wildwoodashes/nixie_clock/doc/slike-pictures/seven.jpg

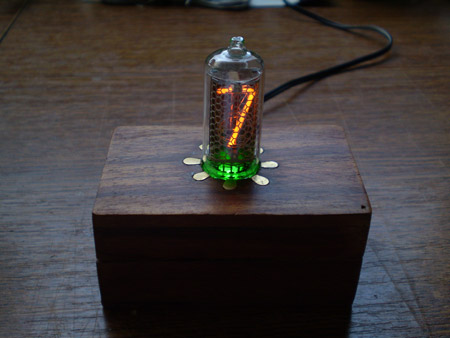
doc/slike-pictures/seven.jpg
