wildwoodashes/nixie_clock/doc/pcb/pcb_top.jpg

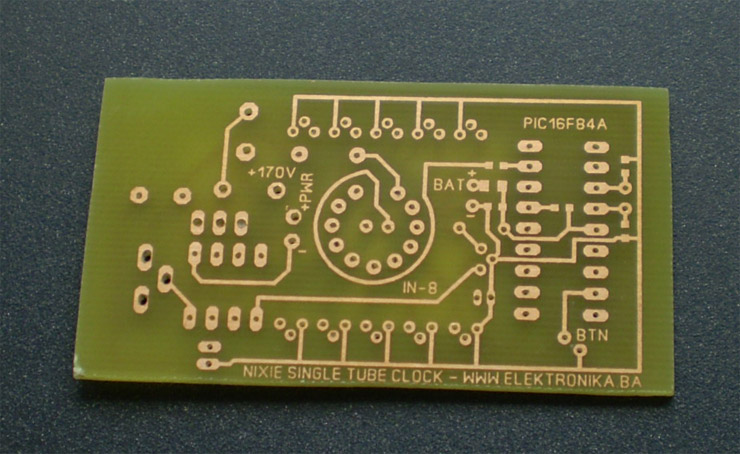
doc/pcb/pcb_top.jpg
