wildwoodashes/nixie_clock/doc/pcb/README.txt

Ploèica je crtana u sPrint-Layout programu
/PCB is in sPrint-Layout format

FILE: nixieclk.LAY
