wildwoodashes/nixie_clock/doc/dat-in-8.gif

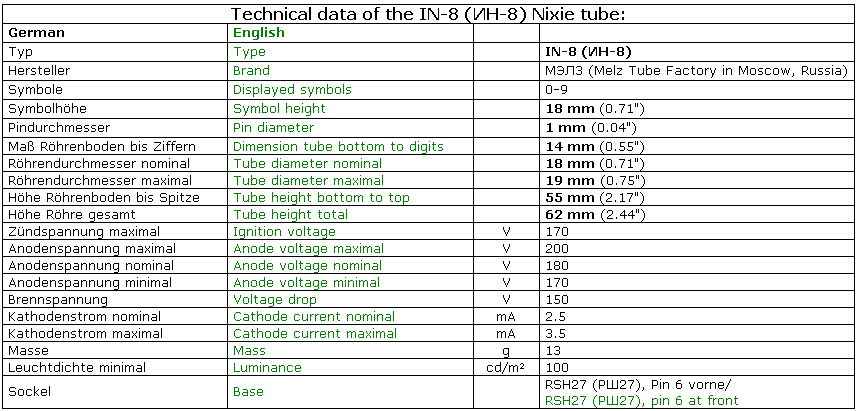
doc/dat-in-8.gif
