wildwoodashes/nixie_clock/doc/nixie_tube_datasheets/in8-base.jpg

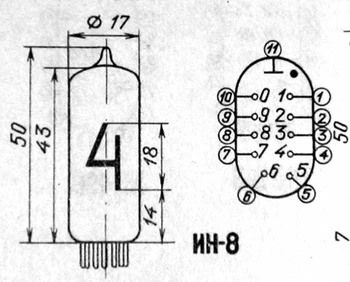
doc/nixie_tube_datasheets/in8-base.jpg
