wildwoodashes/nixie_clock/doc/nixie_tube_datasheets/Pinout.PNG

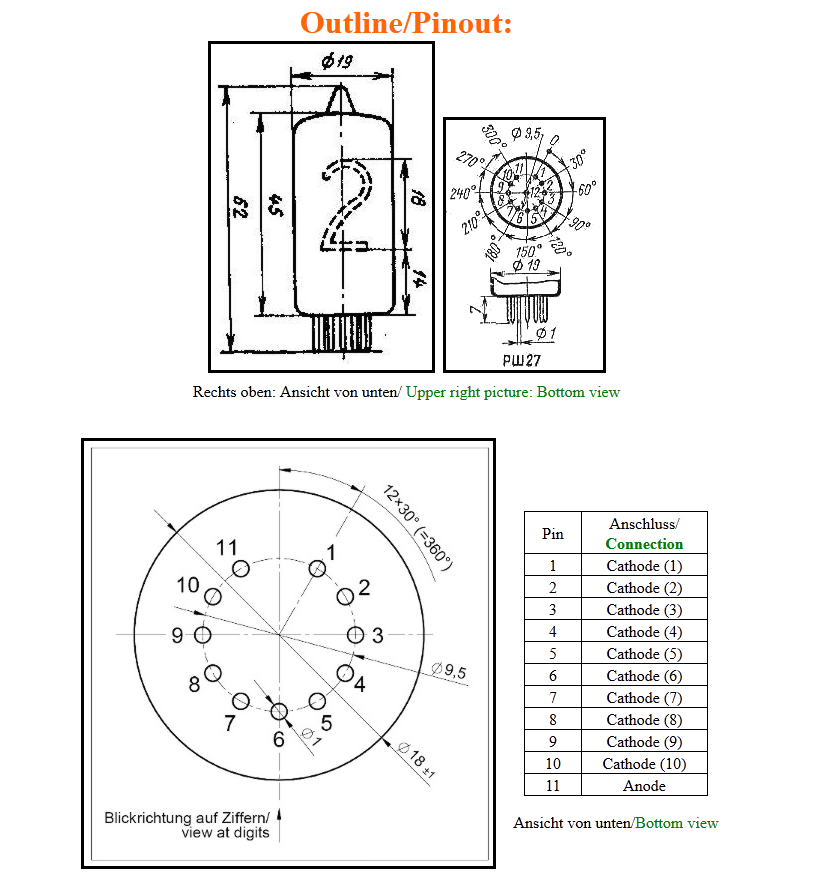
doc/nixie_tube_datasheets/Pinout.PNG
