wildwoodashes/nixie_clock/doc/pcb/pcb_bottom.gif

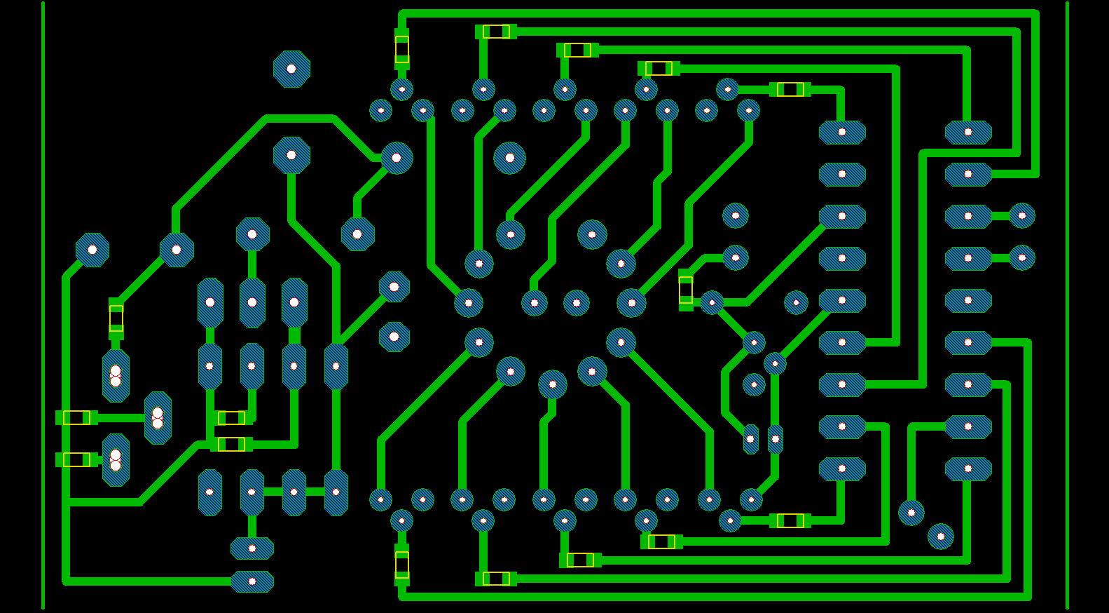
doc/pcb/pcb_bottom.gif
