wildwoodashes/nixie_clock/doc/pcb/pcb_bottom.jpg

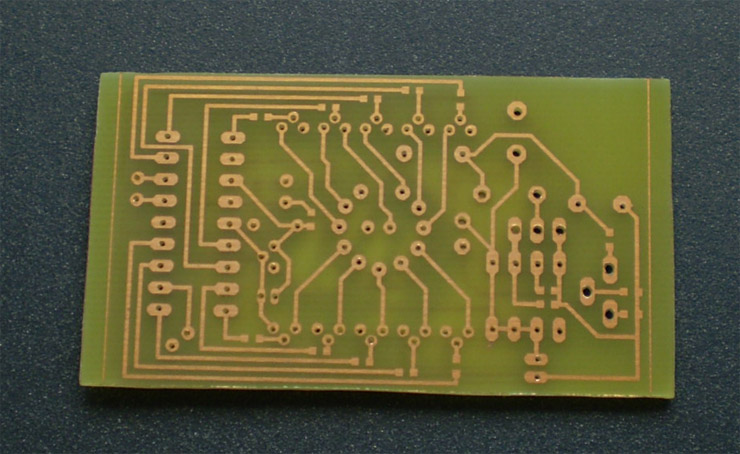
doc/pcb/pcb_bottom.jpg
