wildwoodashes/nixie_clock/doc/pcb/pcb_top.gif

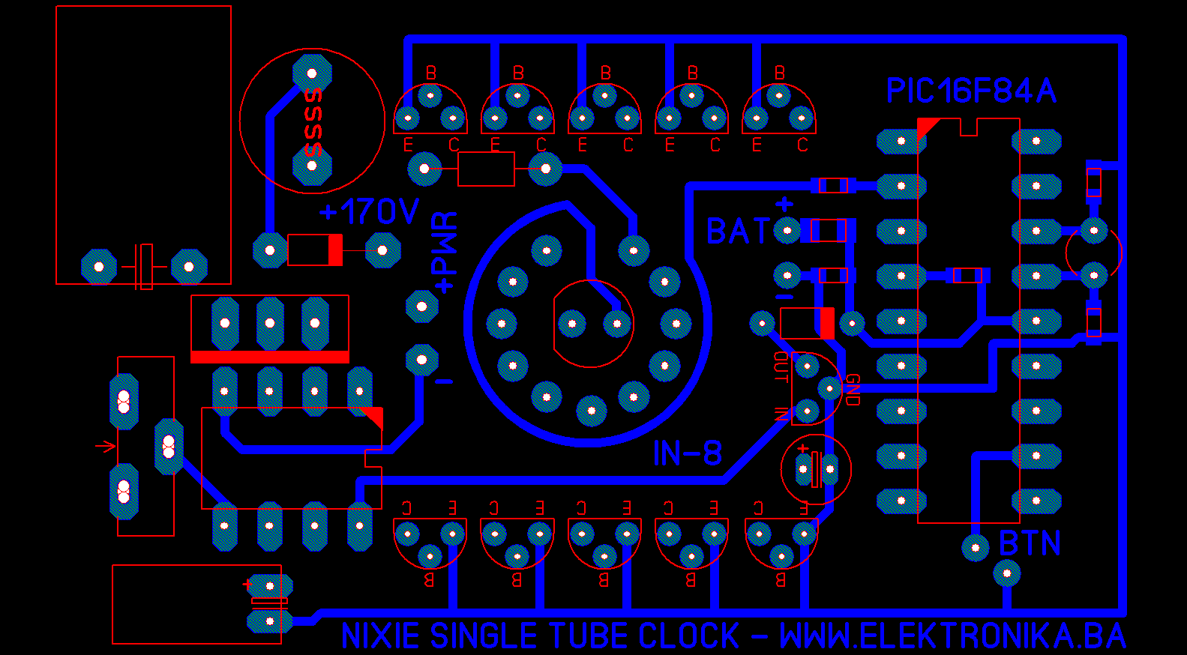
doc/pcb/pcb_top.gif
