wildwoodashes/nixie_clock/doc/shema-schematics/shema.png

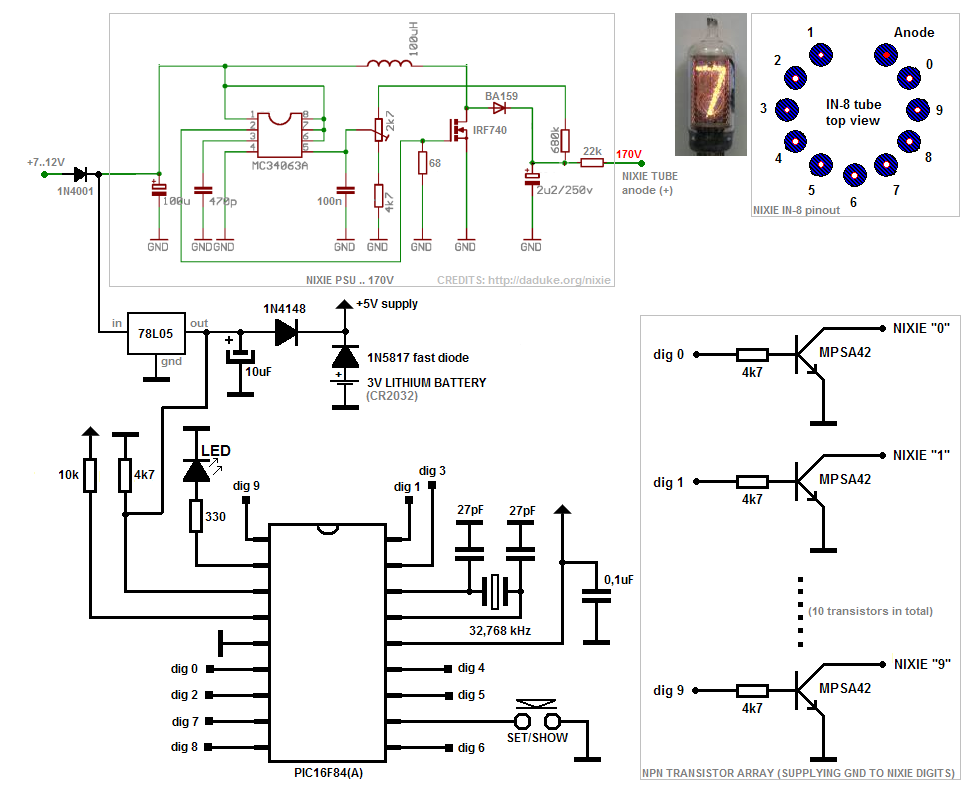
doc/shema-schematics/shema.png
