wildwoodashes/nixie_clock/doc/slike-pictures/back_side.jpg

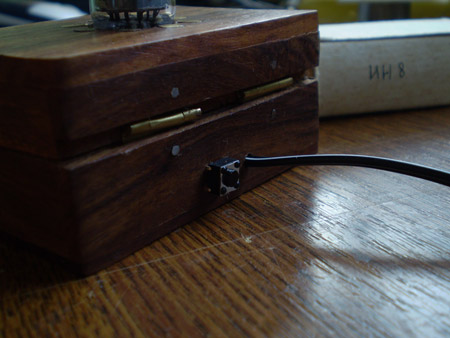
doc/slike-pictures/back_side.jpg
