wildwoodashes/nixie_clock/doc/slike-pictures/just_led.jpg

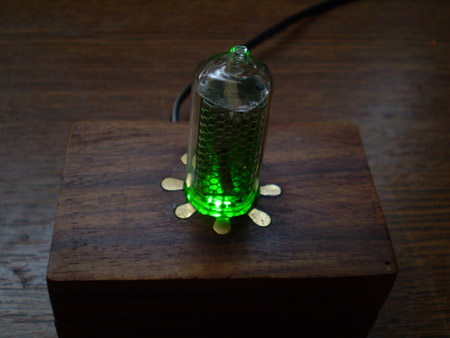
doc/slike-pictures/just_led.jpg
