wildwoodashes/nixie_clock/doc/slike-pictures/open.jpg

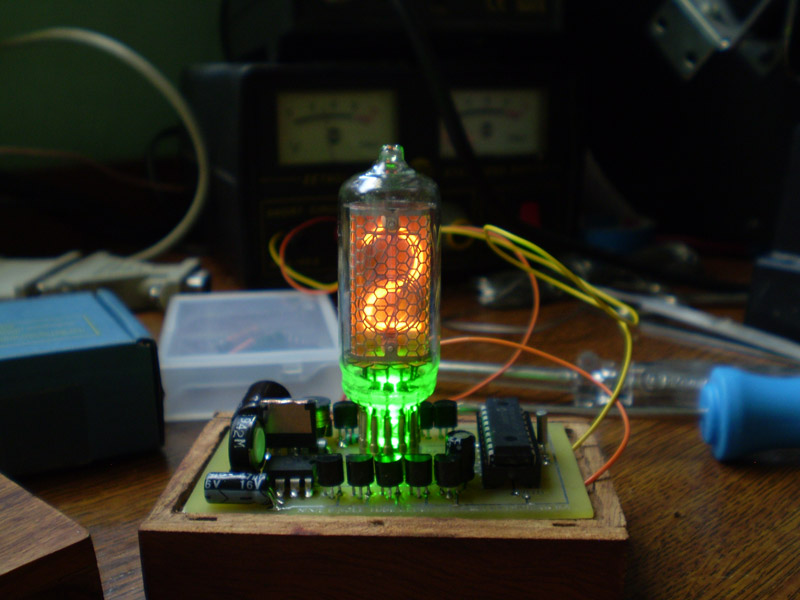
doc/slike-pictures/open.jpg
