wildwoodashes/nixie_clock/doc/slike-pictures/open_eight.jpg

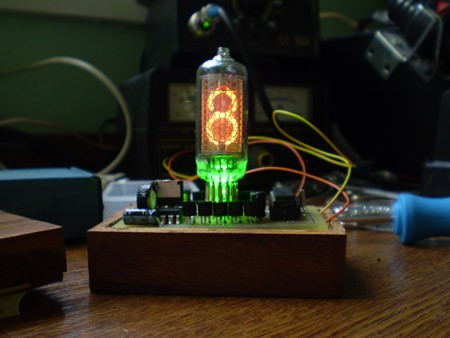
doc/slike-pictures/open_eight.jpg
