wildwoodashes/nixie_clock/doc/slike-pictures/two.jpg

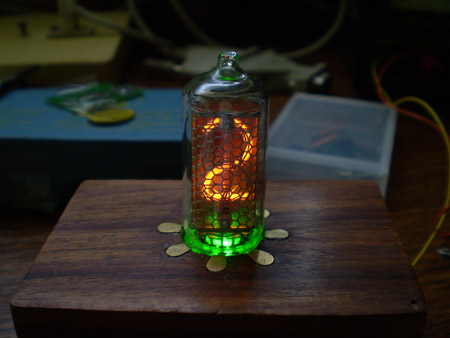
doc/slike-pictures/two.jpg
