wildwoodashes/nixie_clock/doc/pcb/pcb_bottom_parts.gif

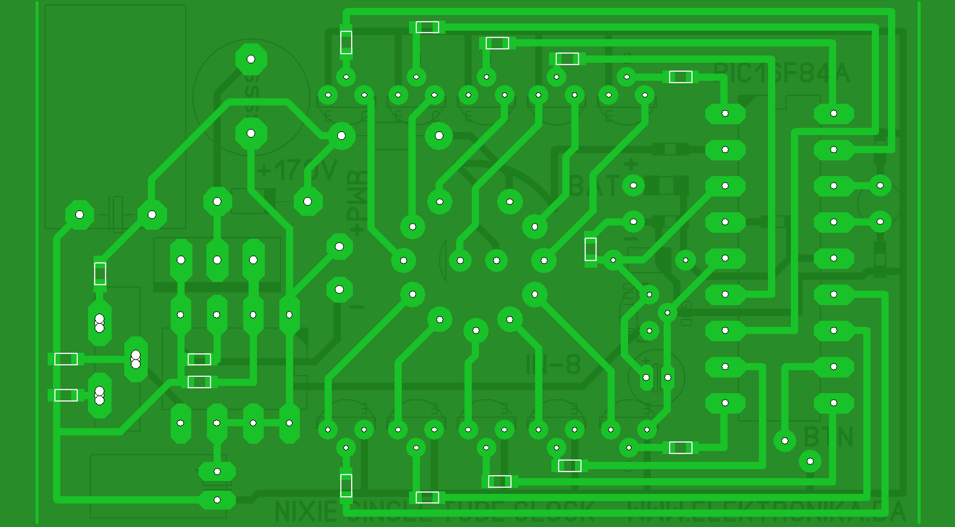
doc/pcb/pcb_bottom_parts.gif
