wildwoodashes/nixie_clock/doc/pcb/pcb_top_parts.gif

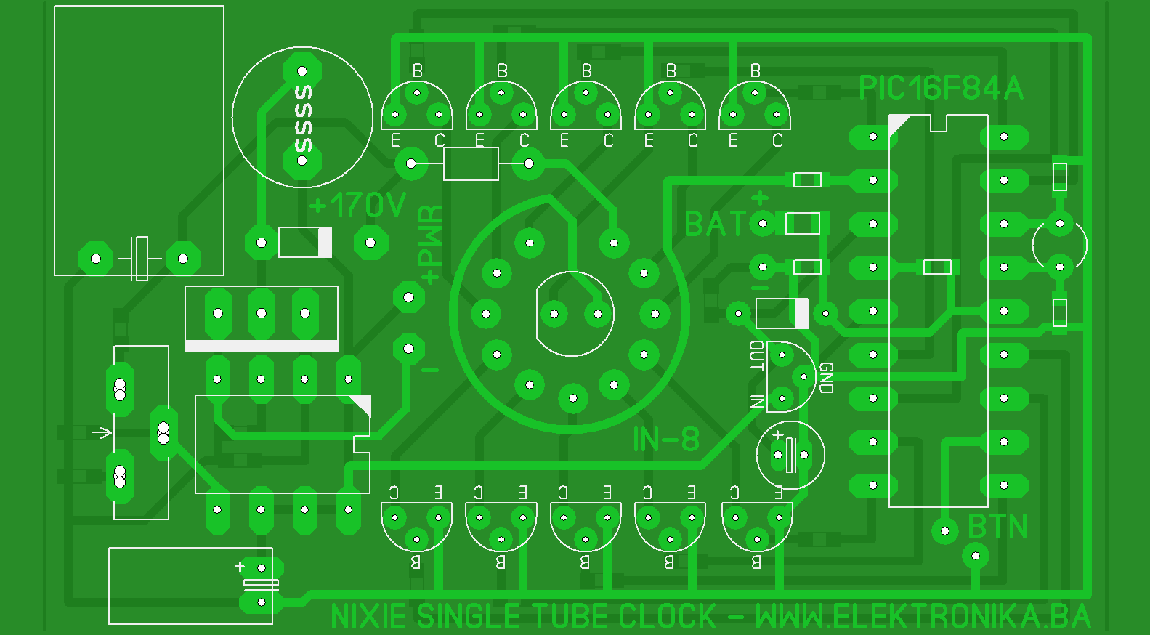
doc/pcb/pcb_top_parts.gif
