wildwoodashes/nixie_clock/hw/control_board_v1_0.pdf

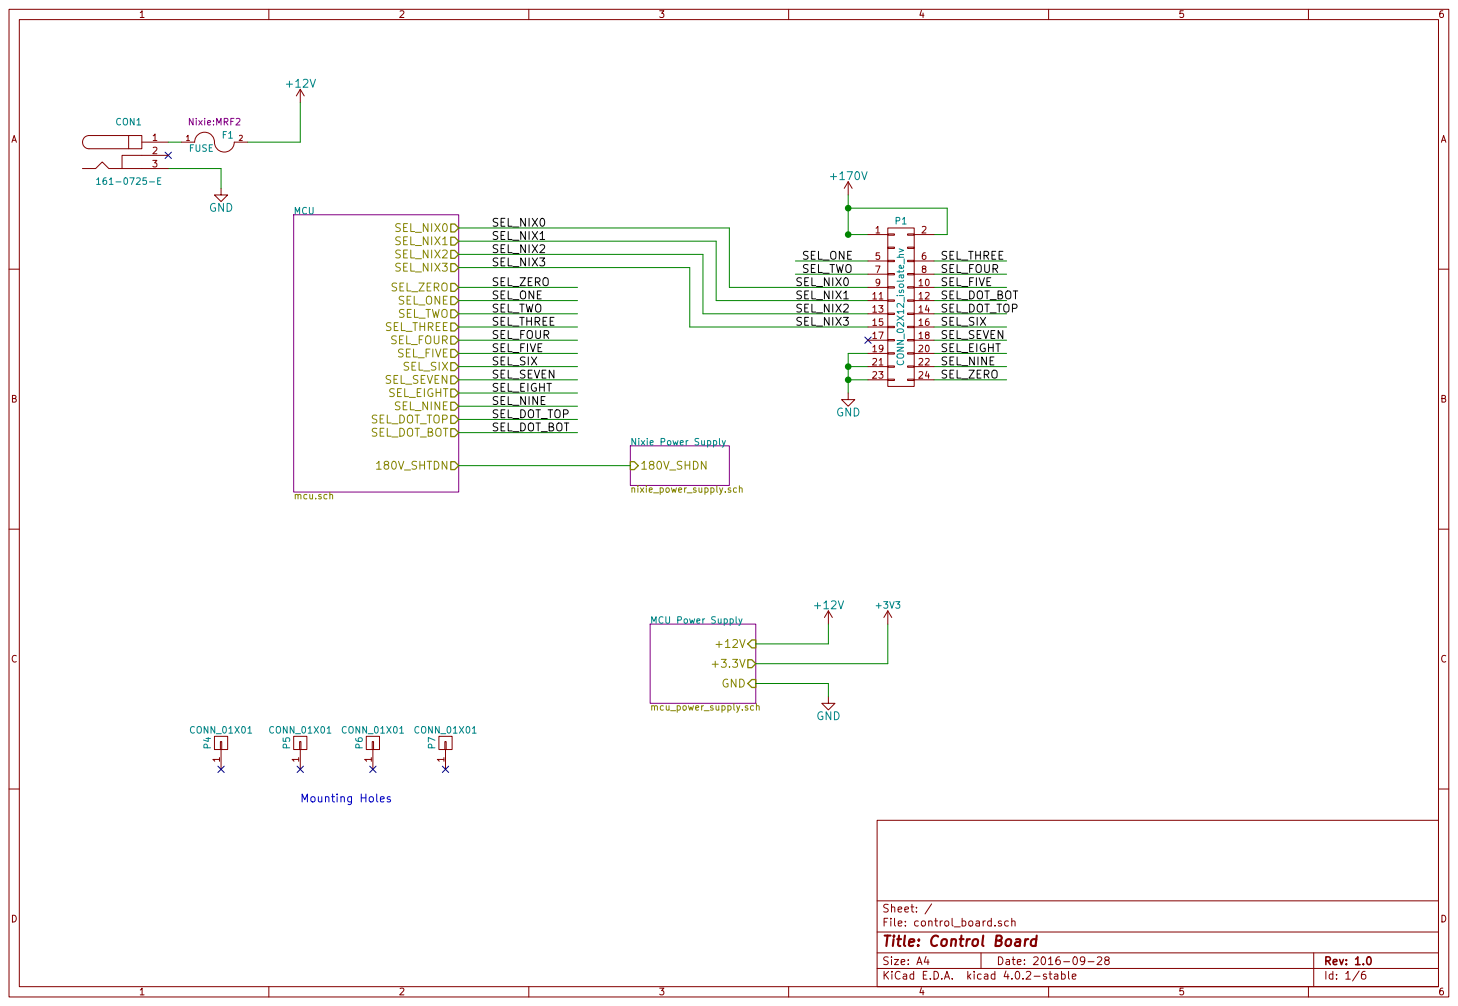
[picture p17: page 1]

SEL_NIX0 SEL_NIX1 SEL_NIX2 SEL_NIX3 SEL_TWO SEL_FOUR SEL_SEVEN SEL_DOT_TOP 180V_SHTDN | SEL_SIX

SEL_NIX1
SEL_NIX2
SEL_NIX3

20 SEL_EIGHT

21 | SEL_NINE 22
23 | 24

180V_SHDN

File: control_board.sch Sheet: /
Id: 1/6 Title: Control Board

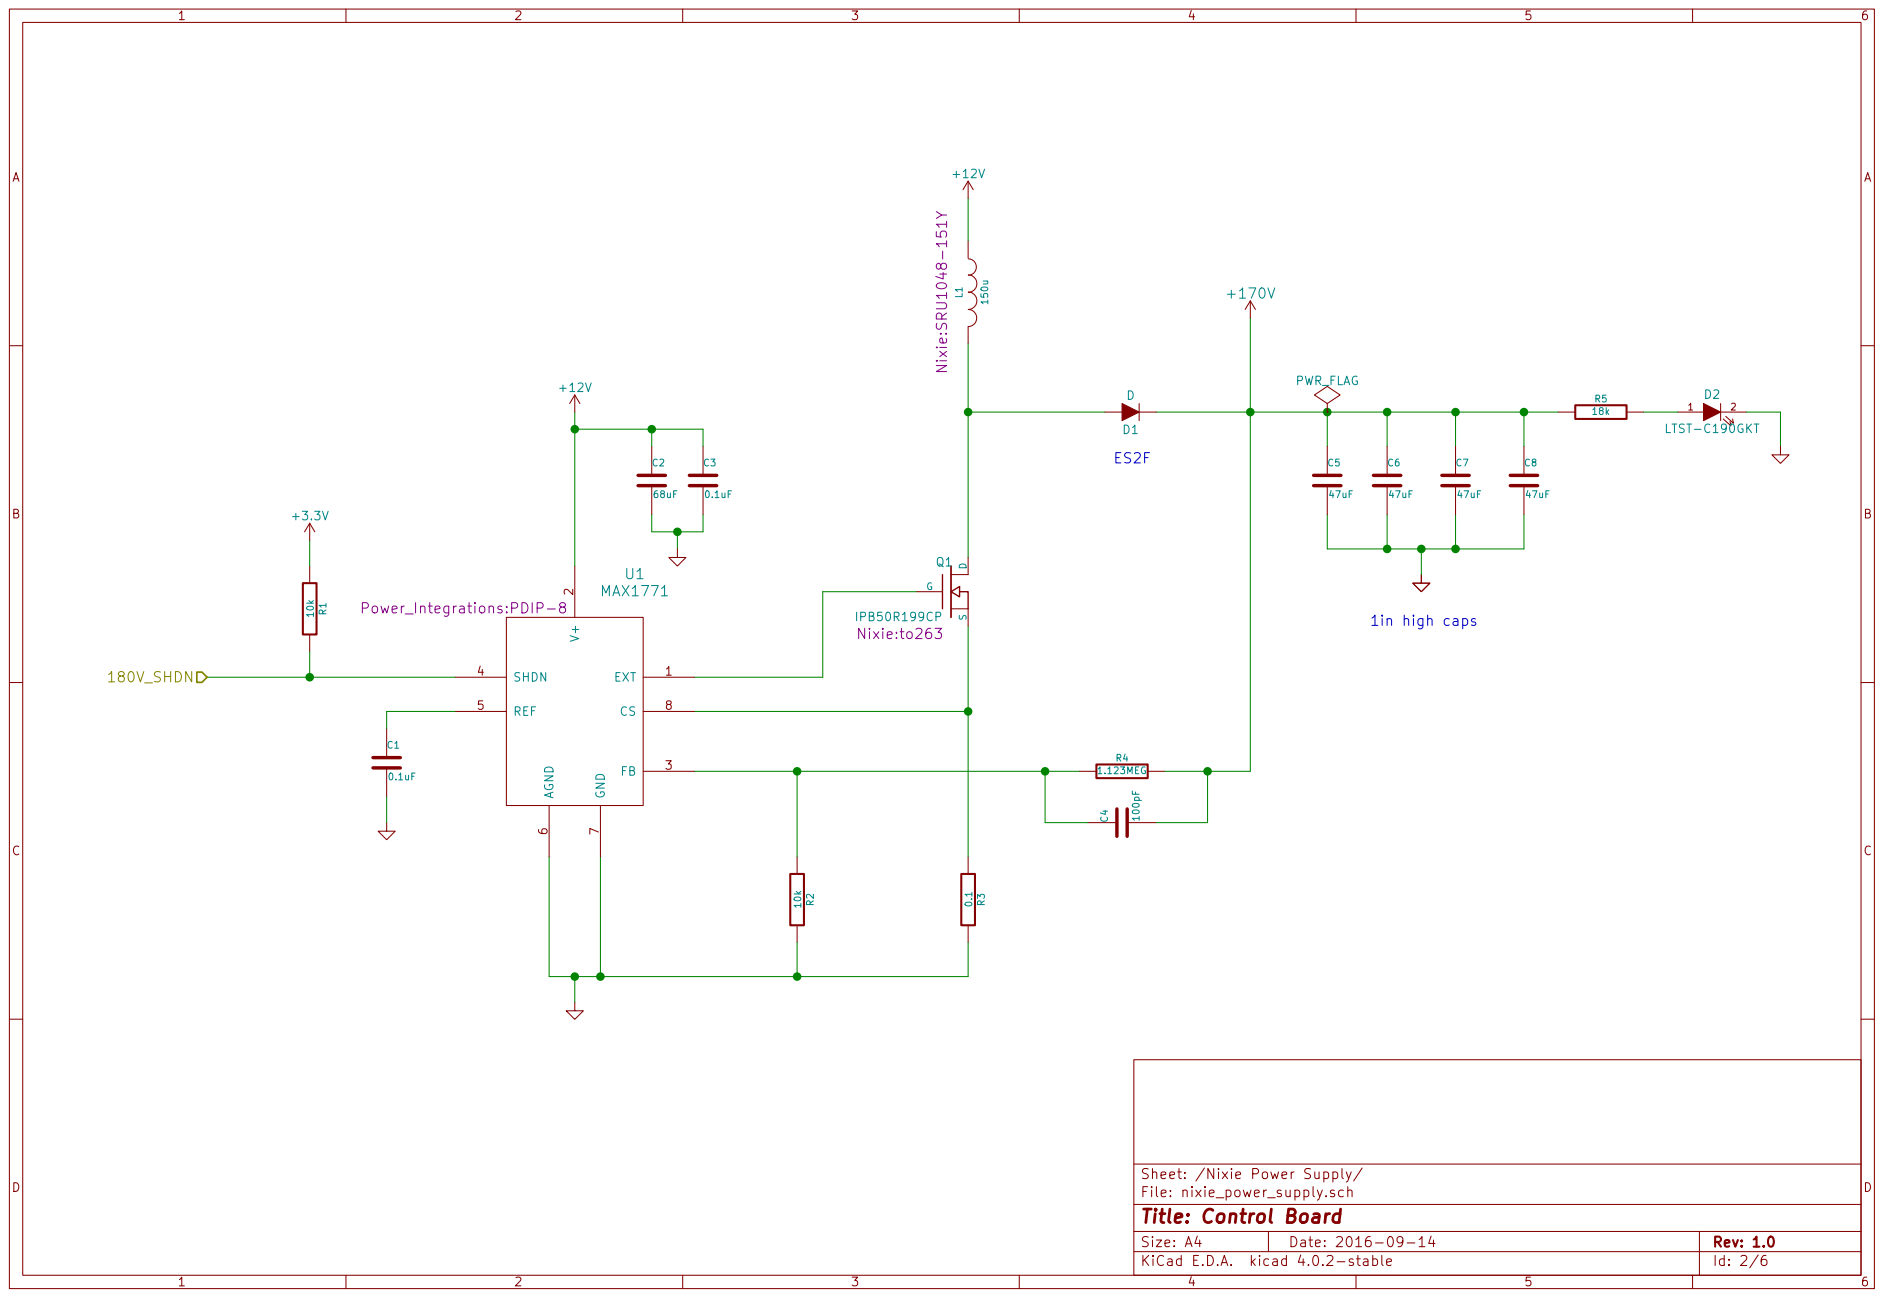
[picture p18: page 2]

2 FB 3 SHDN 4 REF 5 AGND

File: nixie_power_supply.sch
Id: 2/6 Title: Control Board

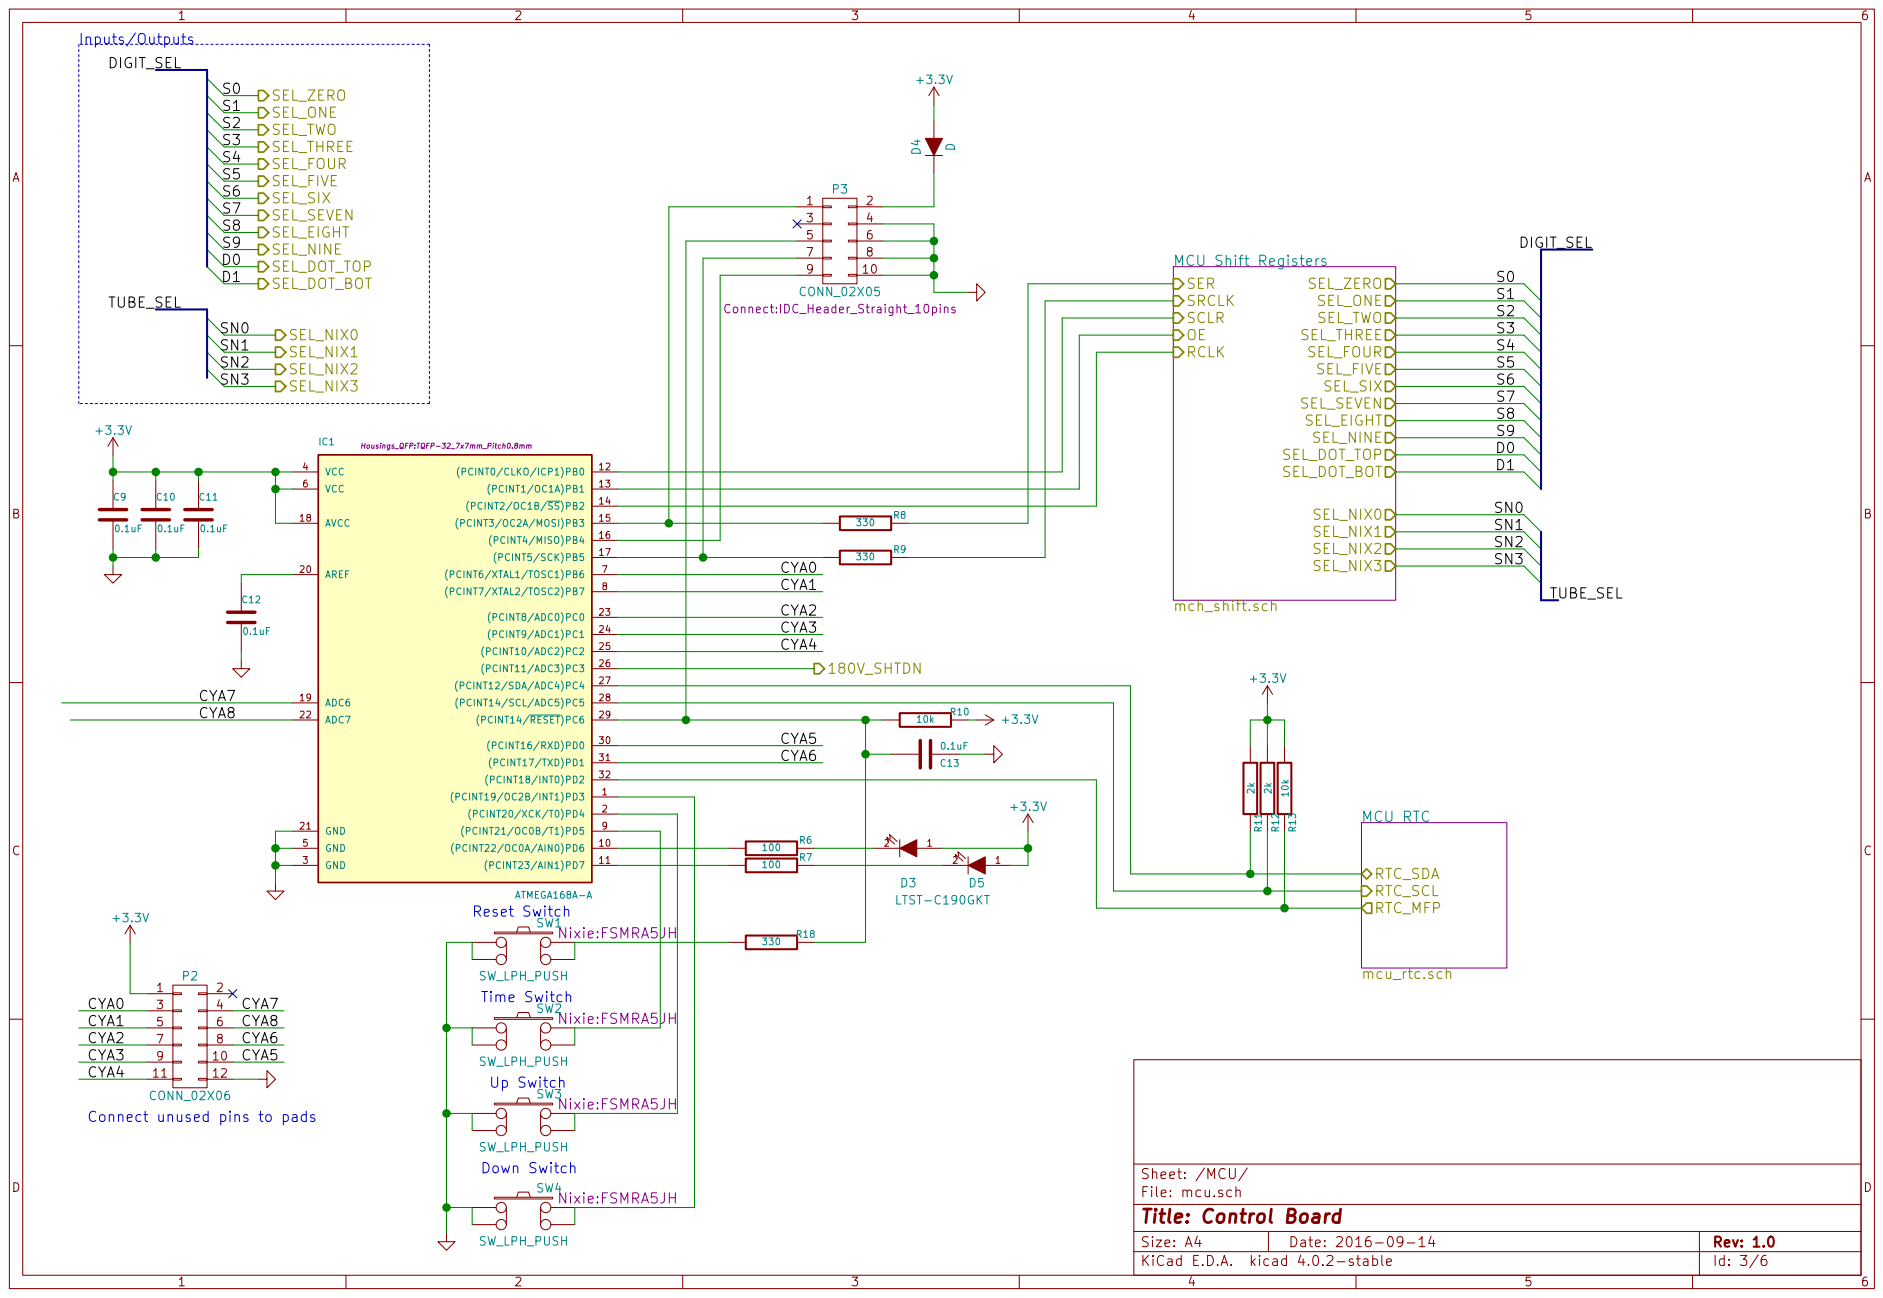
[picture p19: page 3]

File: mcu.sch Sheet: /MCU/
Id: 3/6 Title: Control Board

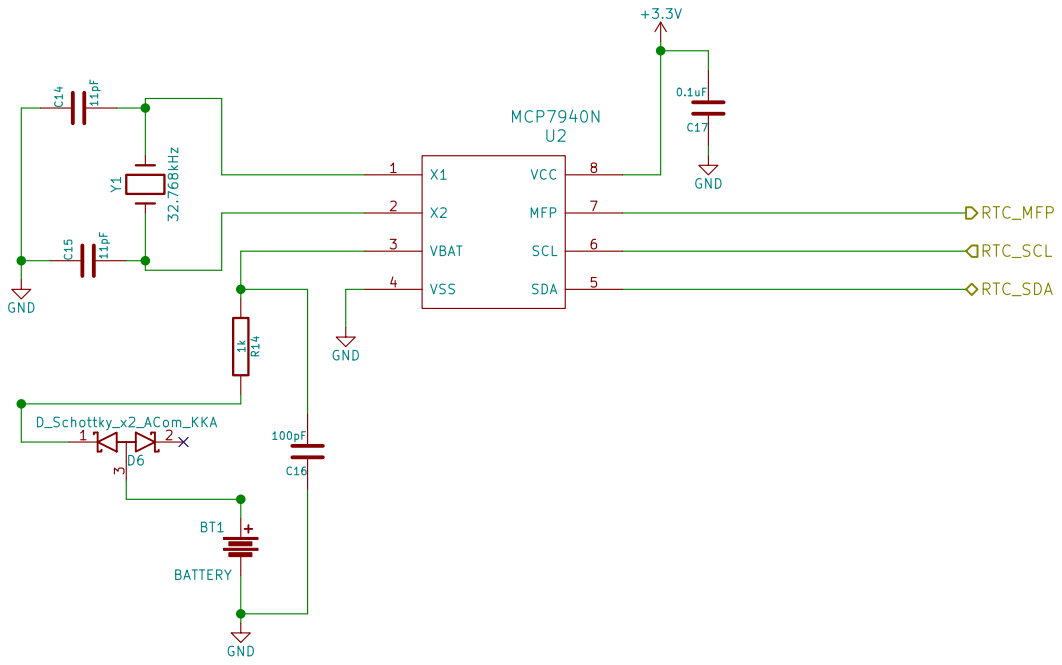
[picture p20: page 4]

Id: 4/6 Title: Control Board

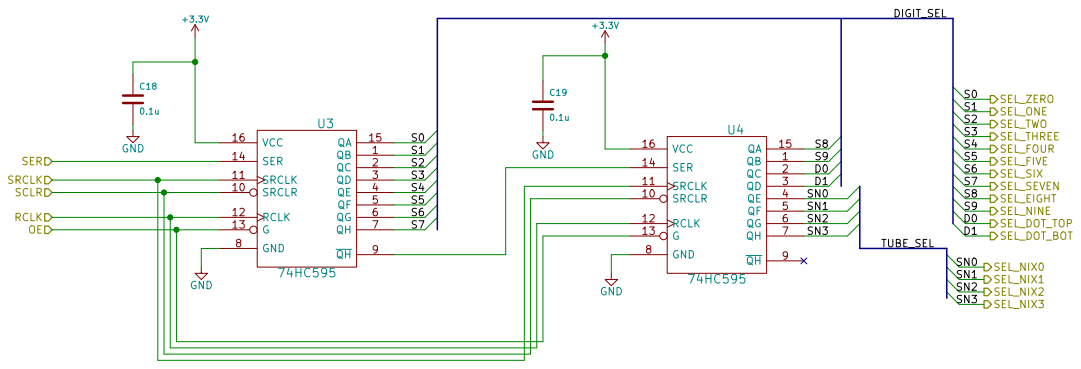
[picture p21: page 5]

Sheet: /MCU/MCU Shift Registers/
File: mch_shift.sch
Id: 5/6 Title: Control Board

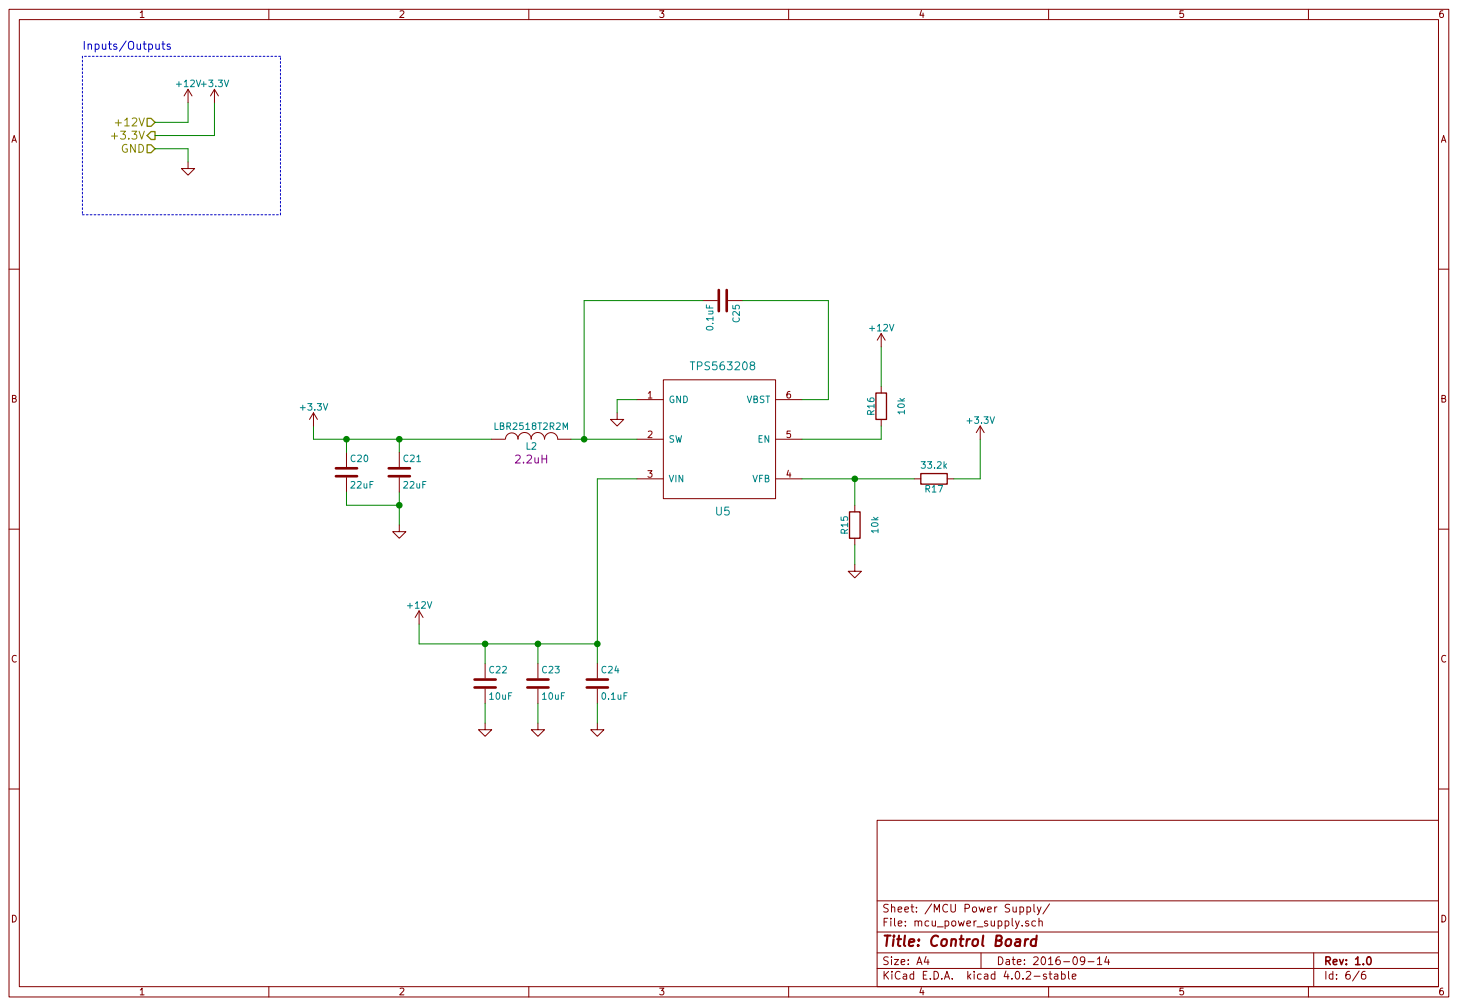
[picture p22: page 6]

Sheet: /MCU Power Supply/
File: mcu_power_supply.sch
Id: 6/6 Title: Control Board
