wildwoodashes/nixie_clock/hw/tube_shield_v1_0.pdf

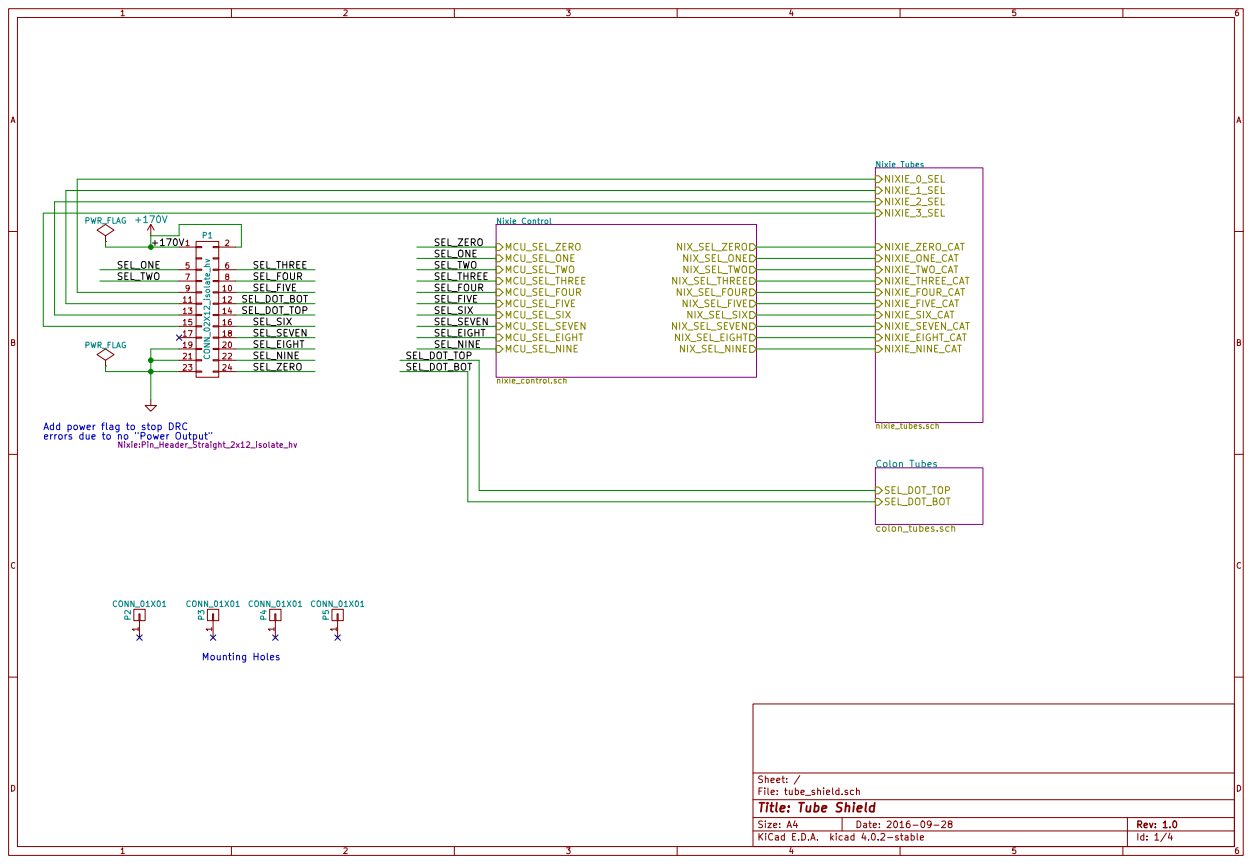
[picture p23: page 1]

NIX_SEL_NINE PWR_FLAG Add power flag to stop DRC

errors due to no "Power Output" 1 P2 CONN_01X01

File: tube_shield.sch Sheet: /
Id: 1/4 Title: Tube Shield

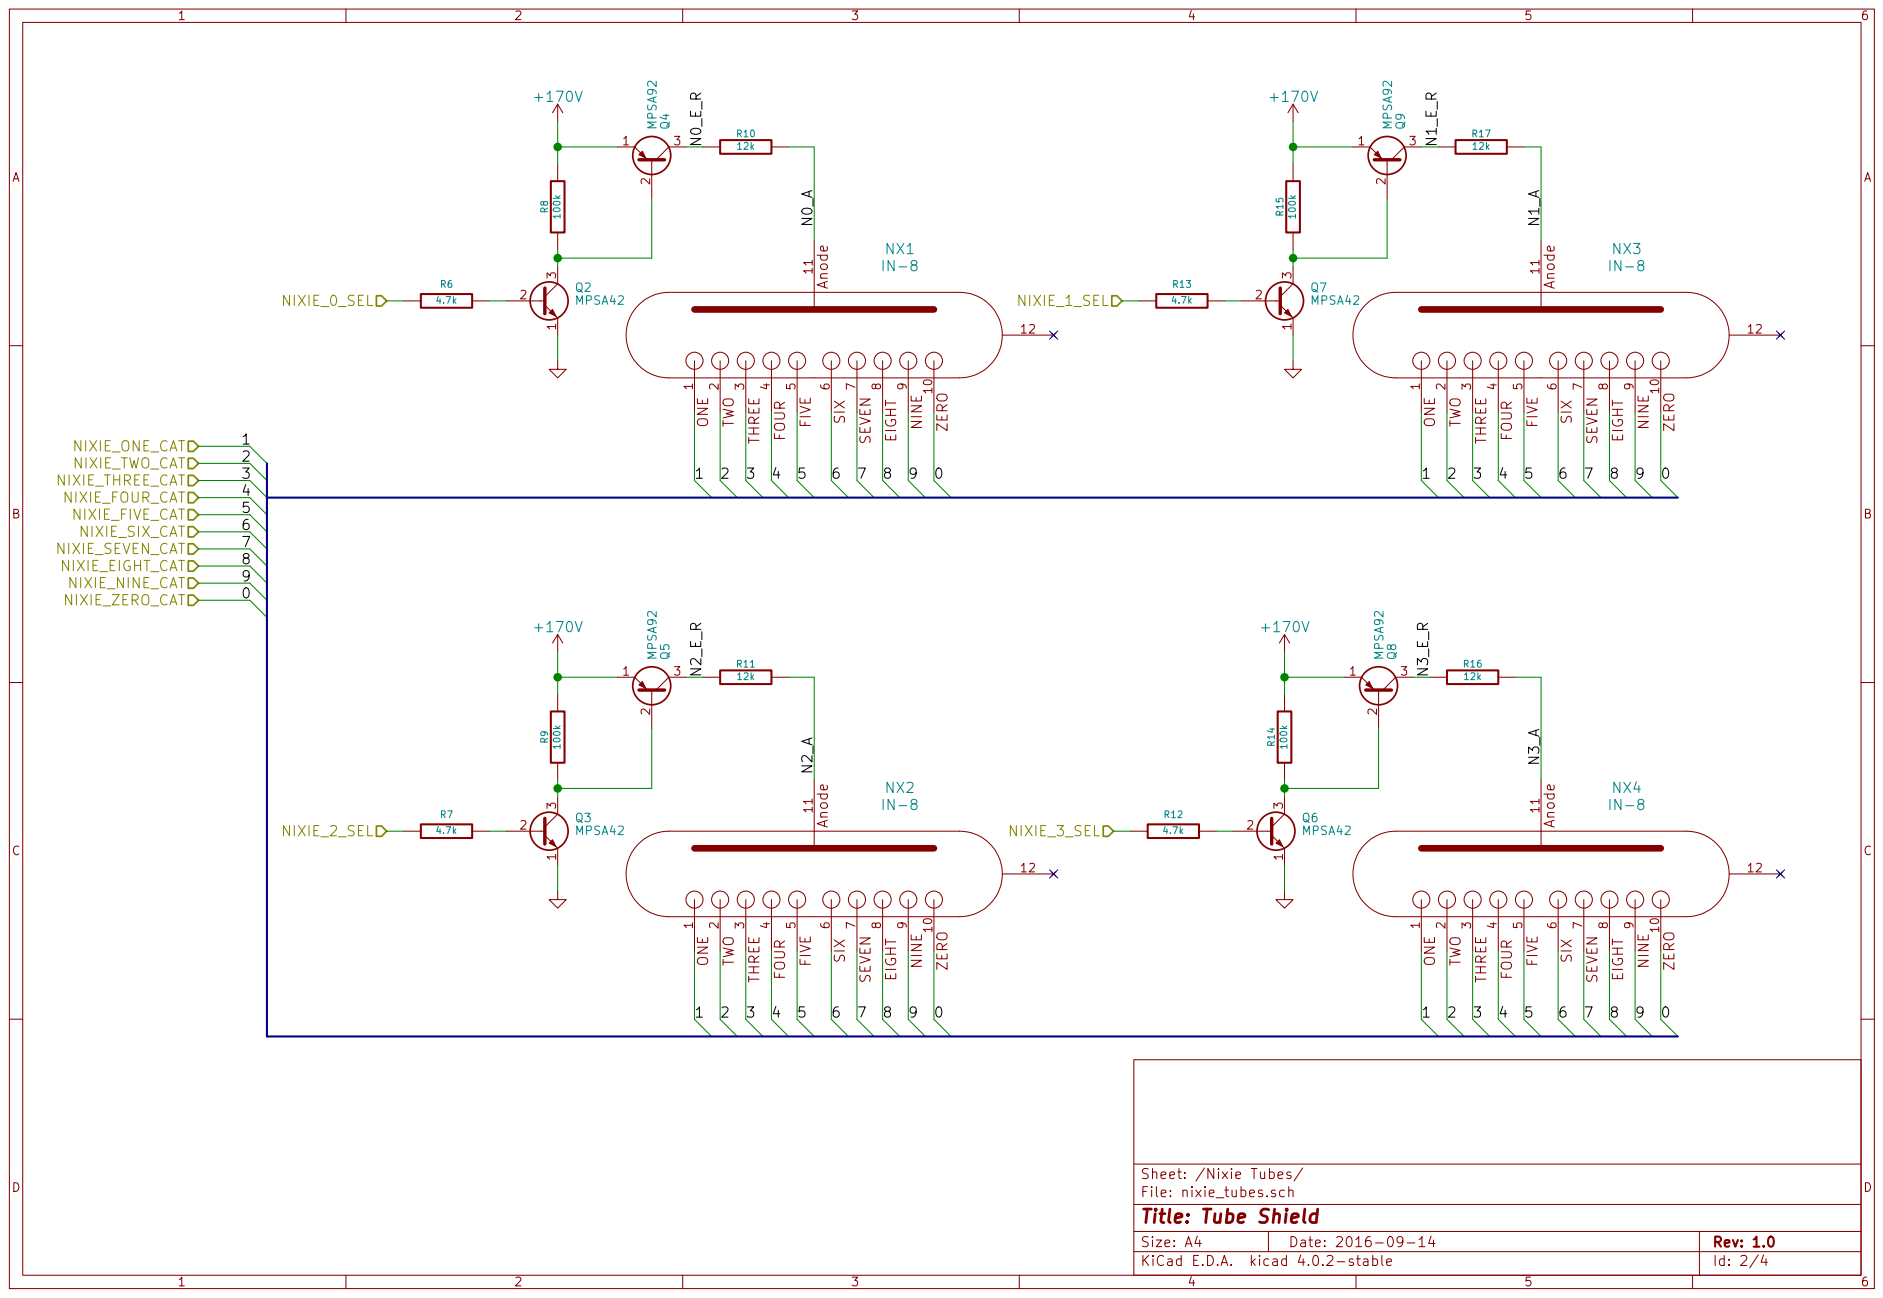
[picture p24: page 2]

File: nixie_tubes.sch Sheet: /Nixie Tubes/
Id: 2/4 Title: Tube Shield

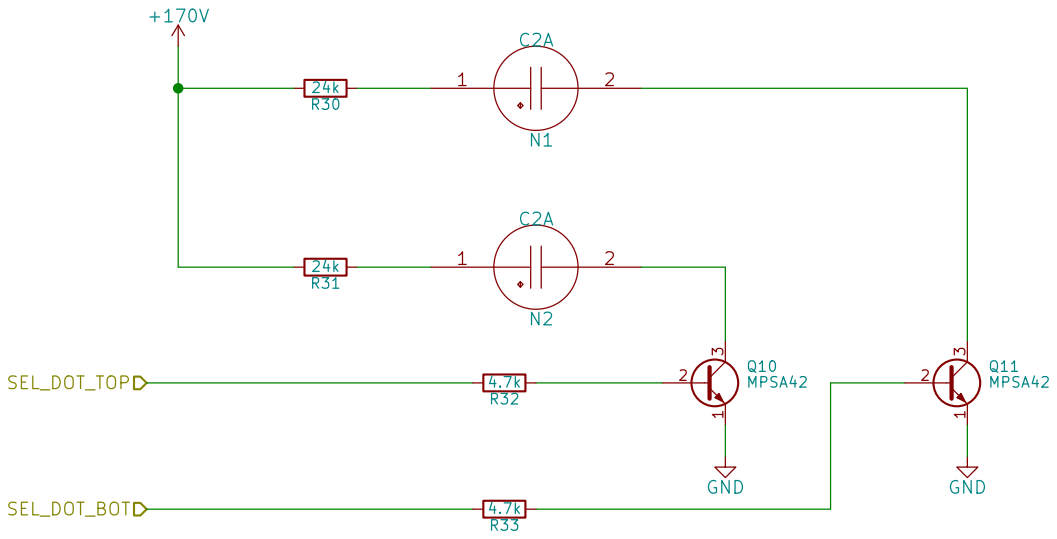
[picture p25: page 3]

File: colon_tubes.sch Sheet: /Colon Tubes/ .

Id: 3/4 Title: Tube Shield

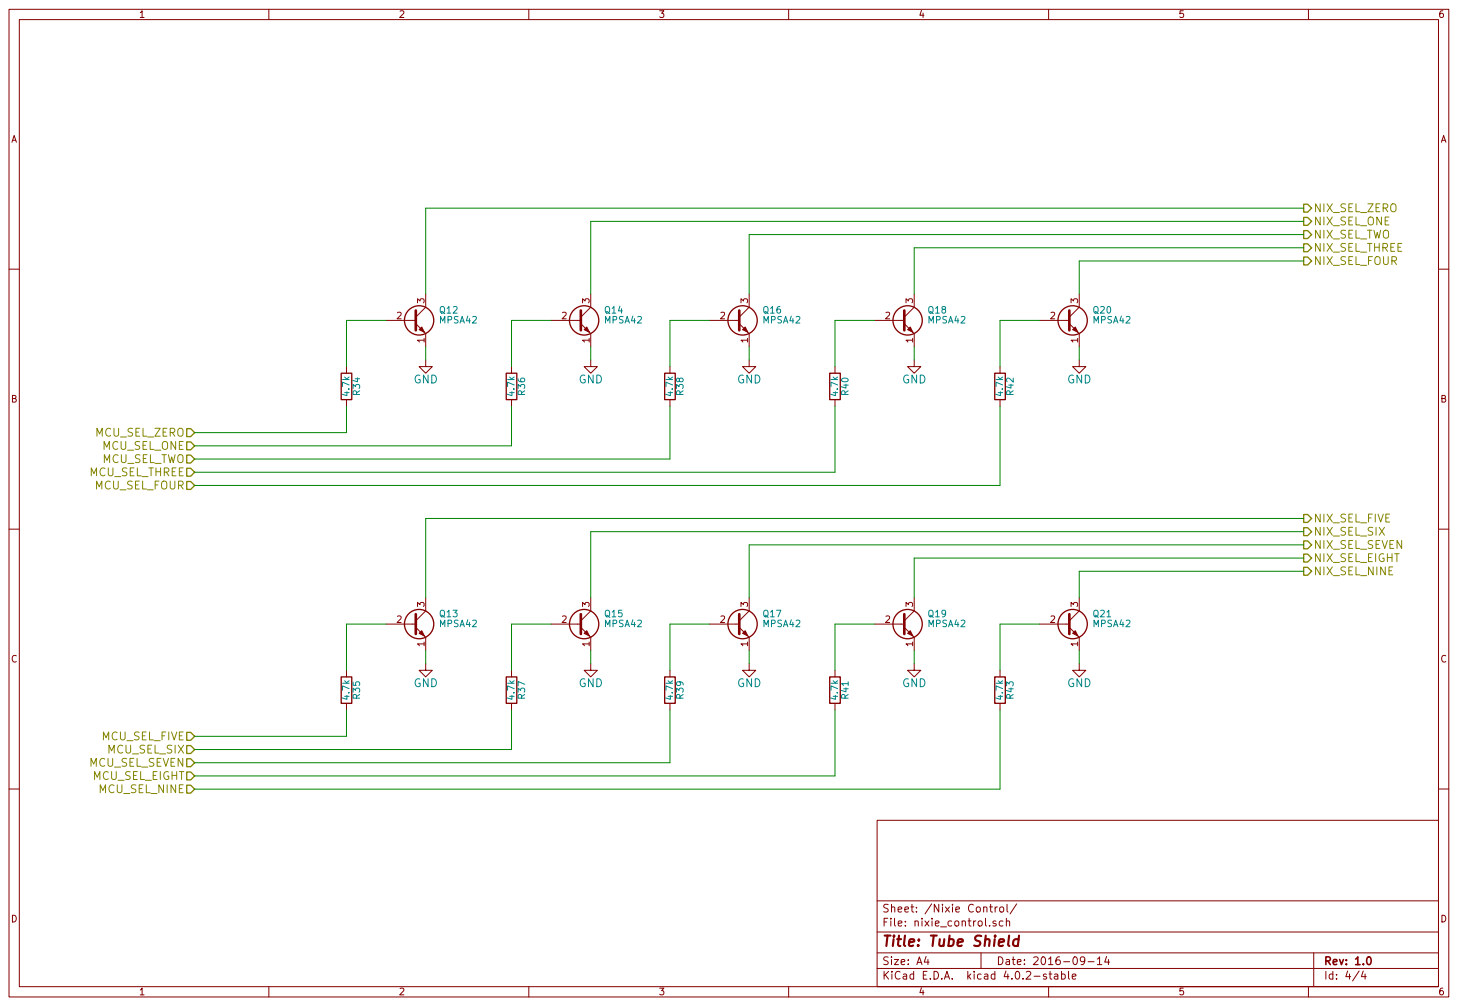
[picture p26: page 4]

Id: 4/4 Title: Tube Shield
