wildwoodashes/nixie_clock/hw/kicad_v1_1/projects/control_board/gerbers/control_board.pdf

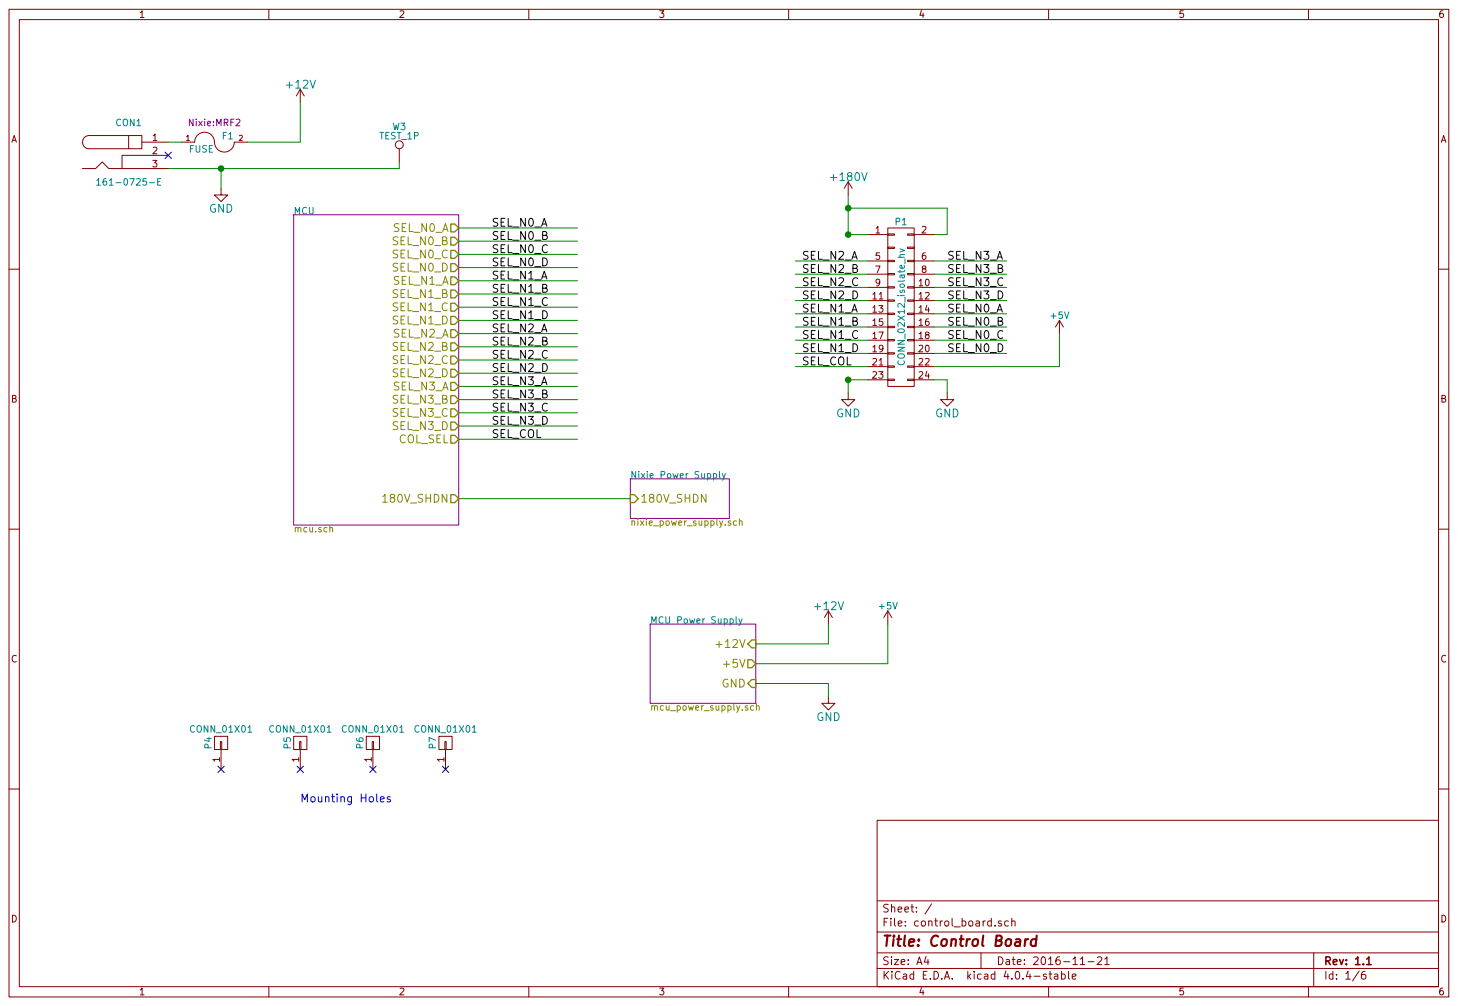
[picture p27: page 1]

SEL_N0_B SEL_N0_C SEL_N0_D SEL_N1_A SEL_N1_B SEL_N1_C SEL_N1_D SEL_N2_A SEL_N2_B SEL_N2_C SEL_N2_D SEL_N3_A SEL_N3_B SEL_N3_C SEL_N3_D 180V_SHDN

File: control_board.sch Sheet: / Nixie Power Supply

180V_SHDN

Id: 1/6 Title: Control Board

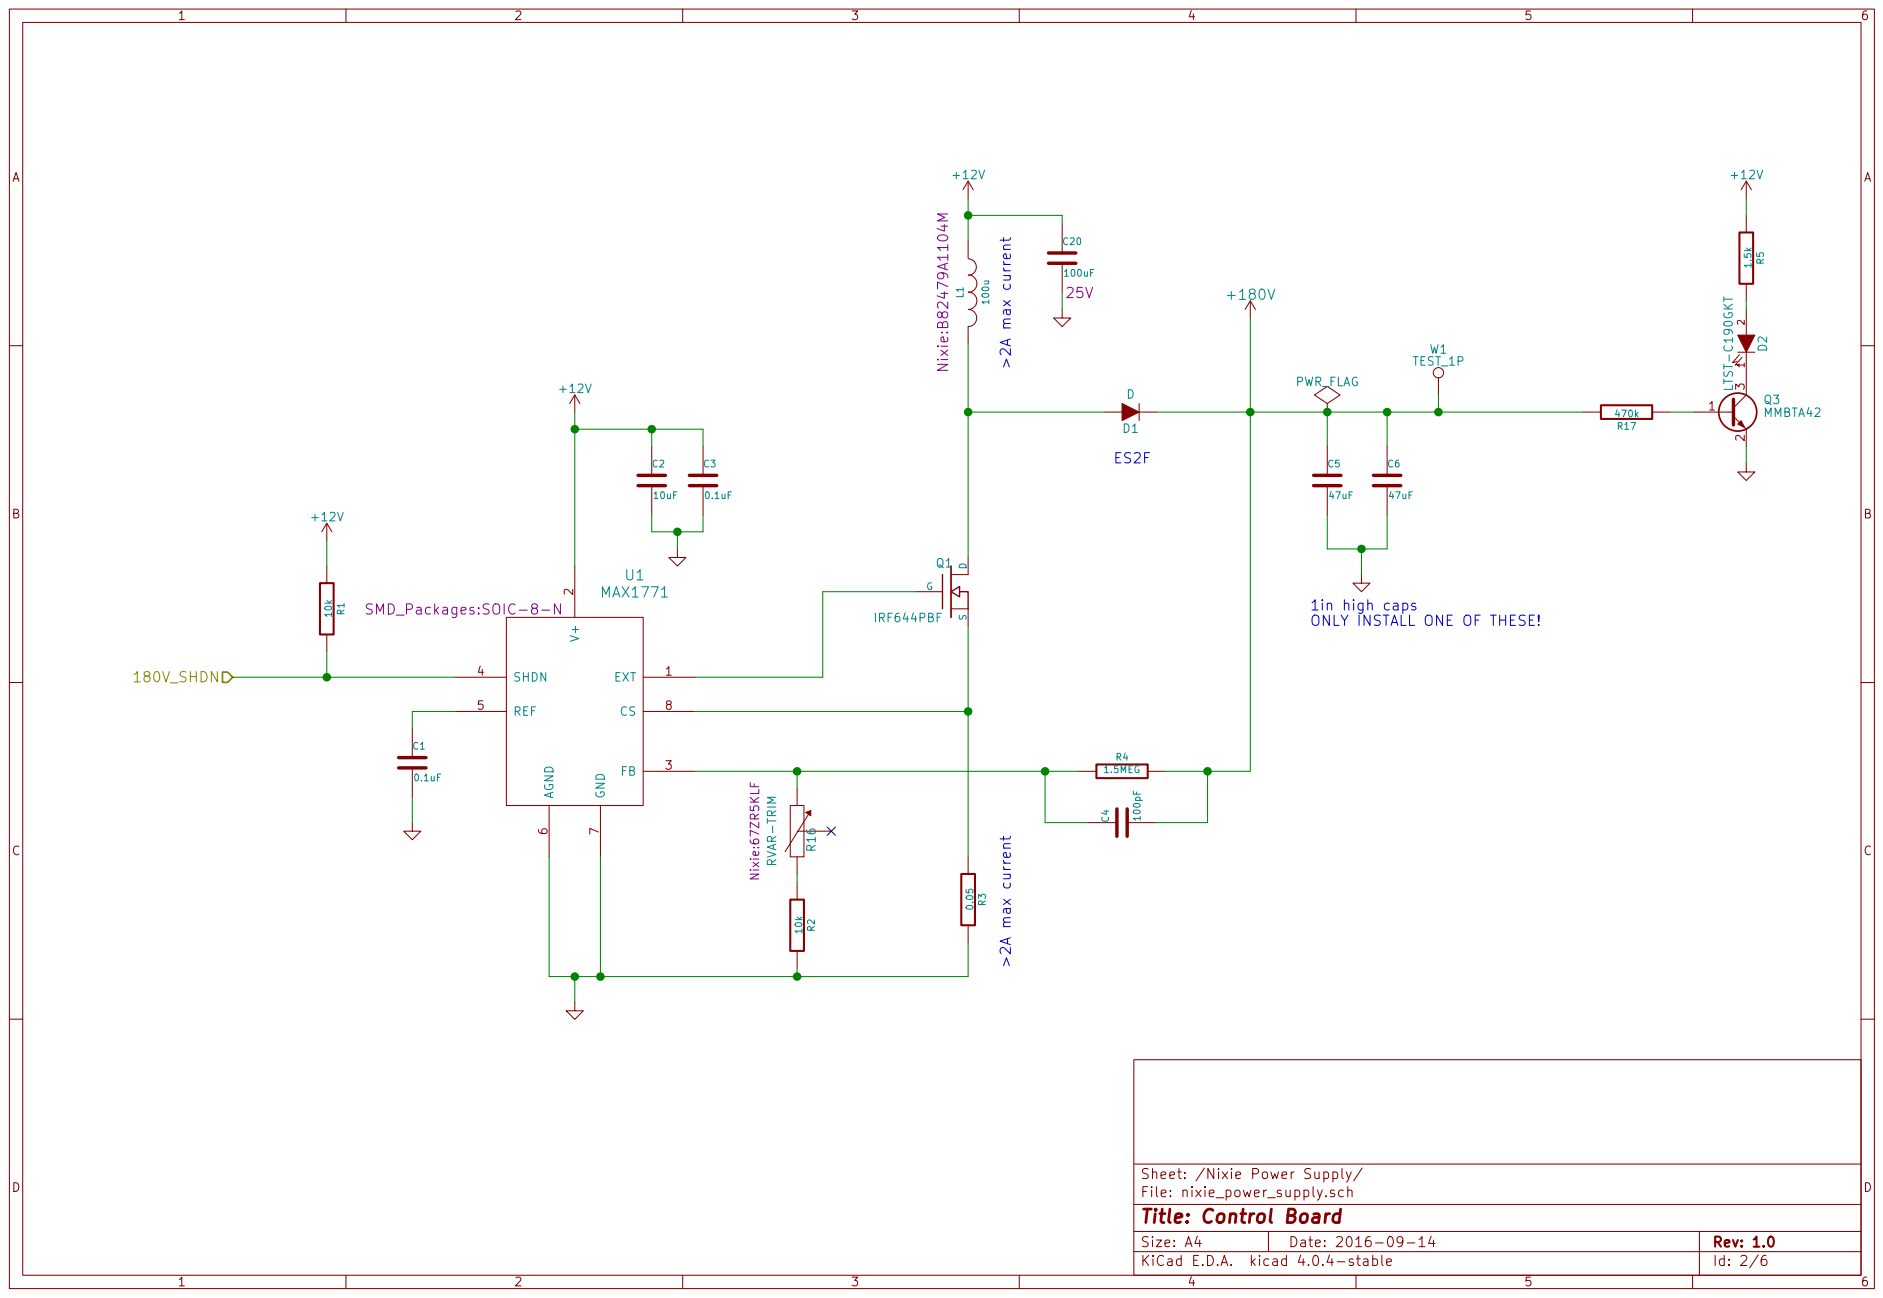
[picture p28: page 2]

2 FB 3 SHDN 4 REF 5 AGND

1in high caps
ONLY INSTALL ONE OF THESE!

File: nixie_power_supply.sch
Id: 2/6 Title: Control Board

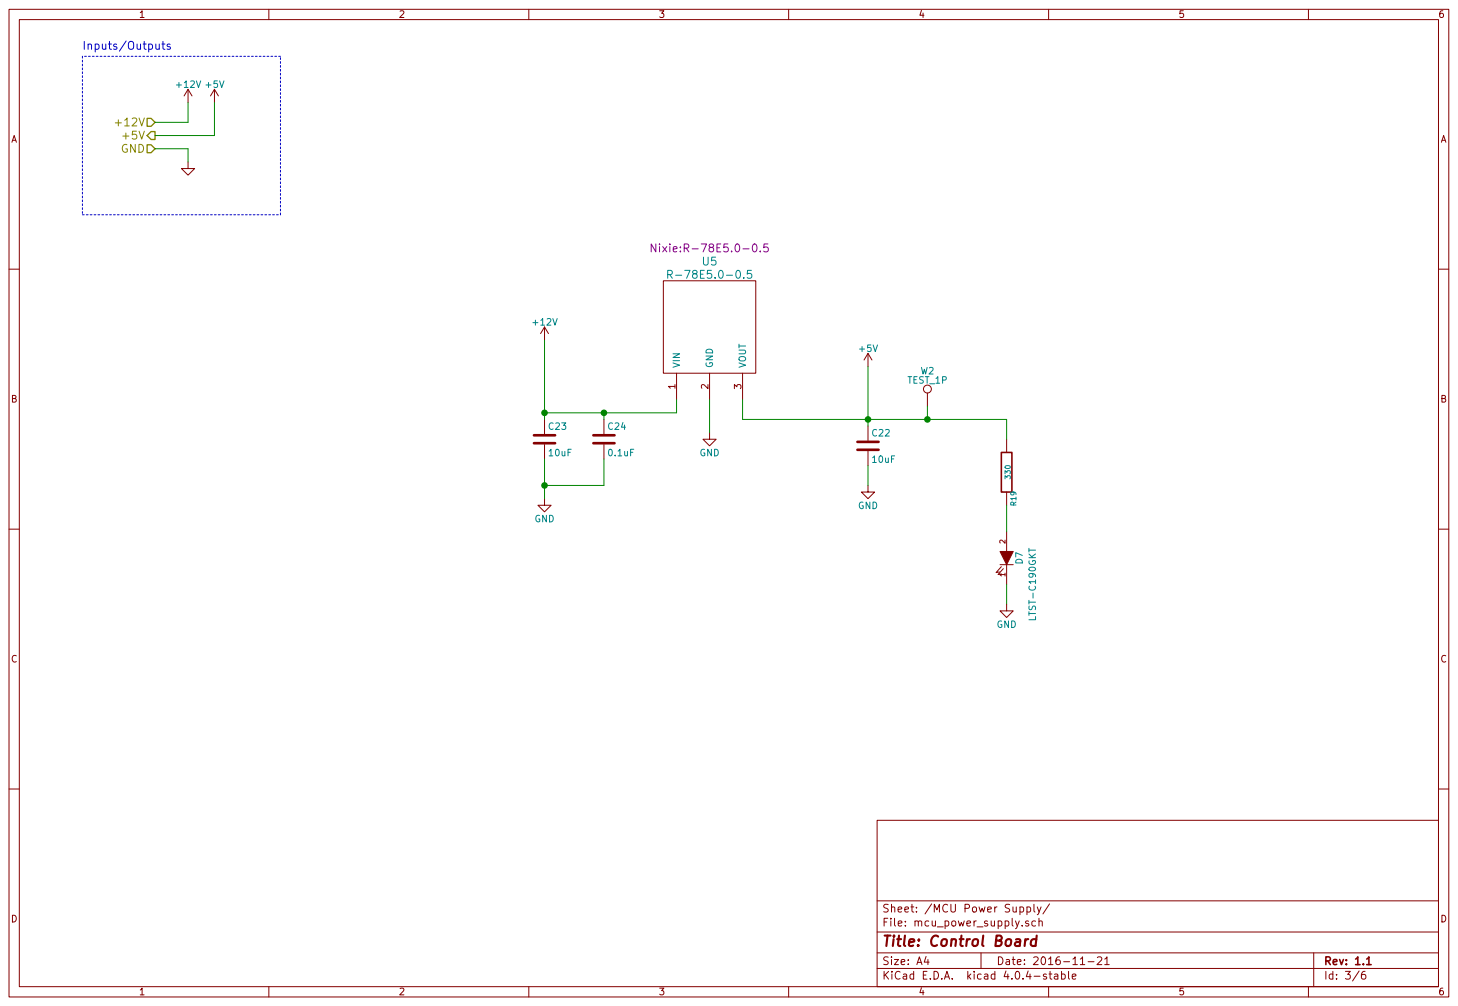
[picture p29: page 3]

Sheet: /MCU Power Supply/
File: mcu_power_supply.sch
Id: 3/6 Title: Control Board

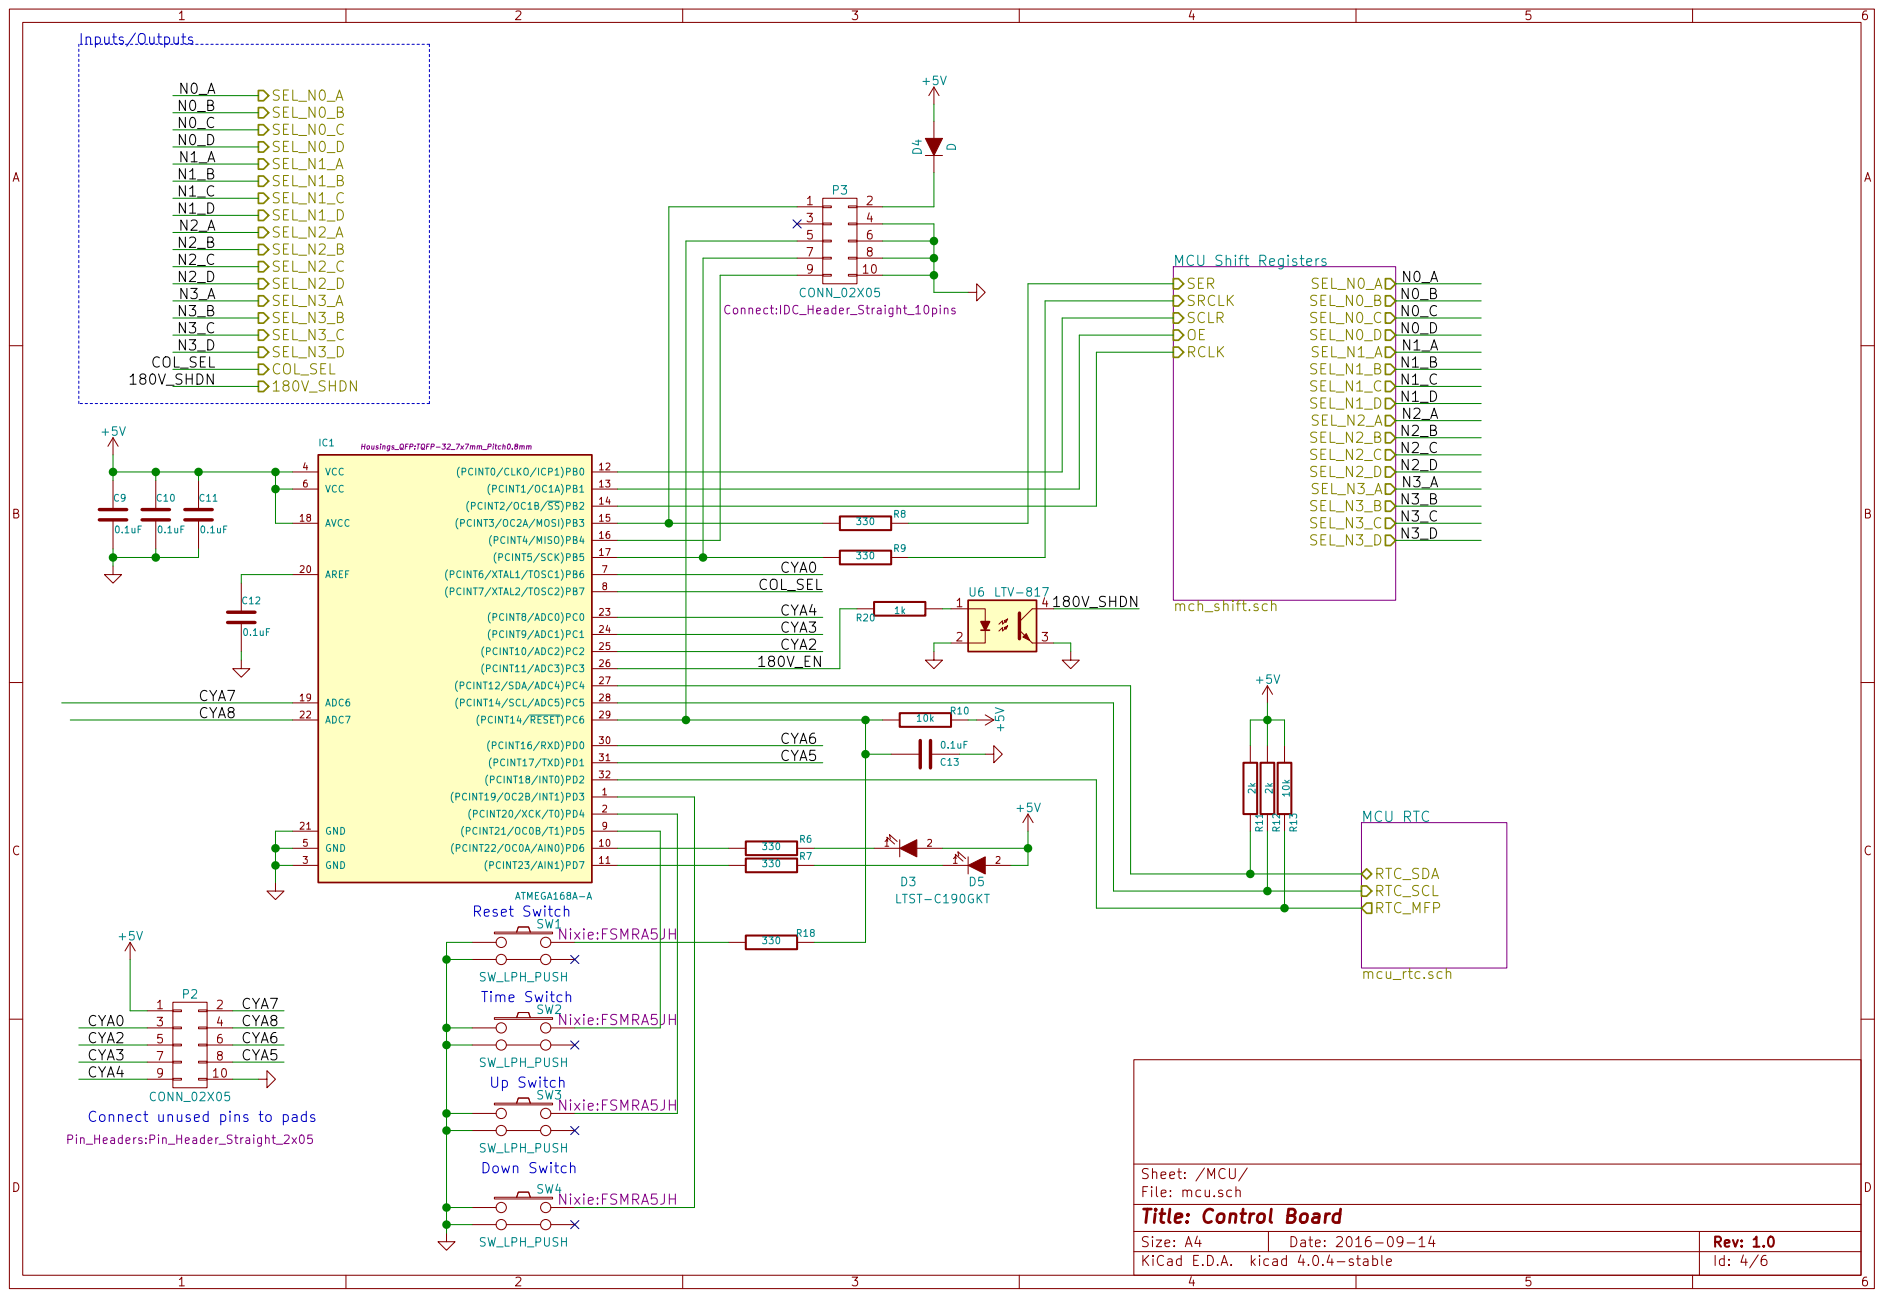
[picture p30: page 4]

Connect unused pins to pads

File: mcu.sch Sheet: /MCU/
Id: 4/6 Title: Control Board

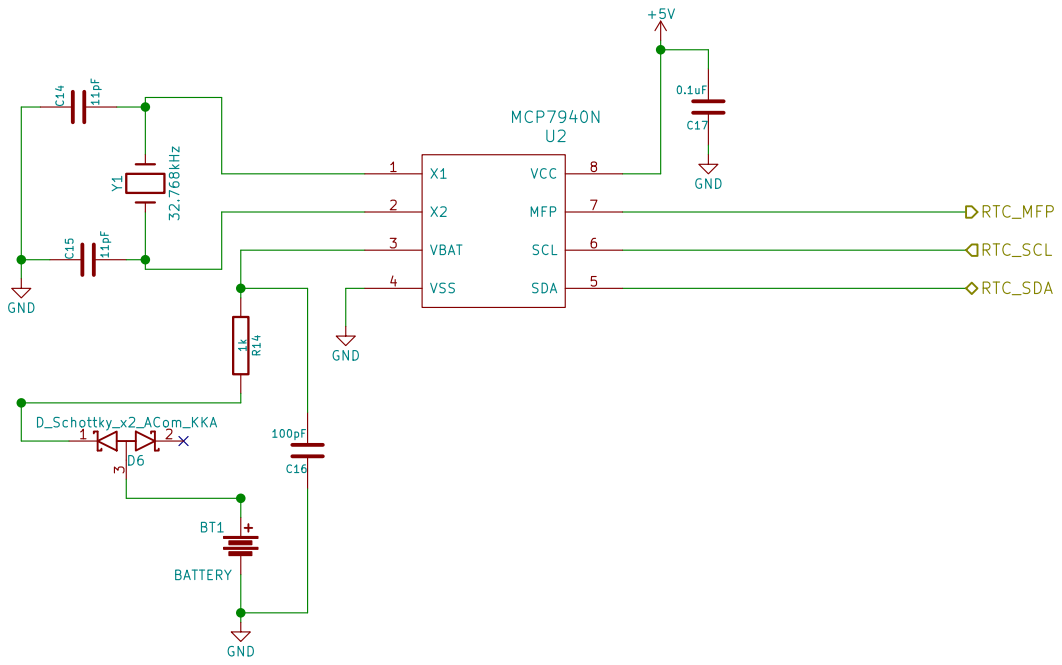
[picture p31: page 5]

Id: 5/6 Title: Control Board

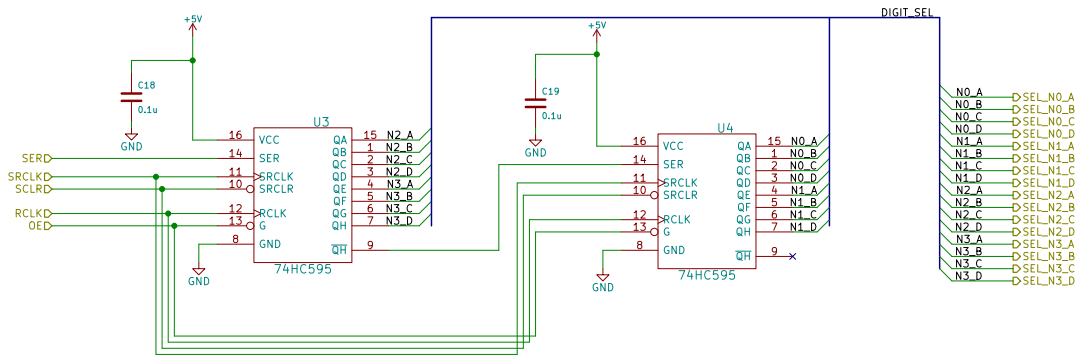
[picture p32: page 6]

Sheet: /MCU/MCU Shift Registers/
File: mch_shift.sch
Id: 6/6 Title: Control Board
