wildwoodashes/nixie_clock/hw/kicad_v1_1/projects/tube_shield/gerbers/tube_shield.pdf

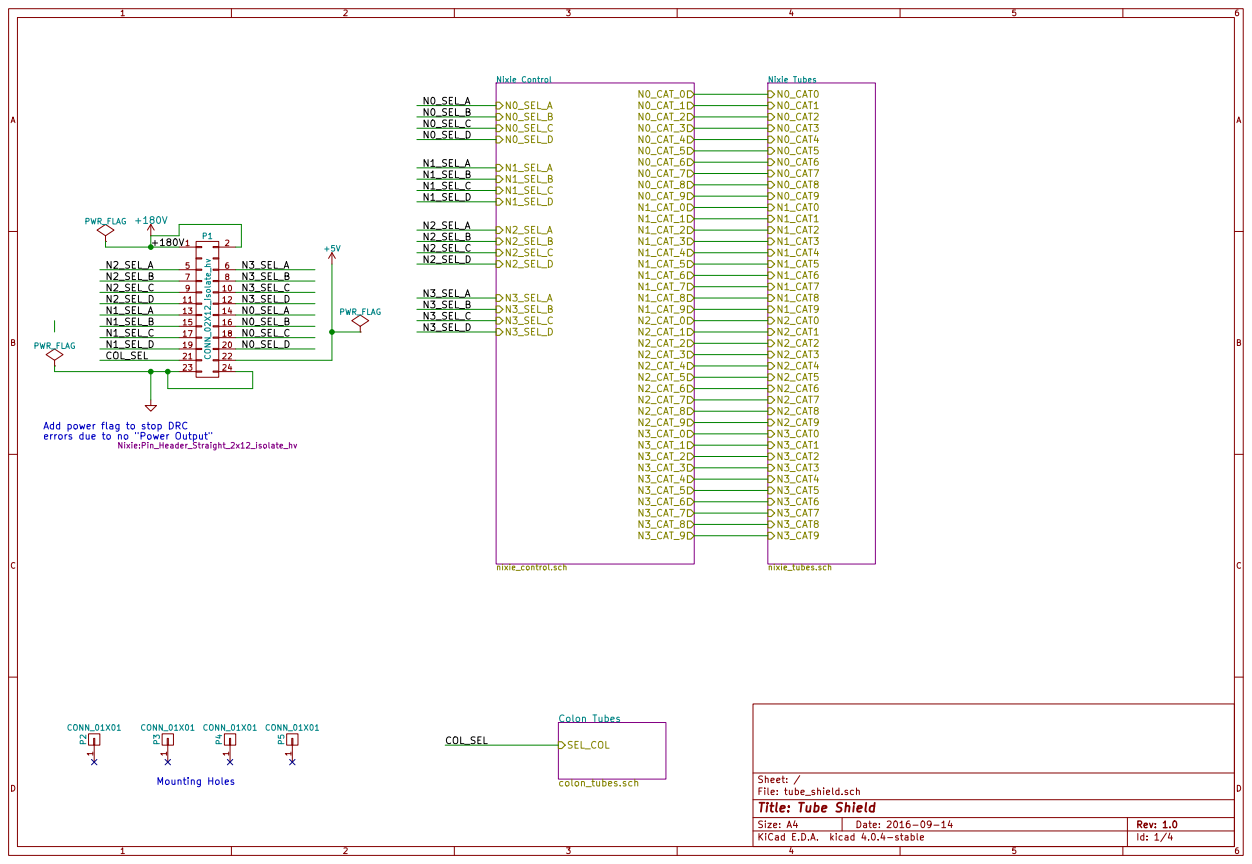
[picture p33: page 1]

PWR_FLAG Add power flag to stop DRC

File: tube_shield.sch Sheet: /
Id: 1/4 Title: Tube Shield

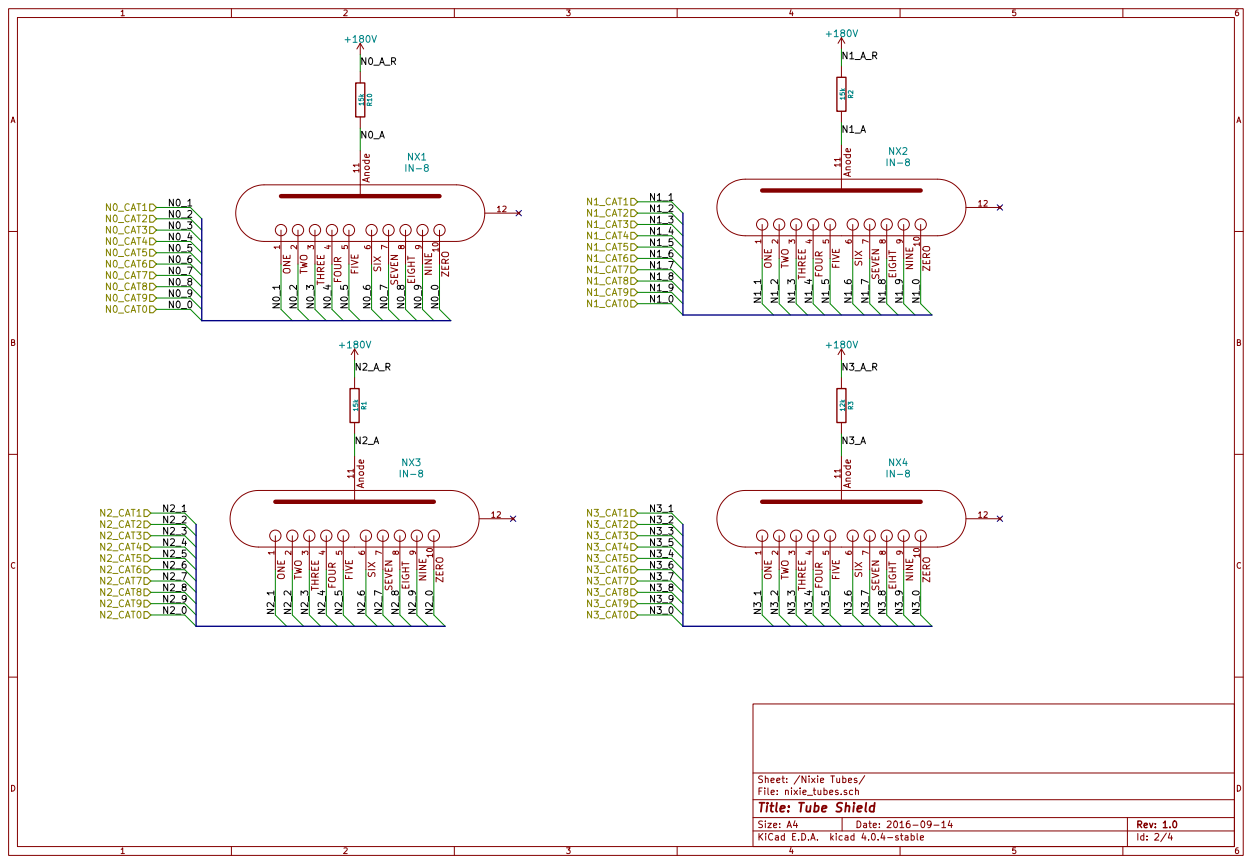
[picture p34: page 2]

File: nixie_tubes.sch Sheet: /Nixie Tubes/
Id: 2/4 Title: Tube Shield

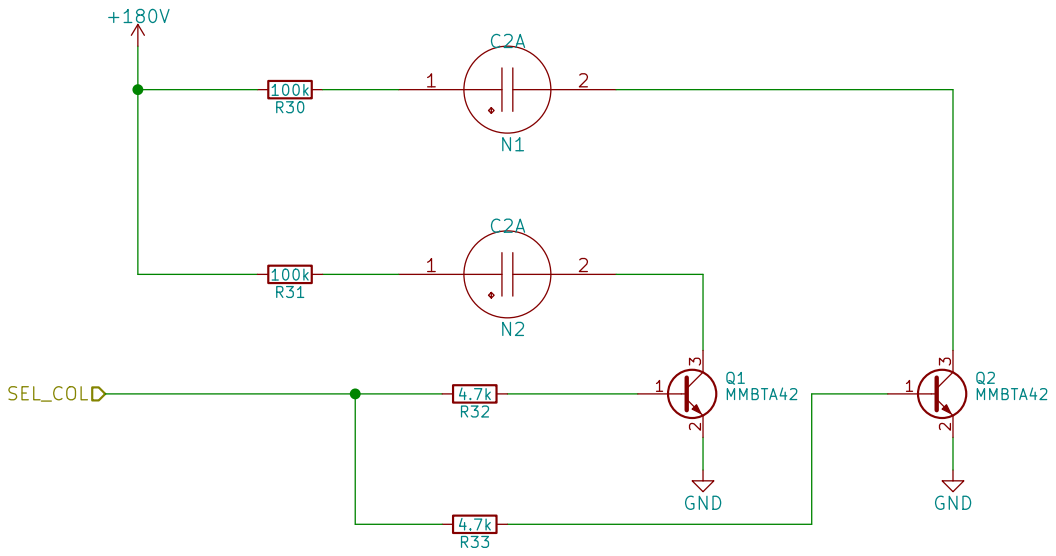
[picture p35: page 3]

File: colon_tubes.sch Sheet: /Colon Tubes/ .

Id: 3/4 Title: Tube Shield

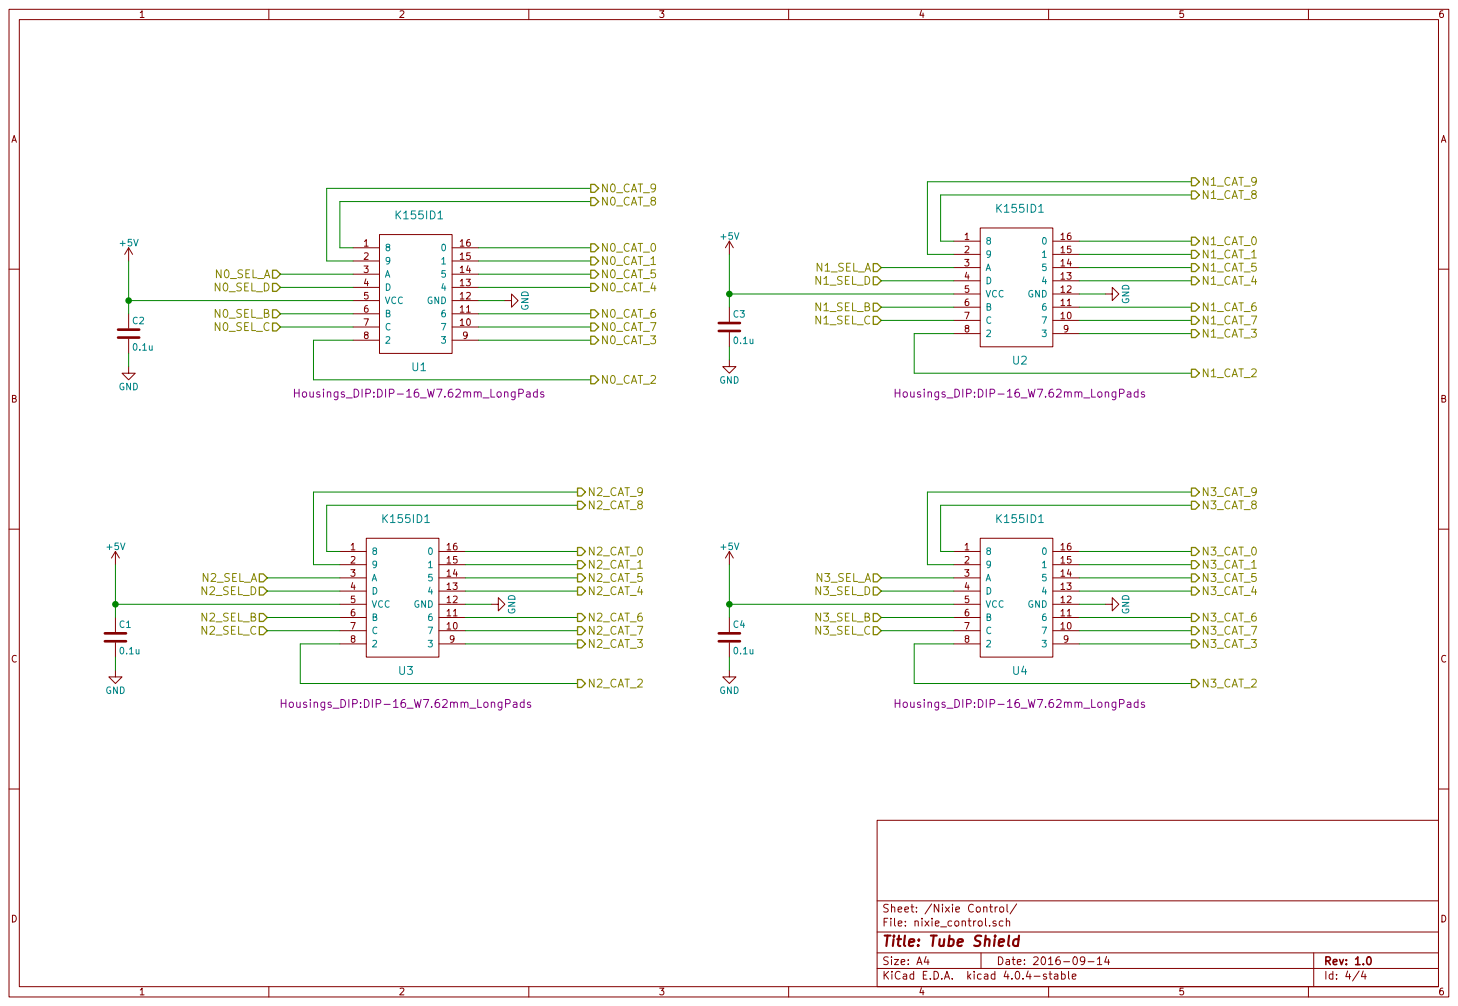
[picture p36: page 4]

File: nixie_control.sch Sheet: /Nixie Control/
Id: 4/4 Title: Tube Shield
