wildwoodashes/nixie_clock/doc/nixie_clock_pads.pdf

D

6 | 5 | 4 | 3 | 2 | 1

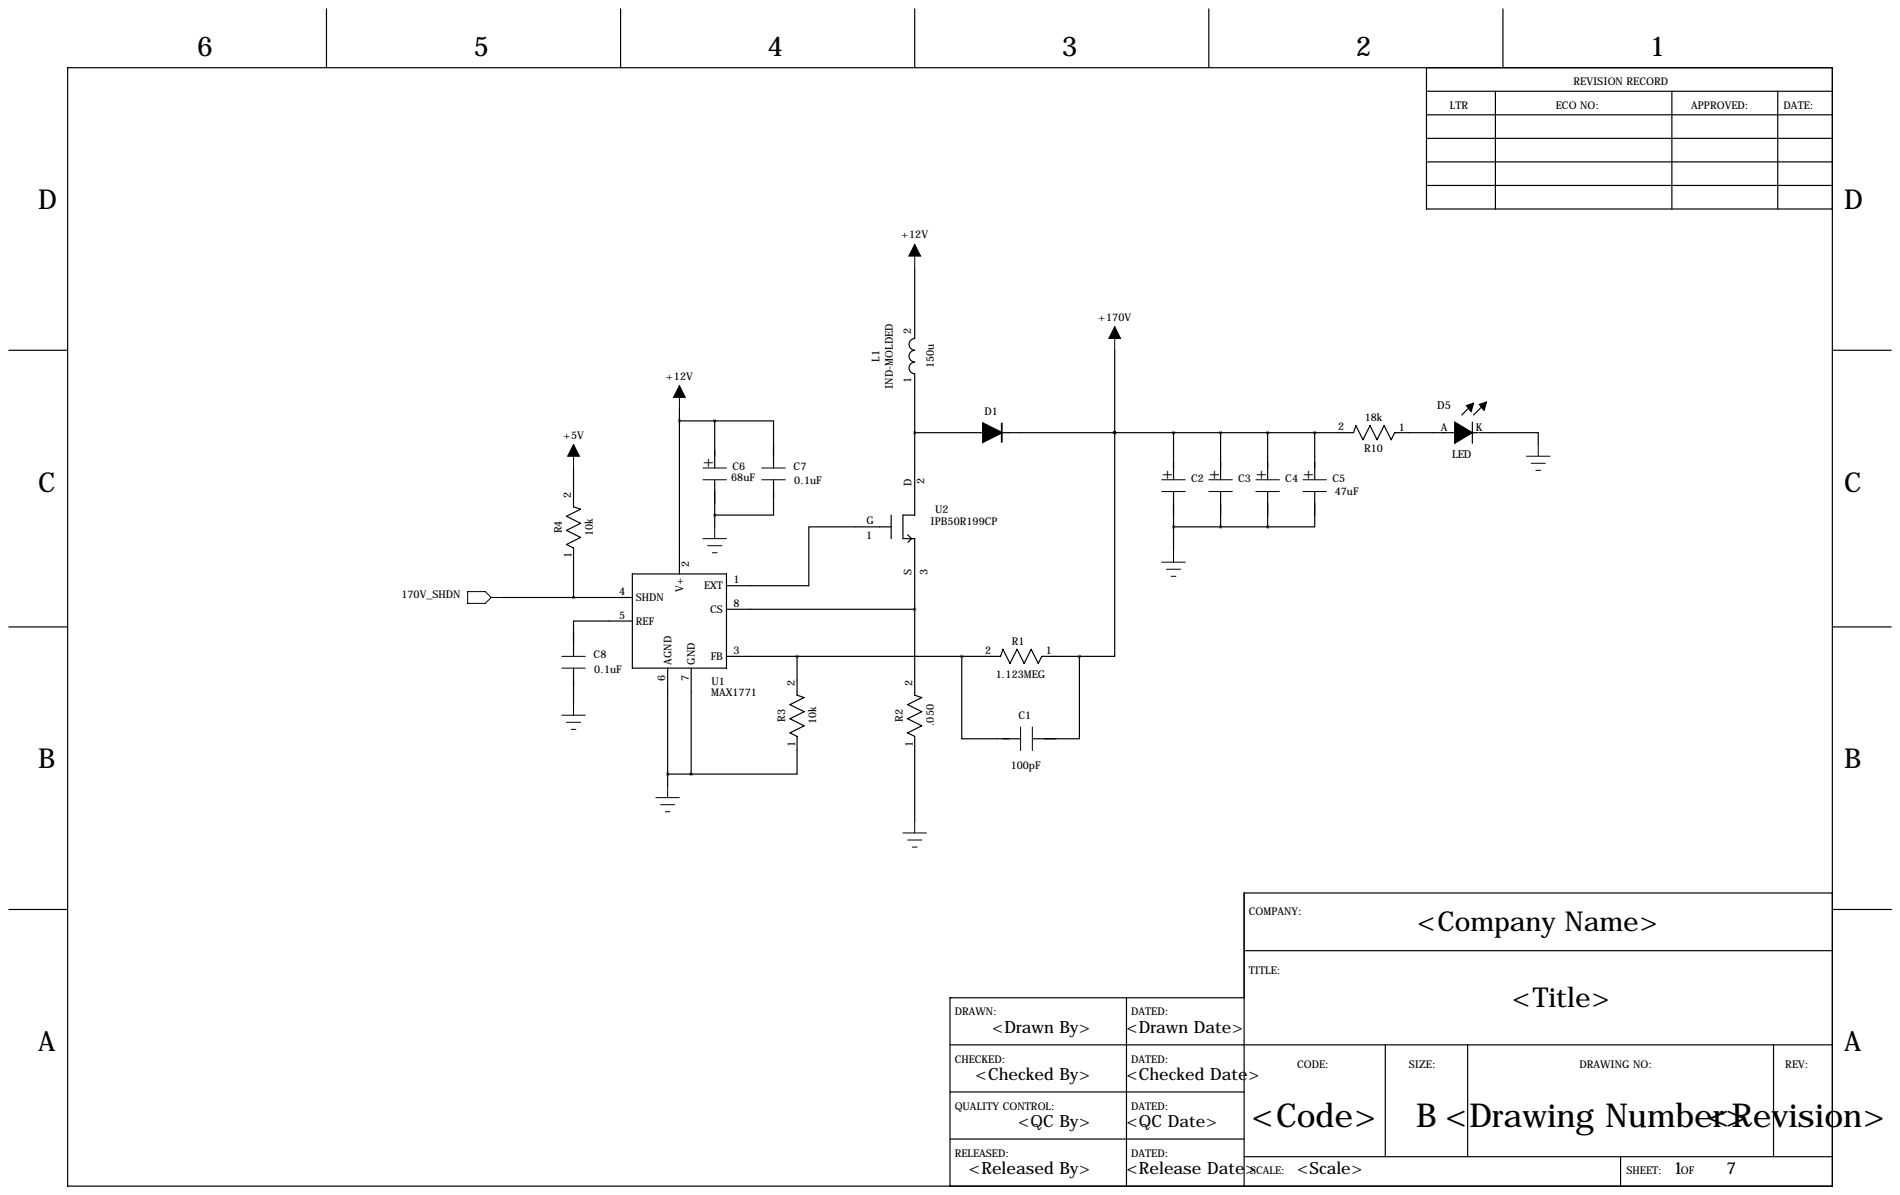
[picture p37: page 1]

REVISION RECORD

LTR | ECO NO: | APPROVED: | DATE:

DRAWN: <Drawn By> | DATED: <Drawn Date>

CHECKED: <Checked By> | DATED: <Checked Date> | CODE: | SIZE: | DRAWING NO: | REV:

QUALITY CONTROL: <QC By> | DATED: <QC Date>

RELEASED: <Released By> | DATED:

<Scale> SCALE: | 1 7 SHEET: OF

DRAWN: <Drawn By> | DATED: <Drawn Date>
CHECKED: <Checked By> | DATED: <Checked Date> | CODE: | SIZE: | DRAWING NO: | REV:
QUALITY CONTROL: <QC By> | DATED: <QC Date>

# <Company Name>

# <Title>

<Code> | B <Drawing Number><Revision>
<Scale> | 2 | 7

COMPANY:

TITLE:

| REVISION RECORD
LTR | ECO NO: | APPROVED: | DATE:

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
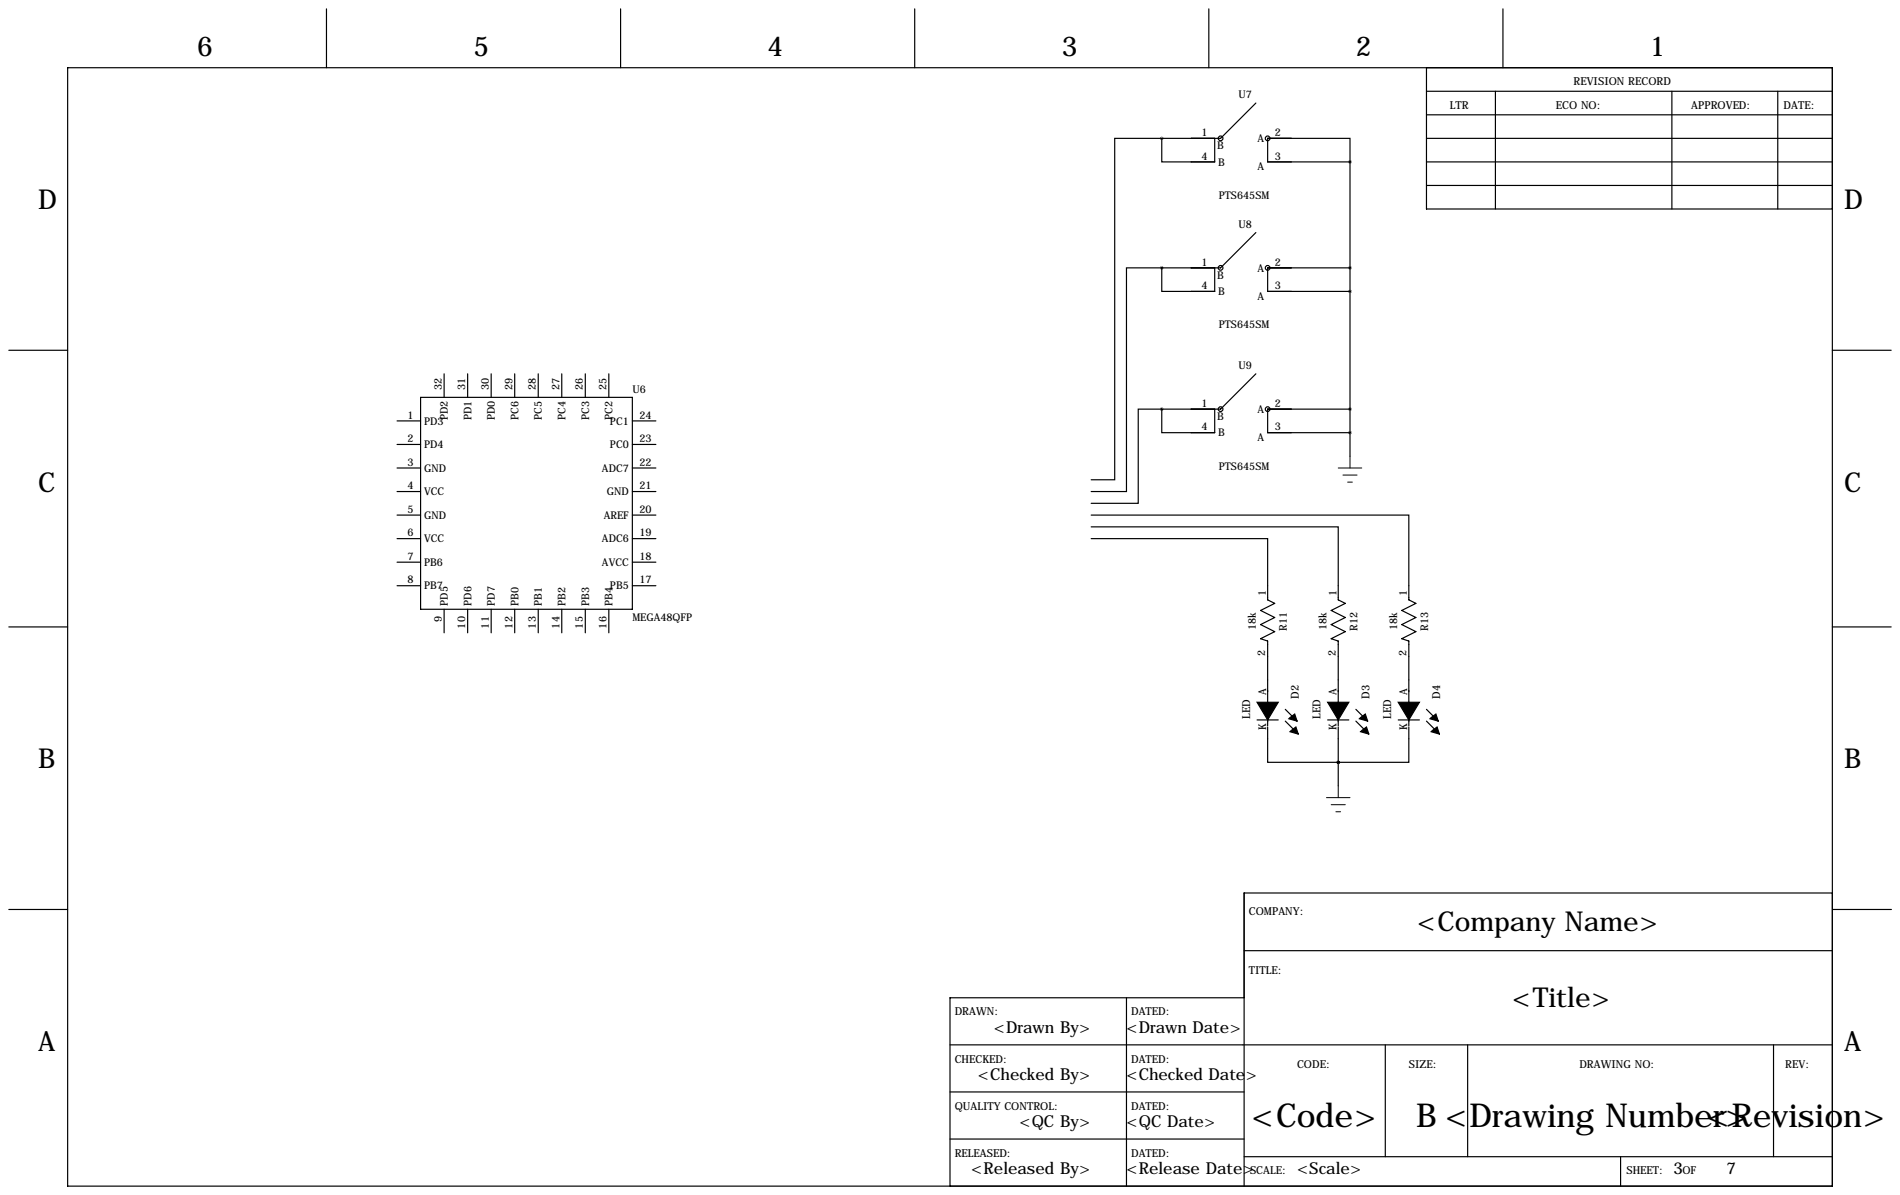
[picture p38: page 3]

1 2 | REVISION RECORD

LTR | ECO NO: | APPROVED: | DATE:

DRAWN: <Drawn By> | DATED: <Drawn Date>

CHECKED: <Checked By> | DATED: <Checked Date> | CODE: | SIZE: | DRAWING NO: | REV:

QUALITY CONTROL: <QC By> | DATED: <QC Date>

D

D

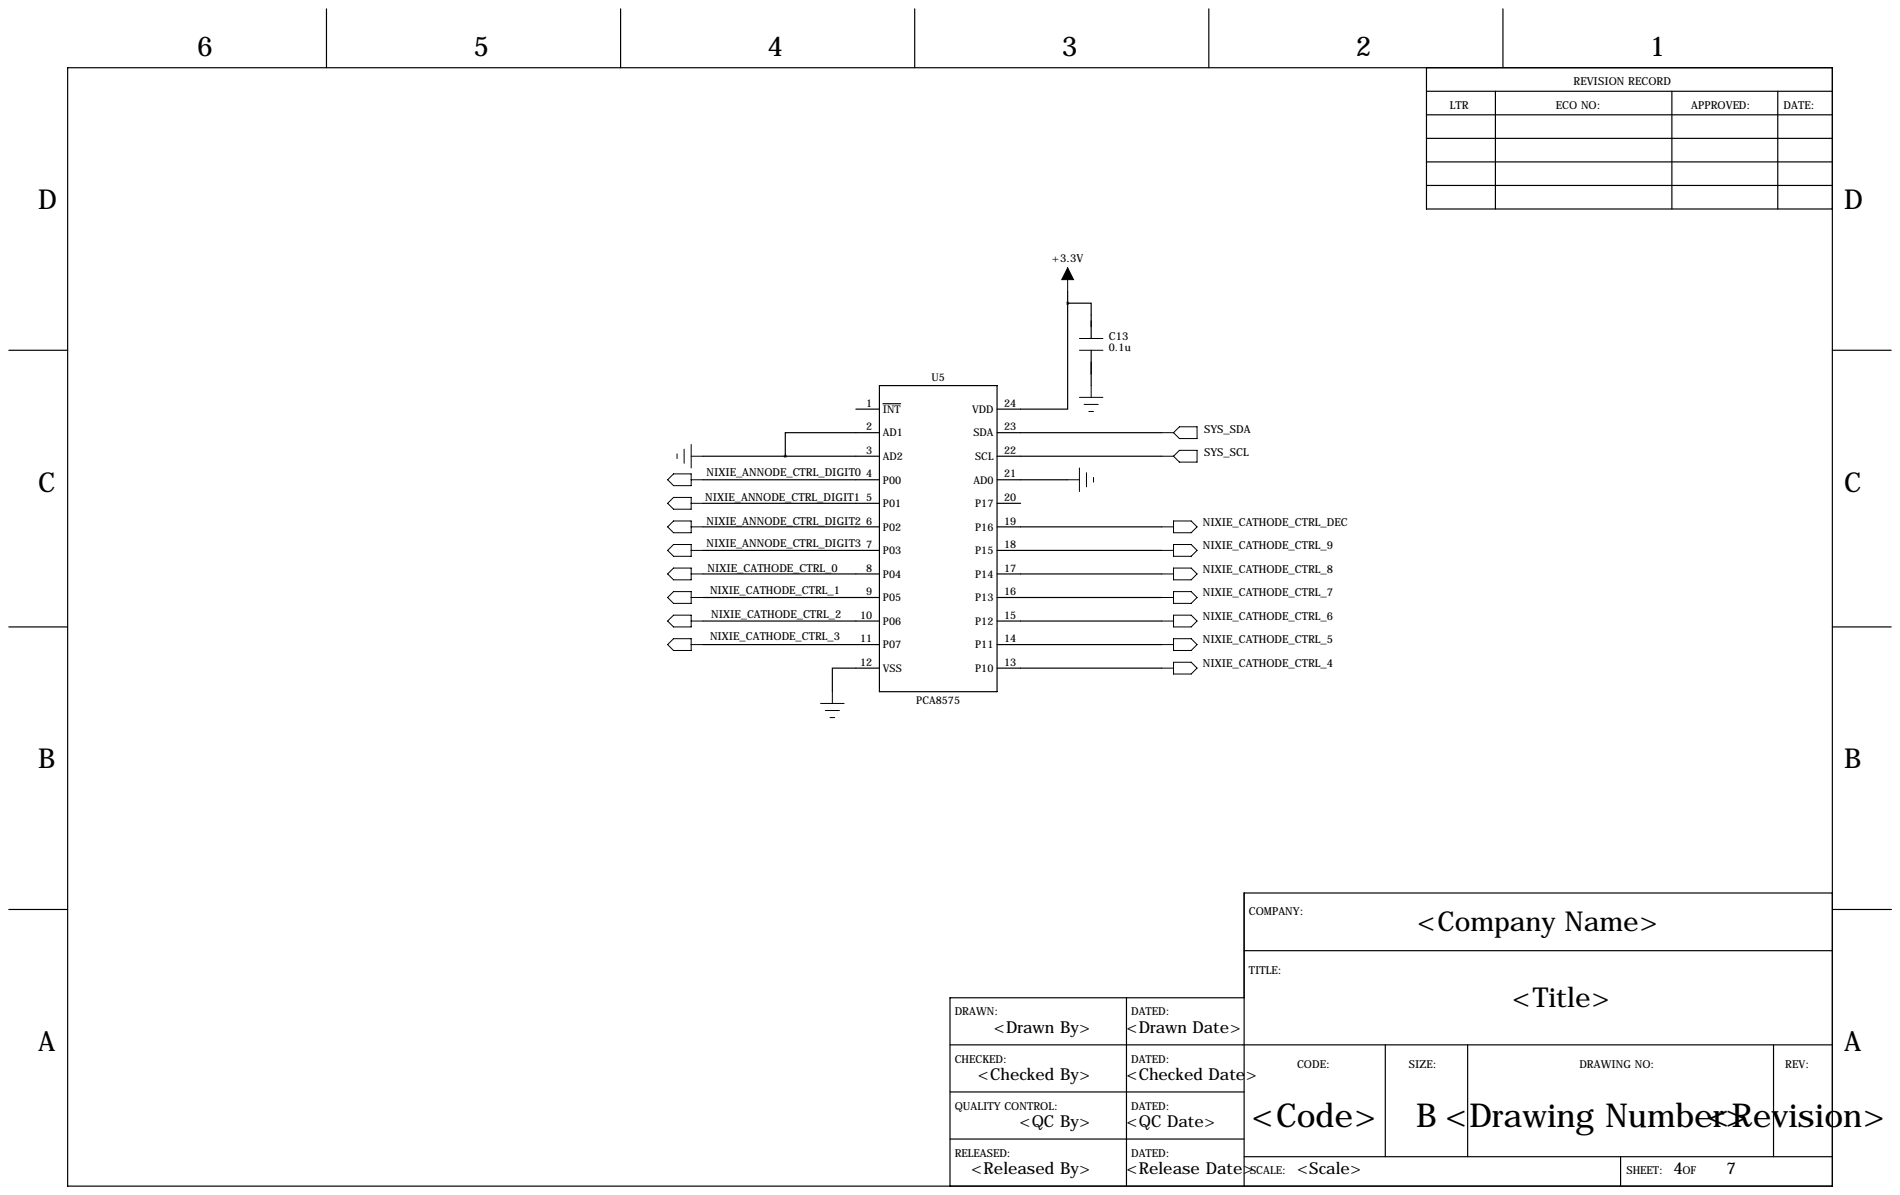
[picture p39: page 4]

+3.3V | REVISION RECORD

LTR | ECO NO: | APPROVED: | DATE:

DRAWN: <Drawn By> | DATED: <Drawn Date>

CHECKED: <Checked By> | DATED: <Checked Date> | CODE: | SIZE: | DRAWING NO: | REV:

QUALITY CONTROL: <QC By> | DATED: <QC Date>

D

D

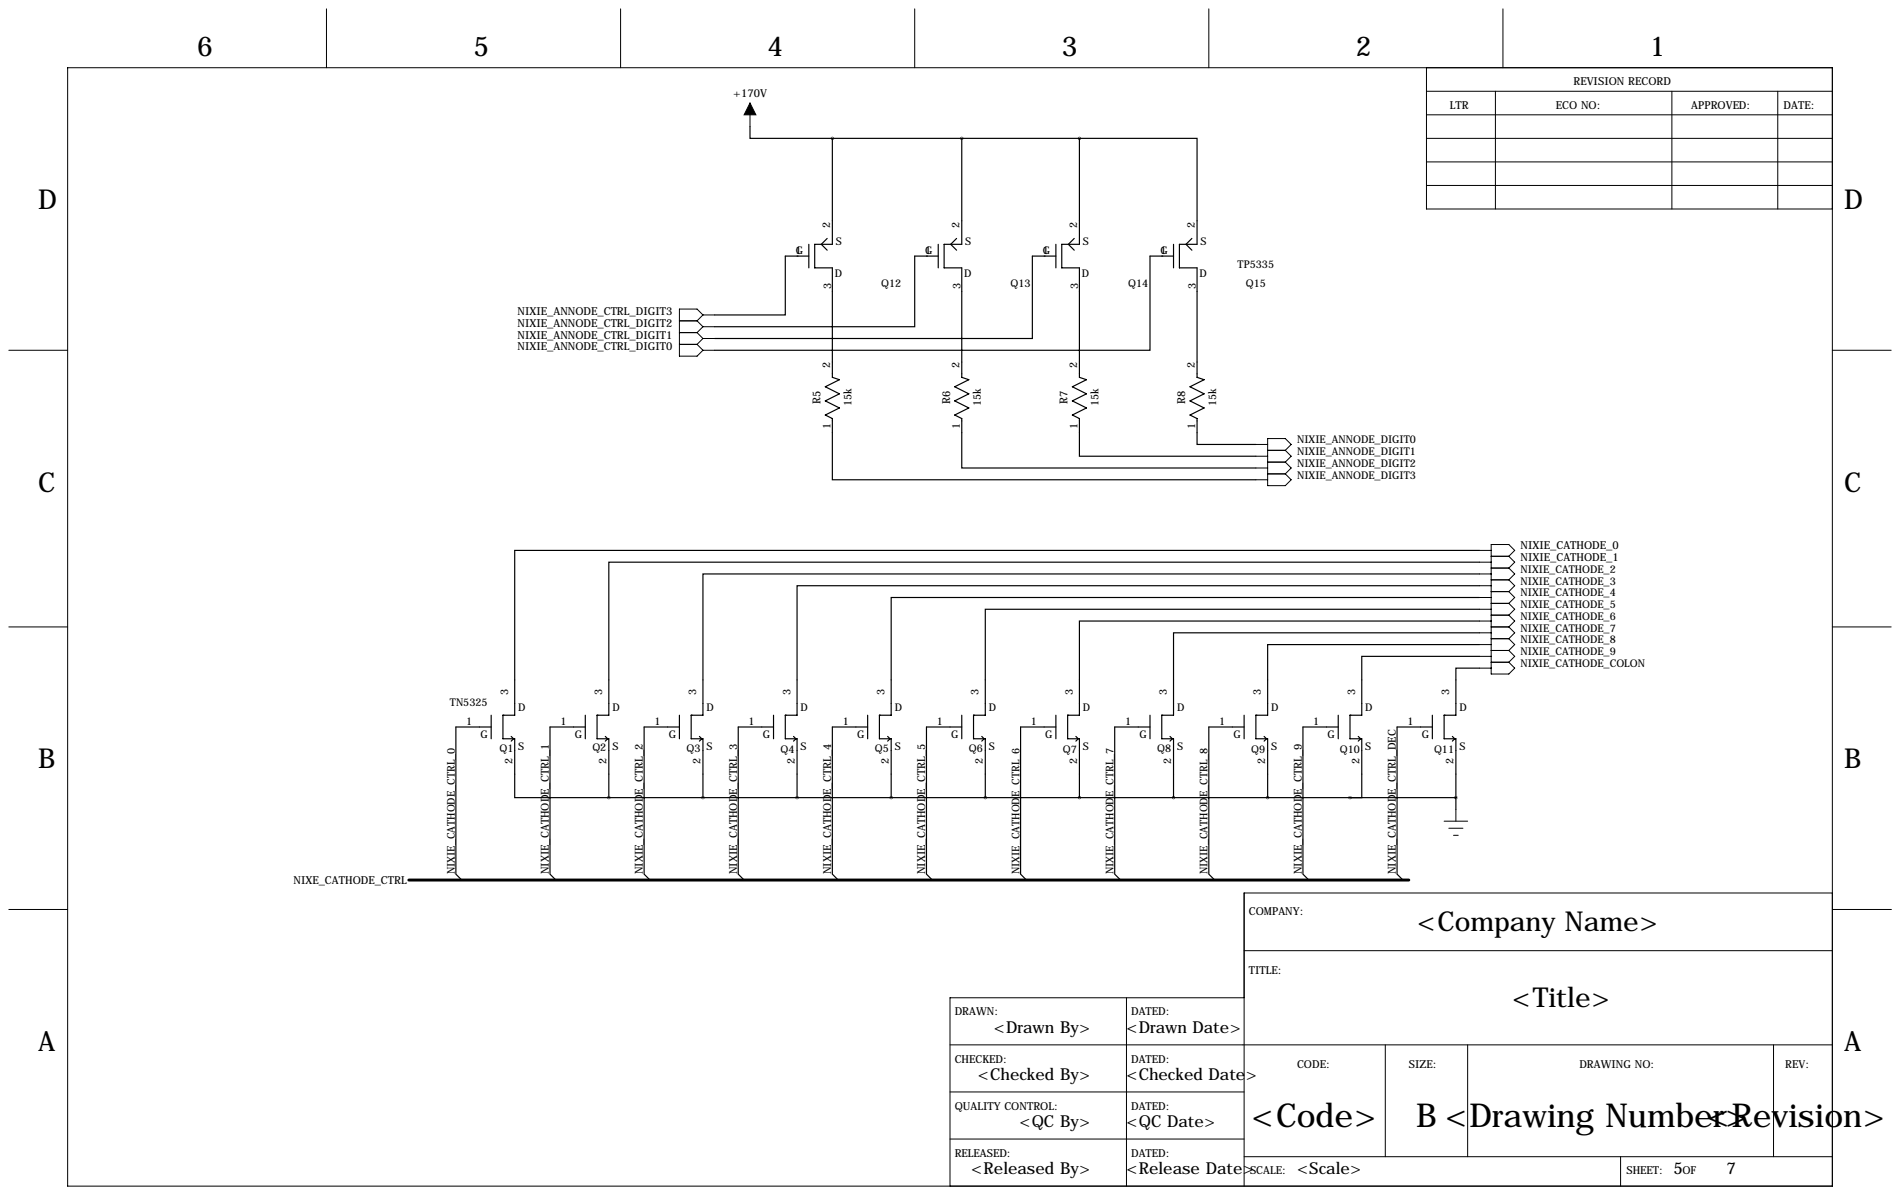
[picture p40: page 5]

REVISION RECORD

LTR | ECO NO: | APPROVED: | DATE:

DRAWN: <Drawn By> | DATED: <Drawn Date>

CHECKED: <Checked By> | DATED: <Checked Date> | CODE: | SIZE: | DRAWING NO: | REV:

QUALITY CONTROL: <QC By> | DATED: <QC Date>

D

D

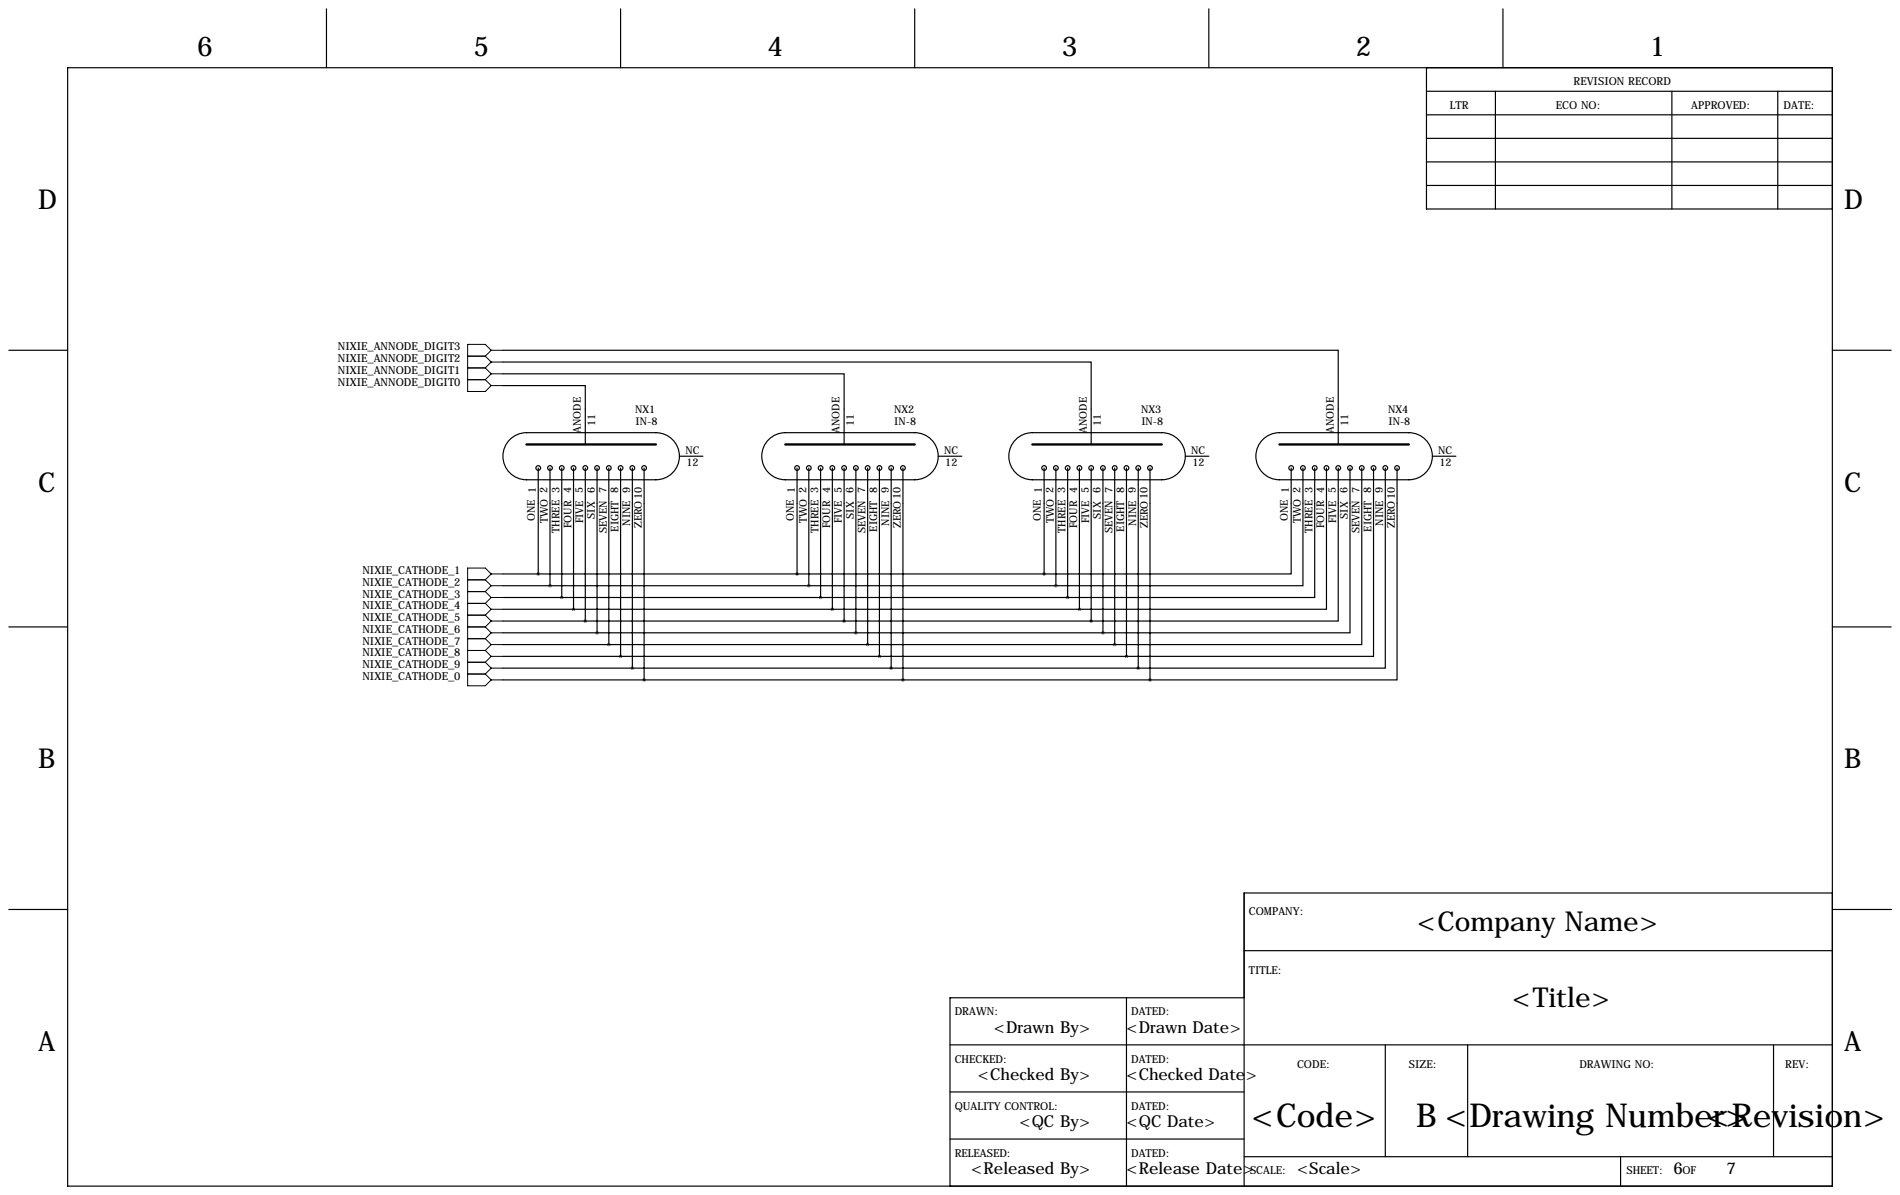
[picture p41: page 6]
<Company Name>; <Title>; <Code>; B <Drawing Number><Revision>; <Scale>; COMPANY:; TITLE:; 1 ONE; 2 TWO; 3 THREE; 4 FOUR; 5 FIVE; 6 SIX; 7 SEVEN; 8 EIGHT; 9 NINE; 10 ZERO; ANODE; NIXIE_CATHODE_1 NIXIE_CATHODE_2 NIXIE_CATHODE_3 NIXIE_CATHODE_4 NIXIE_CATHODE_5 NIXIE_CATHODE_6 NIXIE_CATHODE_7; NIXIE_CATHODE_9 NIXIE_CATHODE_0; NIXIE_CATHODE_8; NIXIE_ANNODE_DIGIT0; NIXIE_ANNODE_DIGIT1; NIXIE_ANNODE_DIGIT2; NIXIE_ANNODE_DIGIT3

REVISION RECORD

LTR | ECO NO: | APPROVED: | DATE:

DRAWN: <Drawn By> | DATED: <Drawn Date>

CHECKED: <Checked By> | DATED: <Checked Date> | CODE: | SIZE: | DRAWING NO: | REV:

QUALITY CONTROL: <QC By> | DATED: <QC Date>

D

D

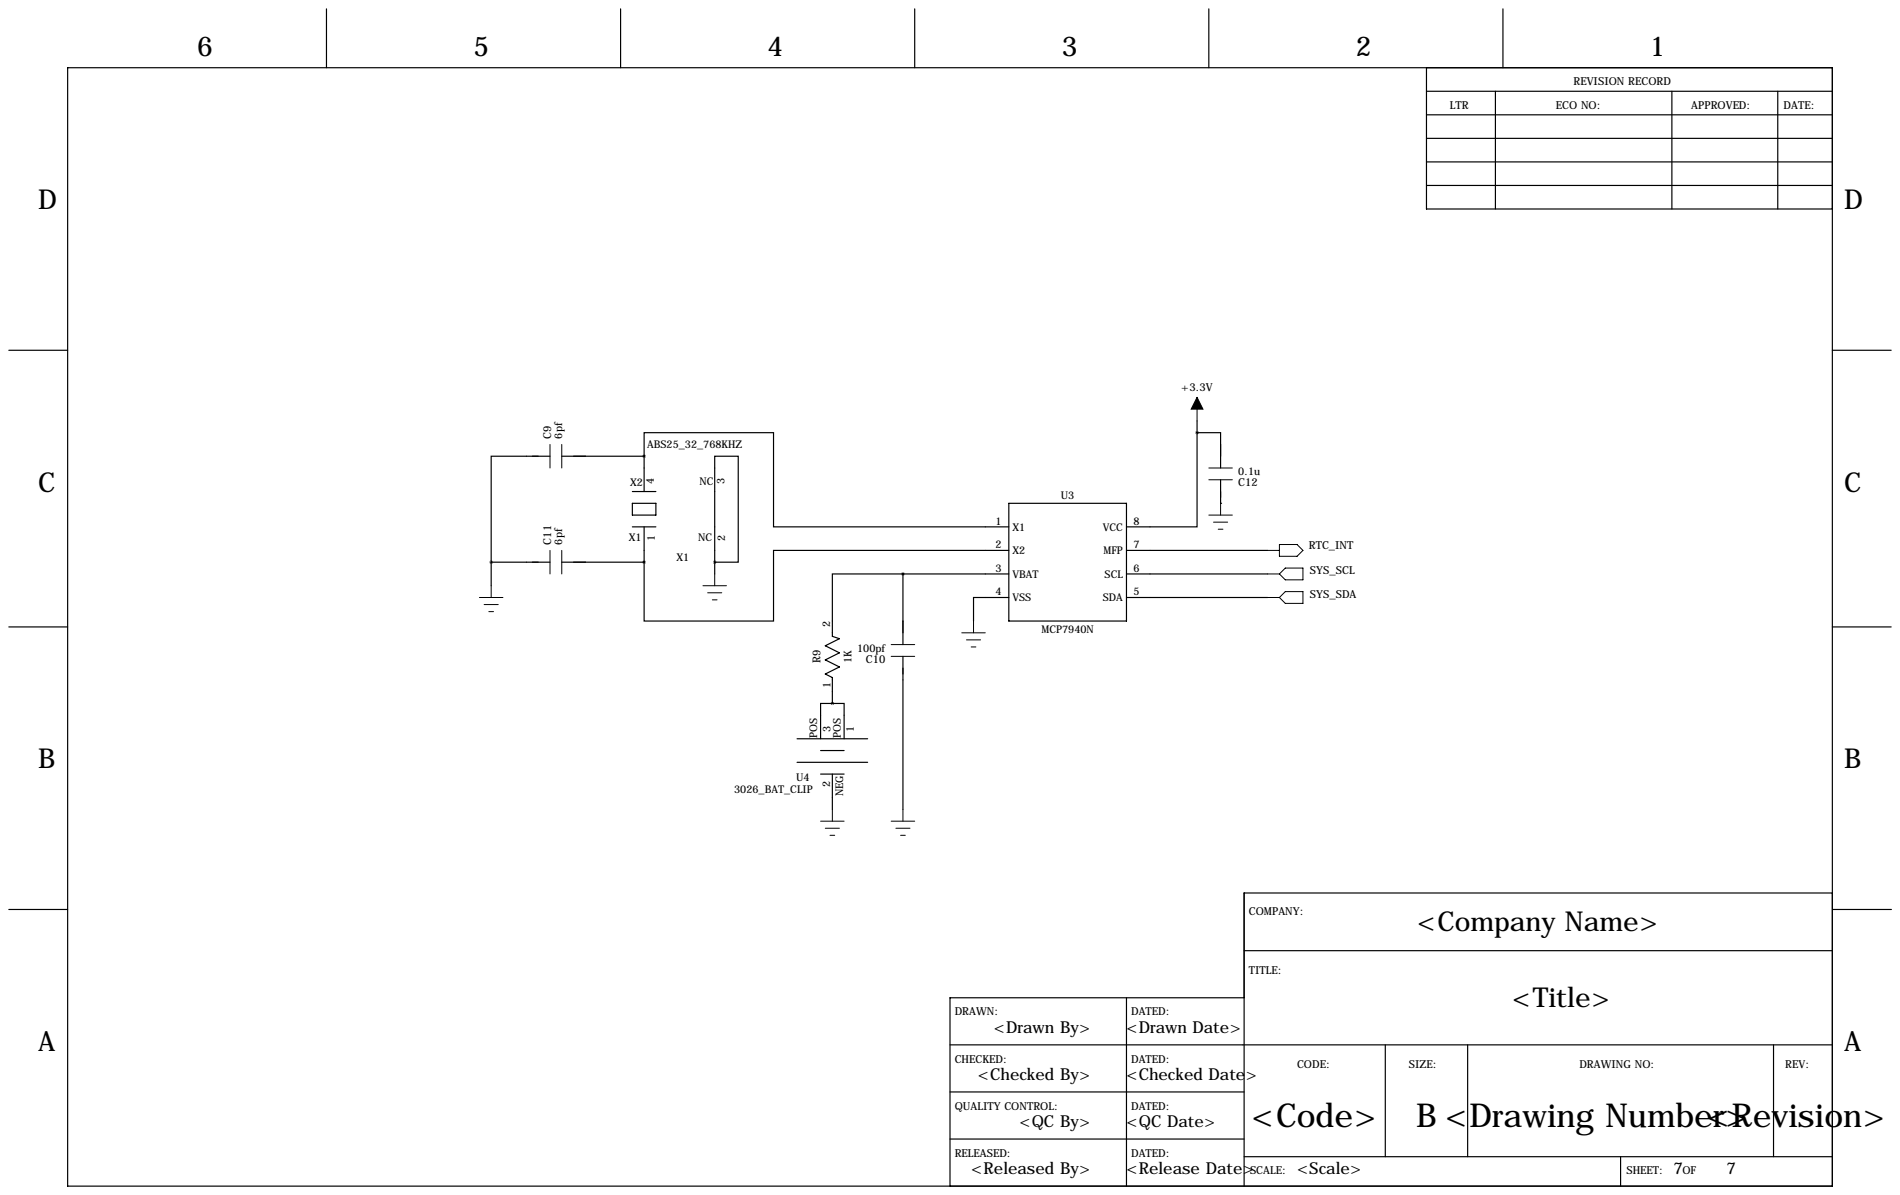
[picture p42: page 7]
<Company Name>; <Title>; <Code>; B <Drawing Number><Revision>; <Scale>; COMPANY:; TITLE:; VBAT; VSS; SDA; SCL; MFP; VCC; MCP7940N; ABS25_32_768KHZ; POS; NEG; U4 3026_BAT_CLIP; RTC_INT; SYS_SDA; SYS_SCL

+3.3V | REVISION RECORD

LTR | ECO NO: | APPROVED: | DATE:

DRAWN: <Drawn By> | DATED: <Drawn Date>

CHECKED: <Checked By> | DATED: <Checked Date> | CODE: | SIZE: | DRAWING NO: | REV:

QUALITY CONTROL: <QC By> | DATED: <QC Date>
