wildwoodashes/nixie_clock/hw/kicad_v1_1/projects/tube_shield/tube_shield.pdf

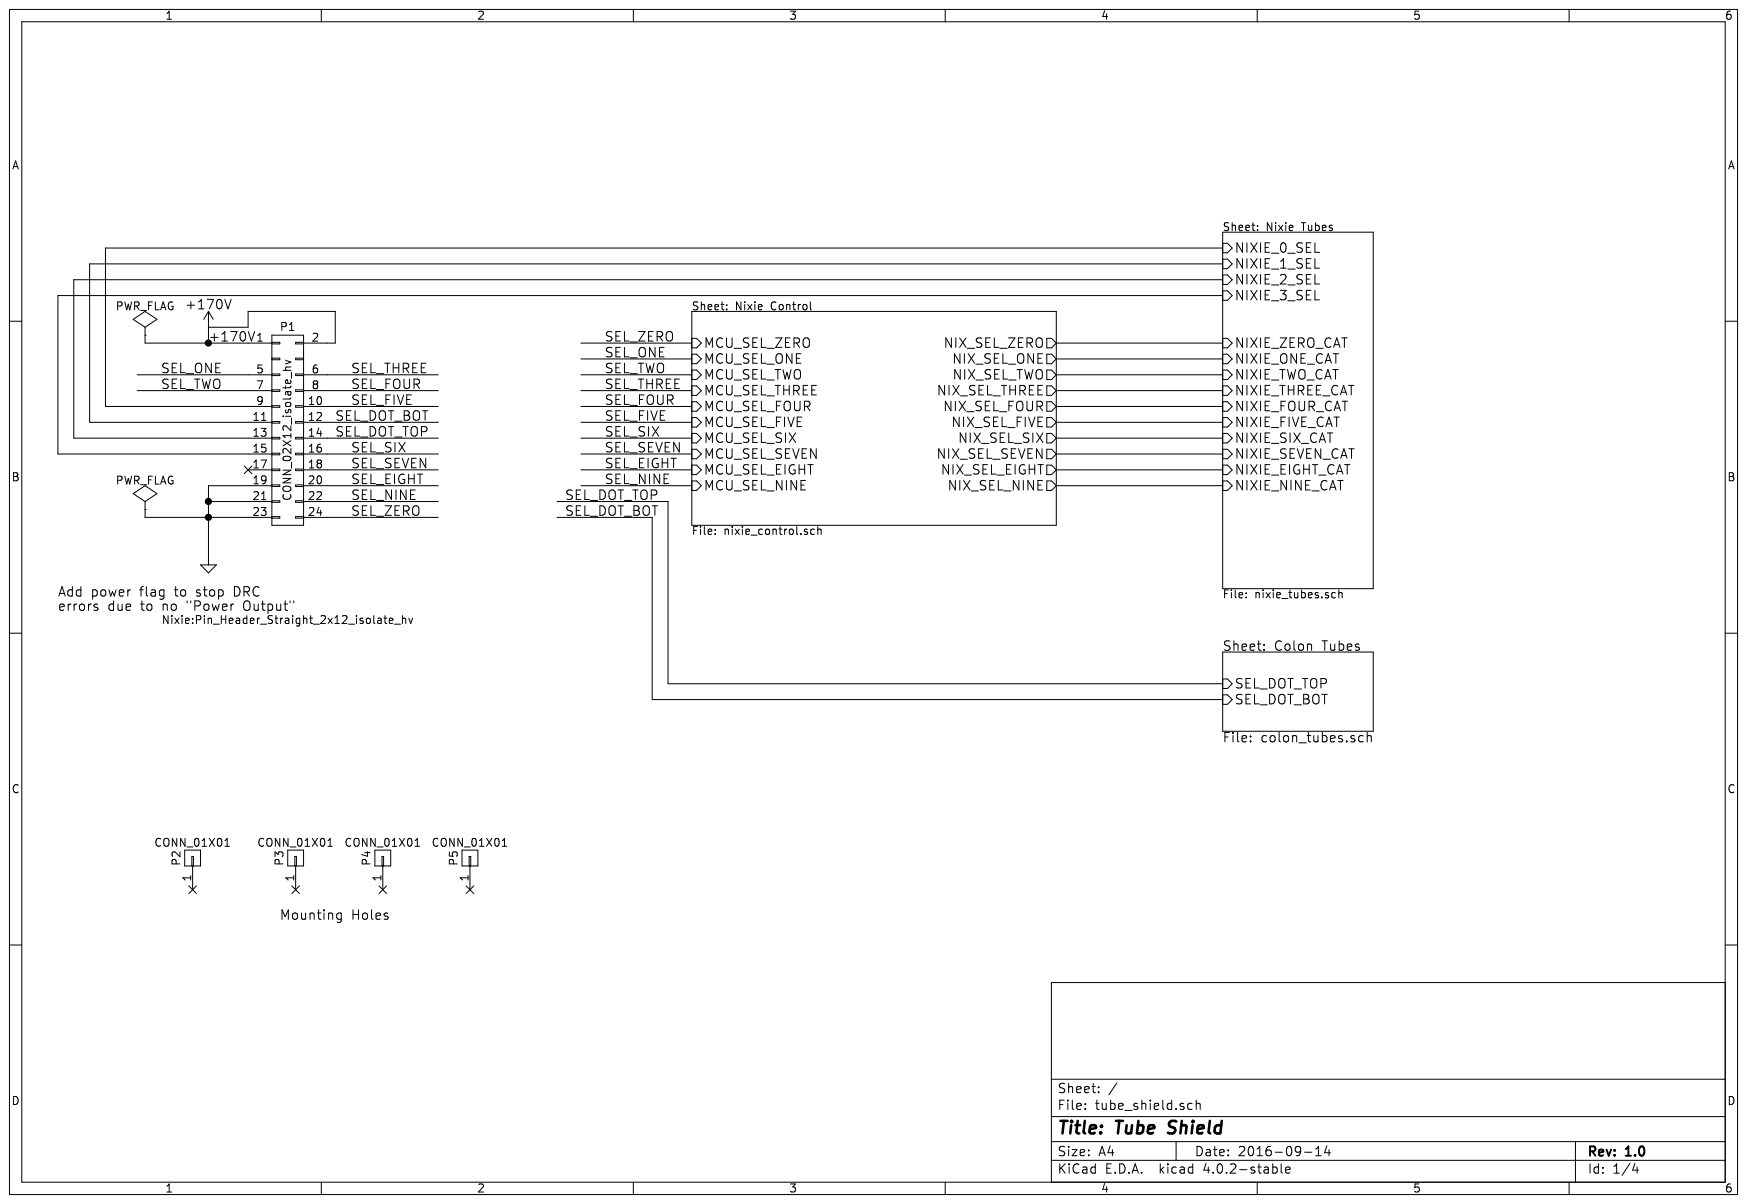
[picture p43: page 1]

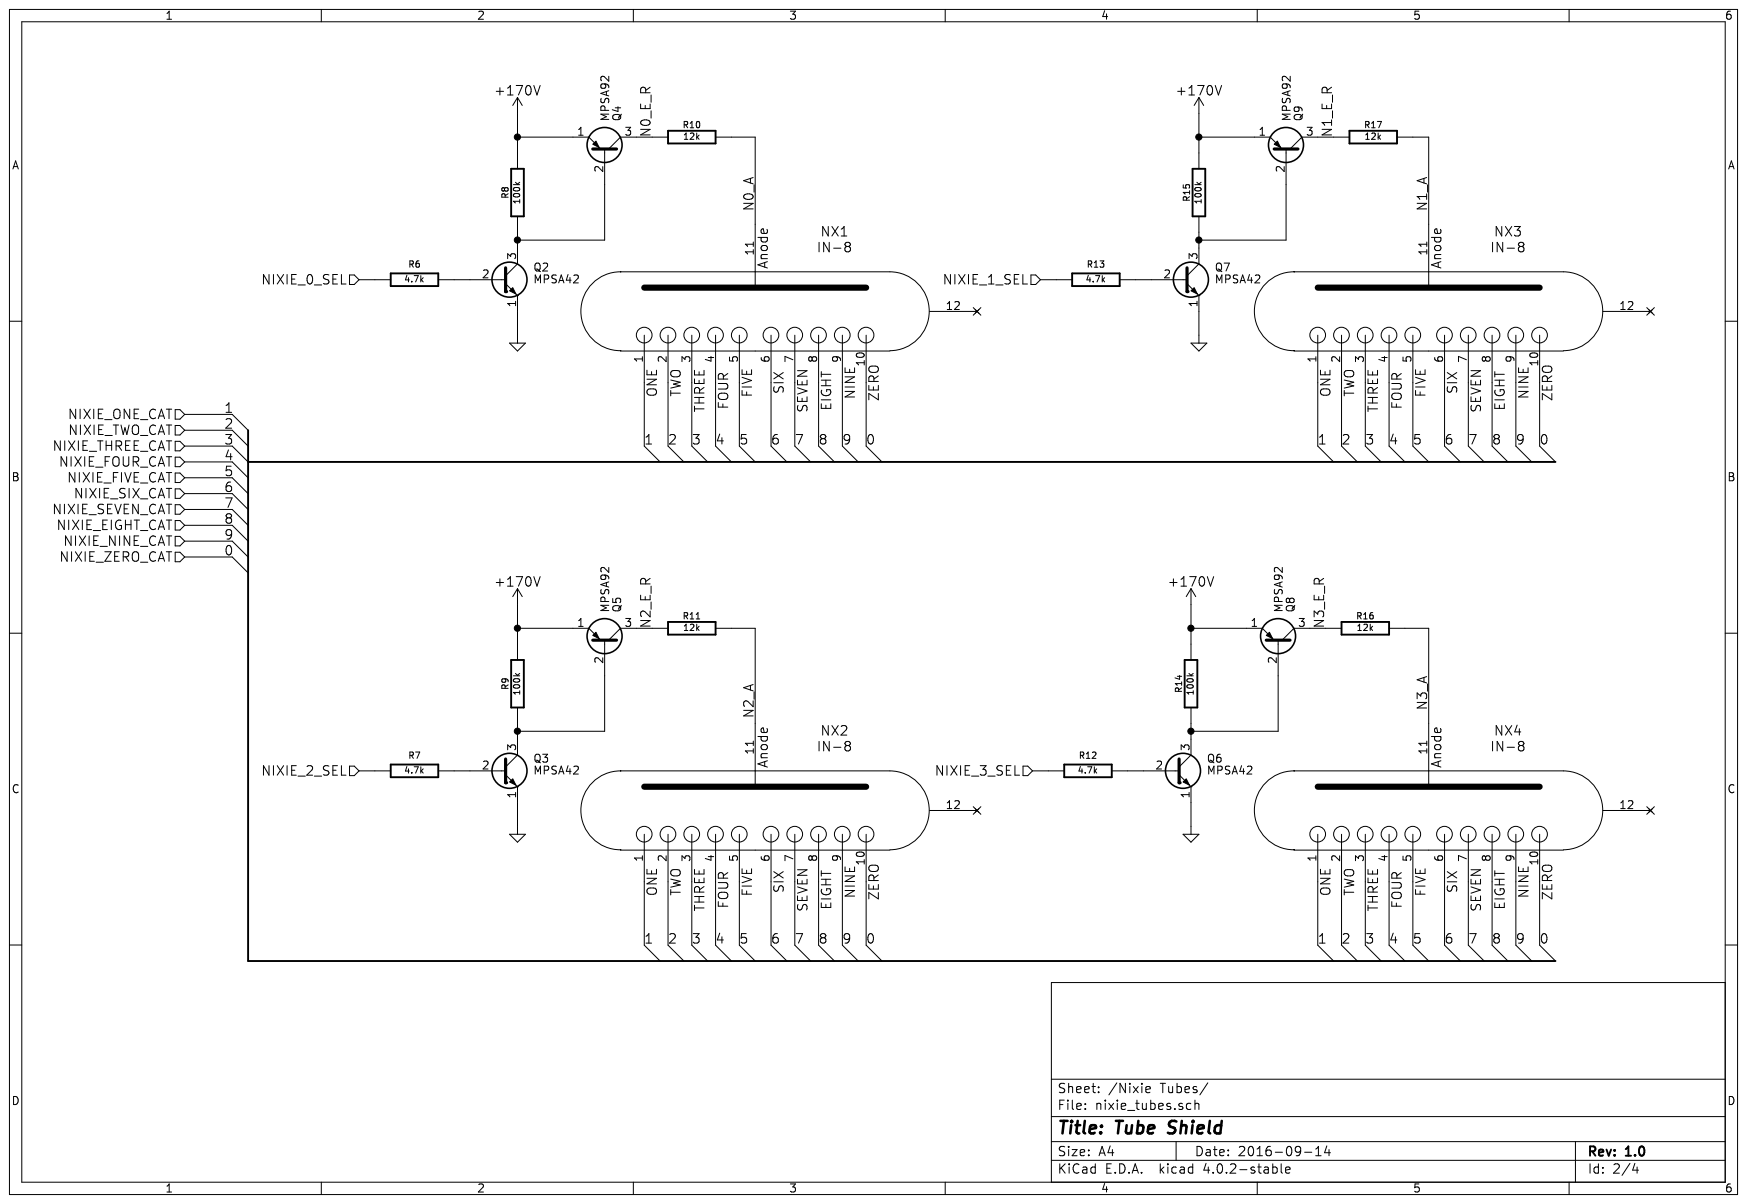
[picture p44: page 2]

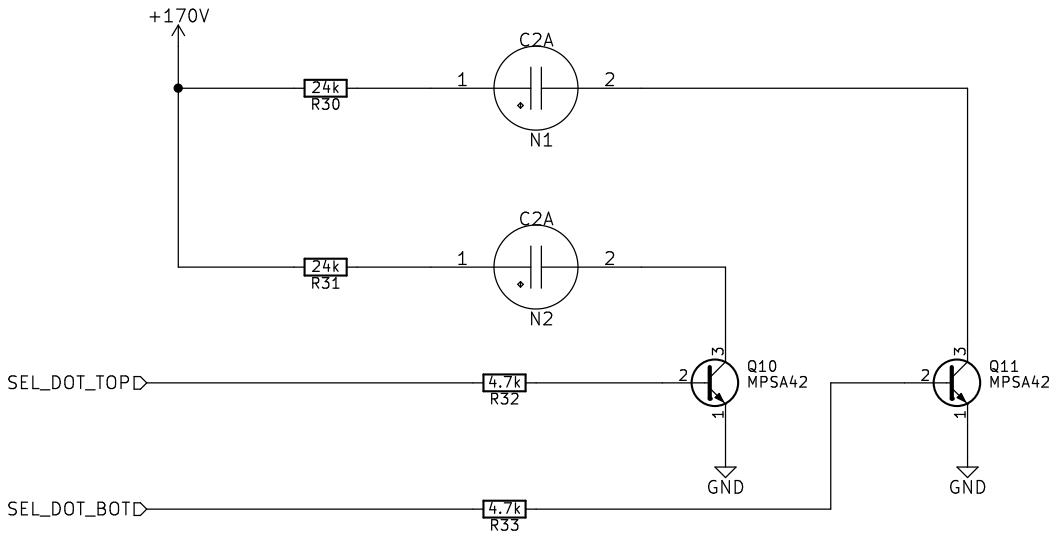
[picture p45: page 3]

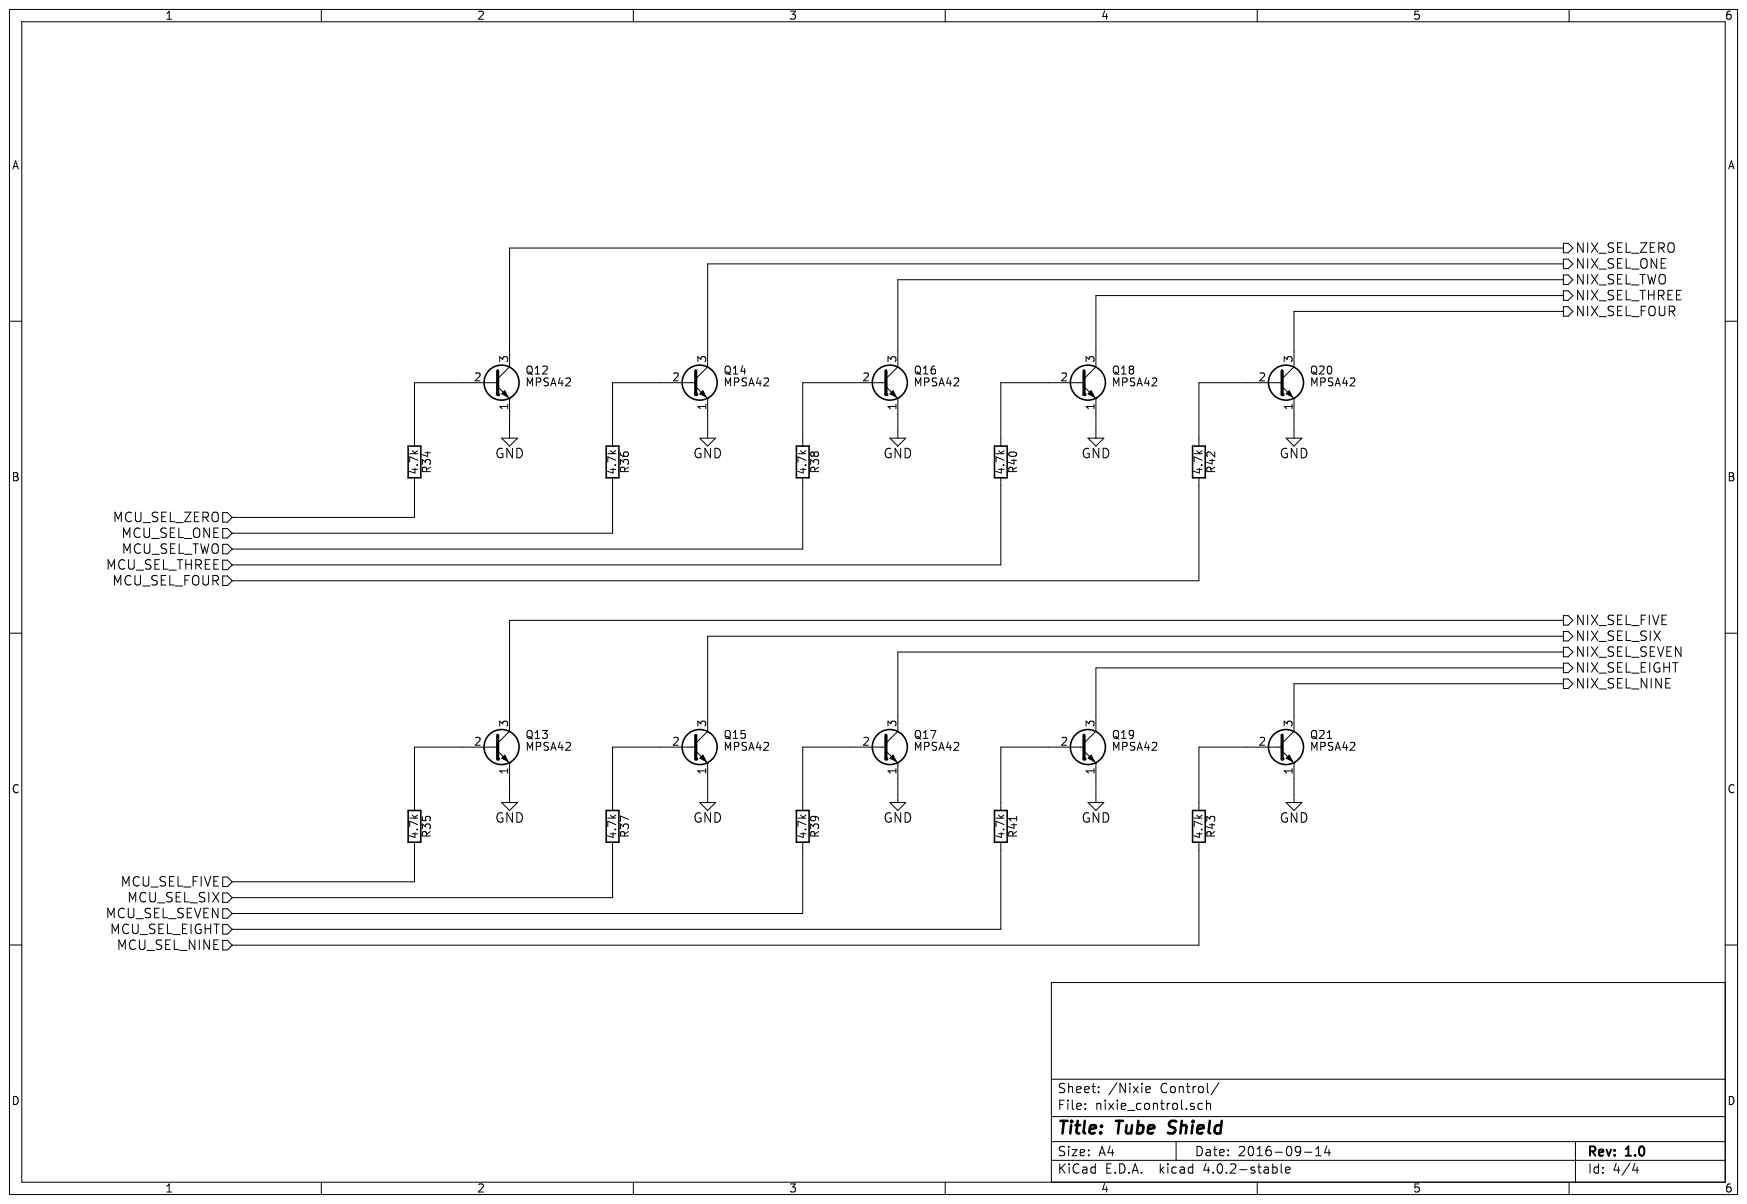
[picture p46: page 4]
