wildwoodashes/nixie_clock/hw/kicad_v1_0/projects/control_board/control_board_v1_0_gerber/control_board.pdf

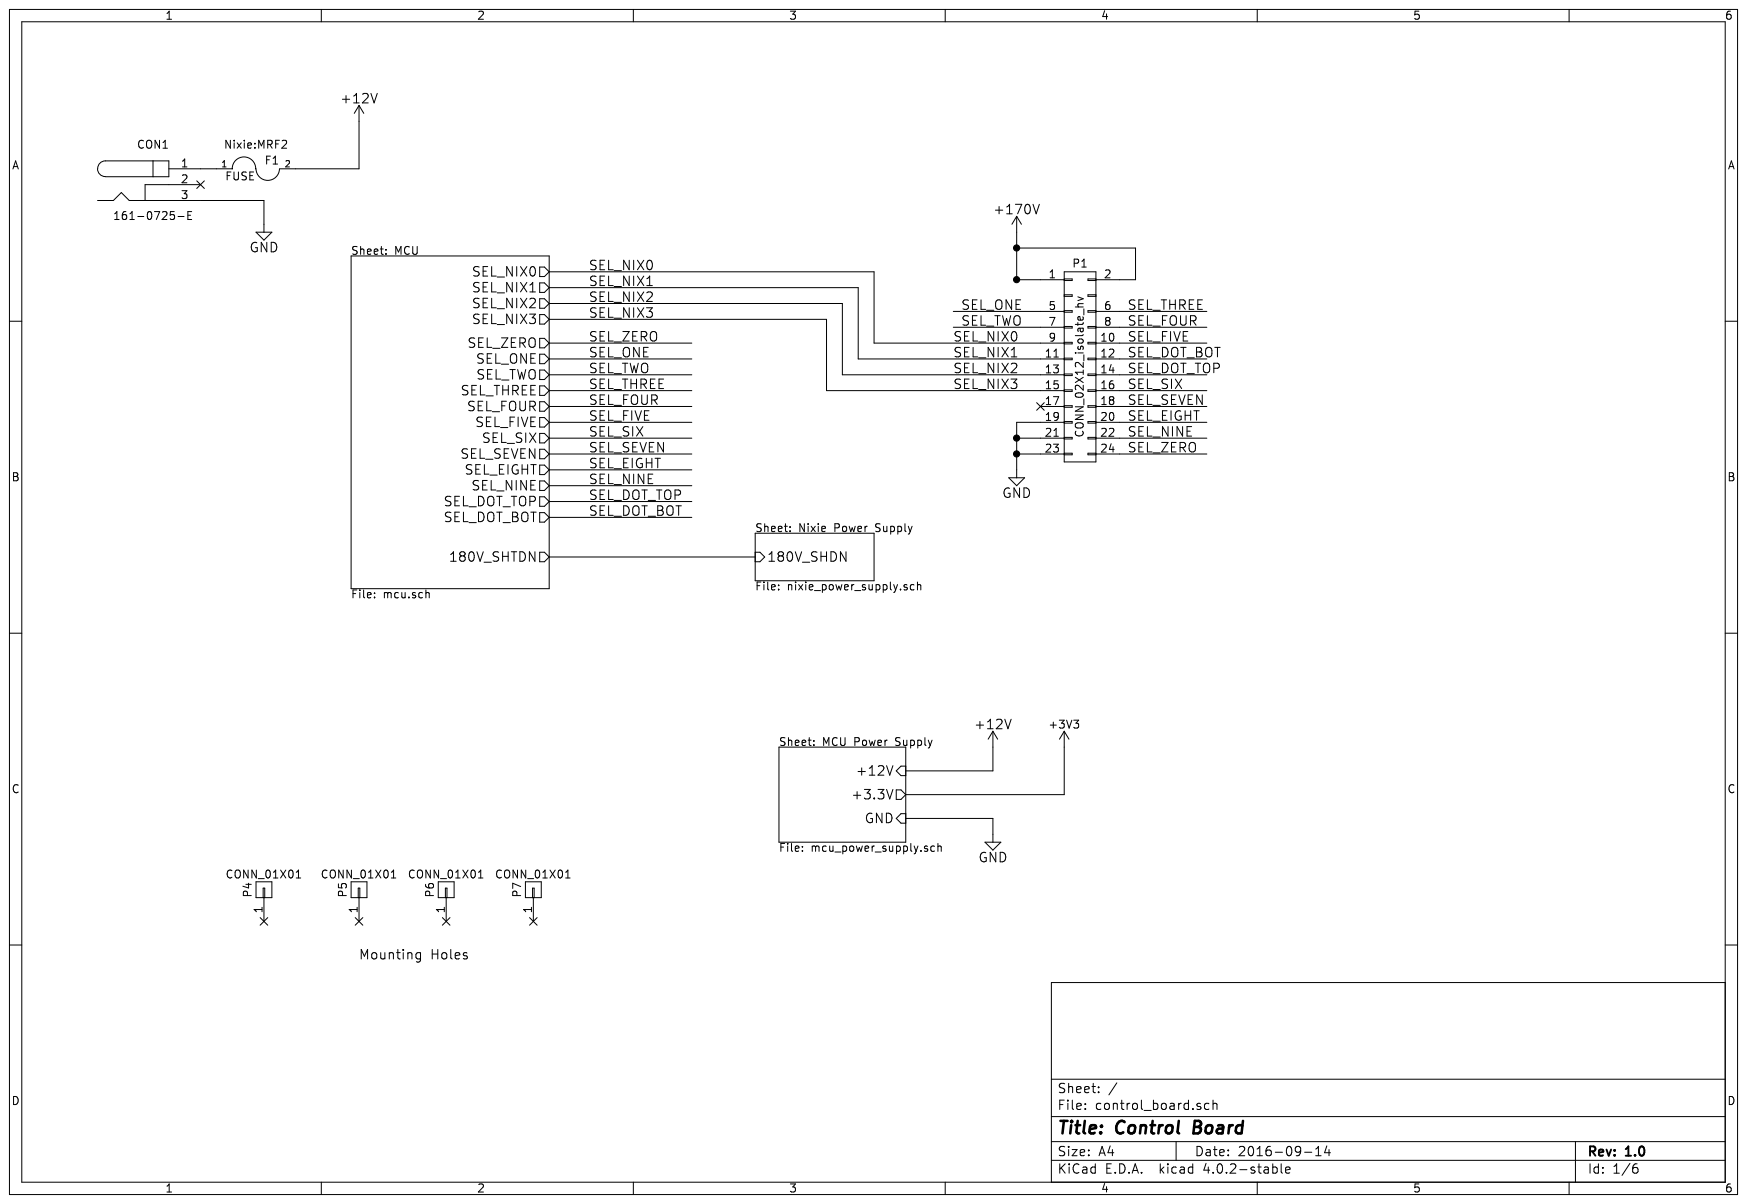
[picture p47: page 1]

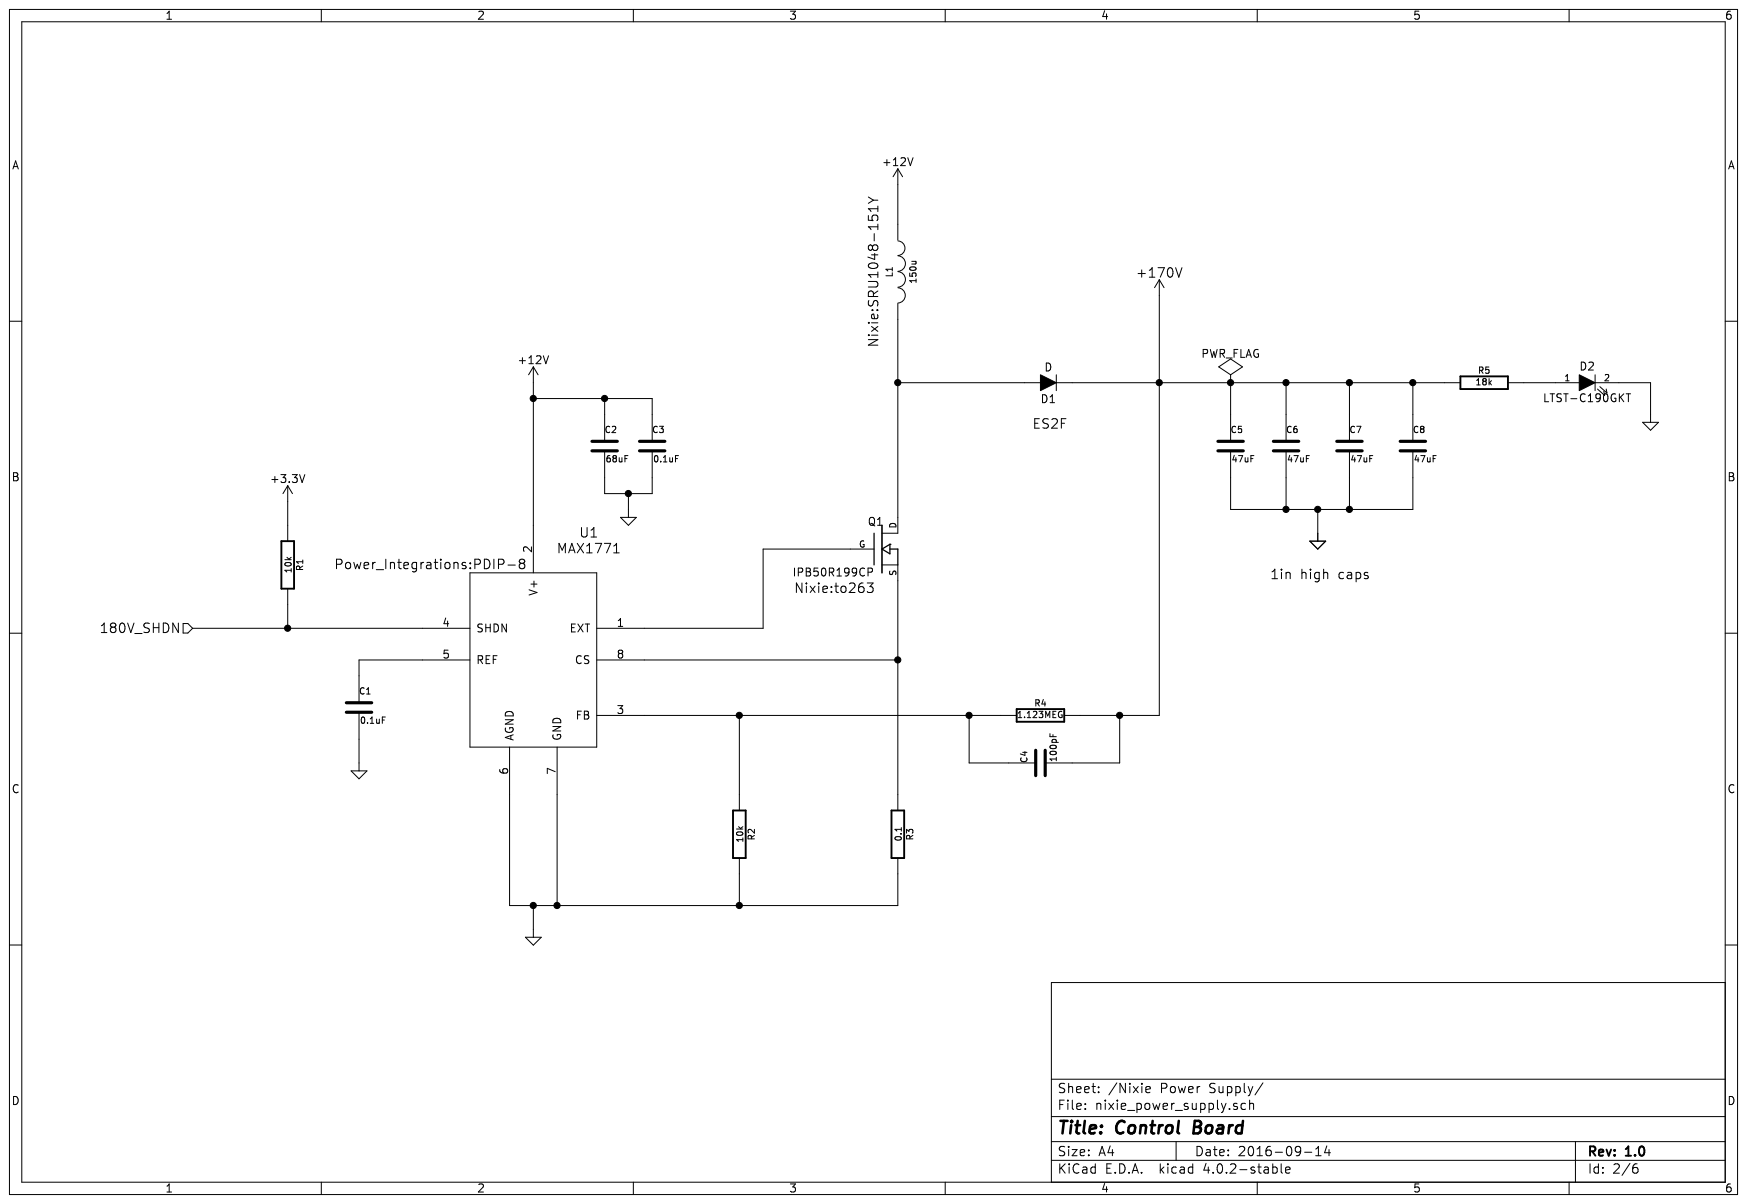
[picture p48: page 2]

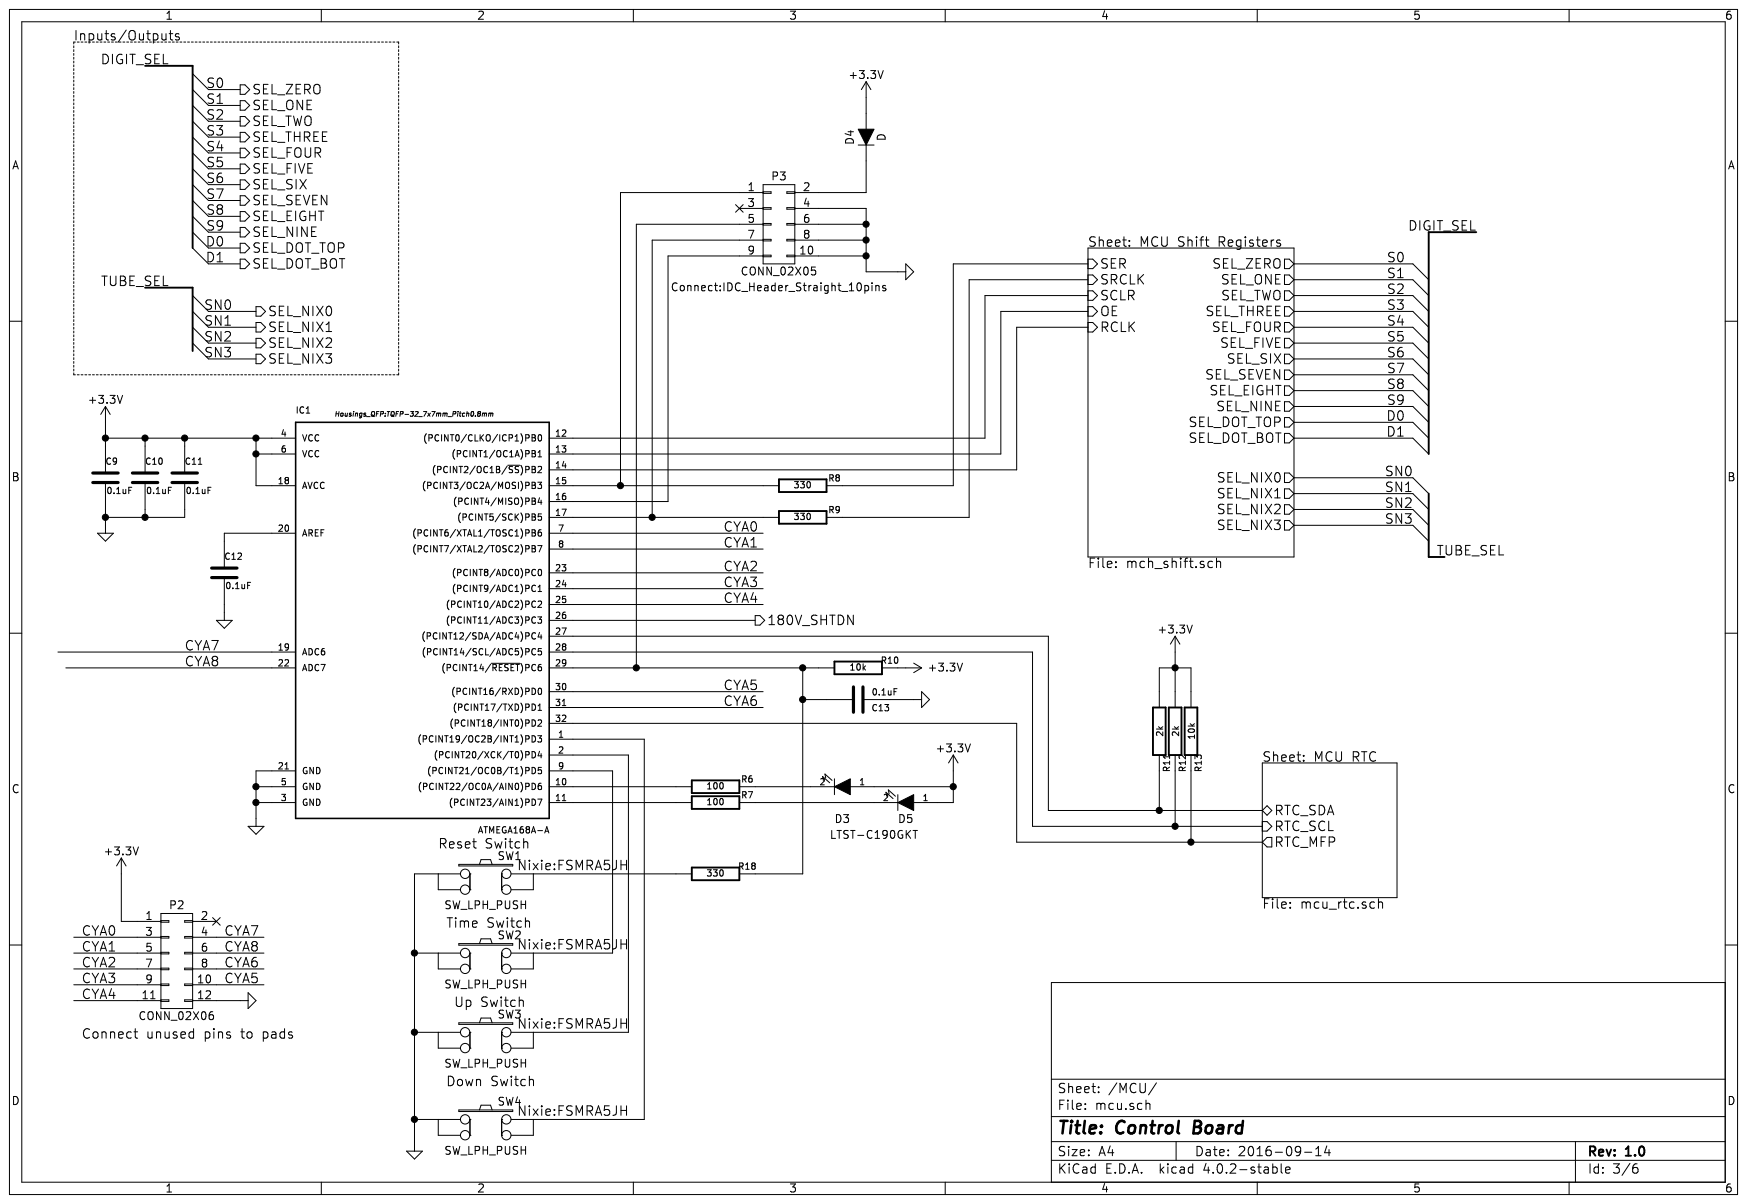
[picture p49: page 3]

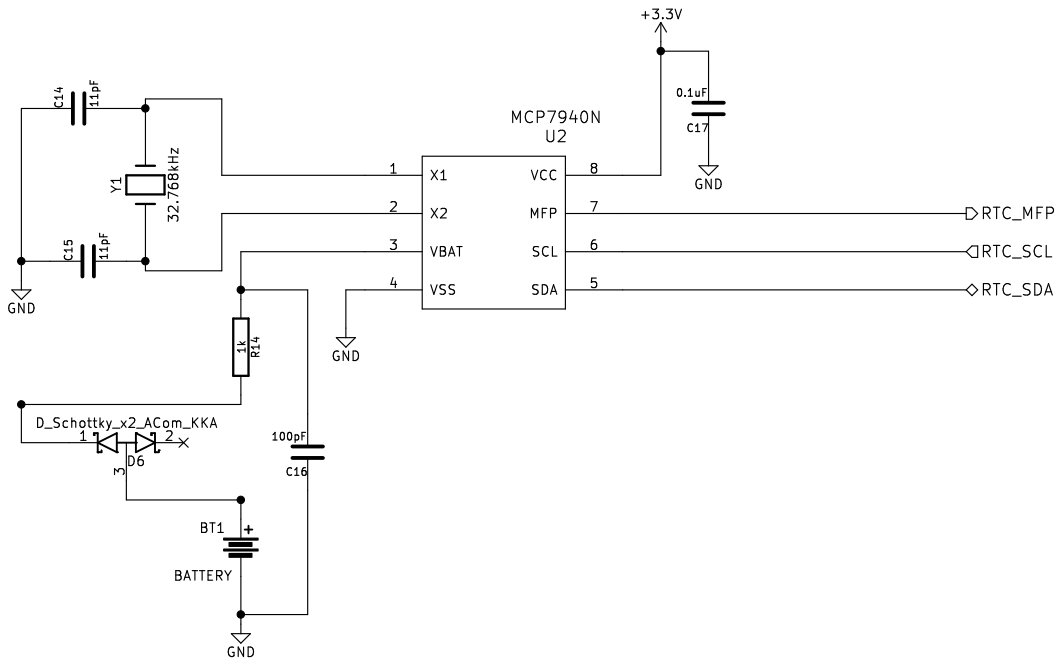
[picture p50: page 4]

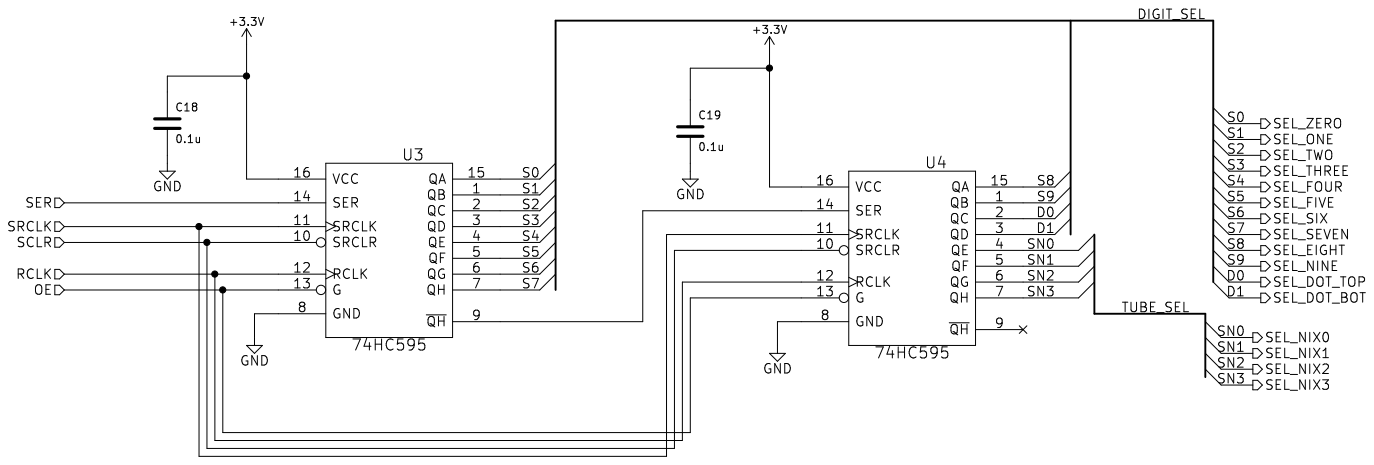
[picture p51: page 5]

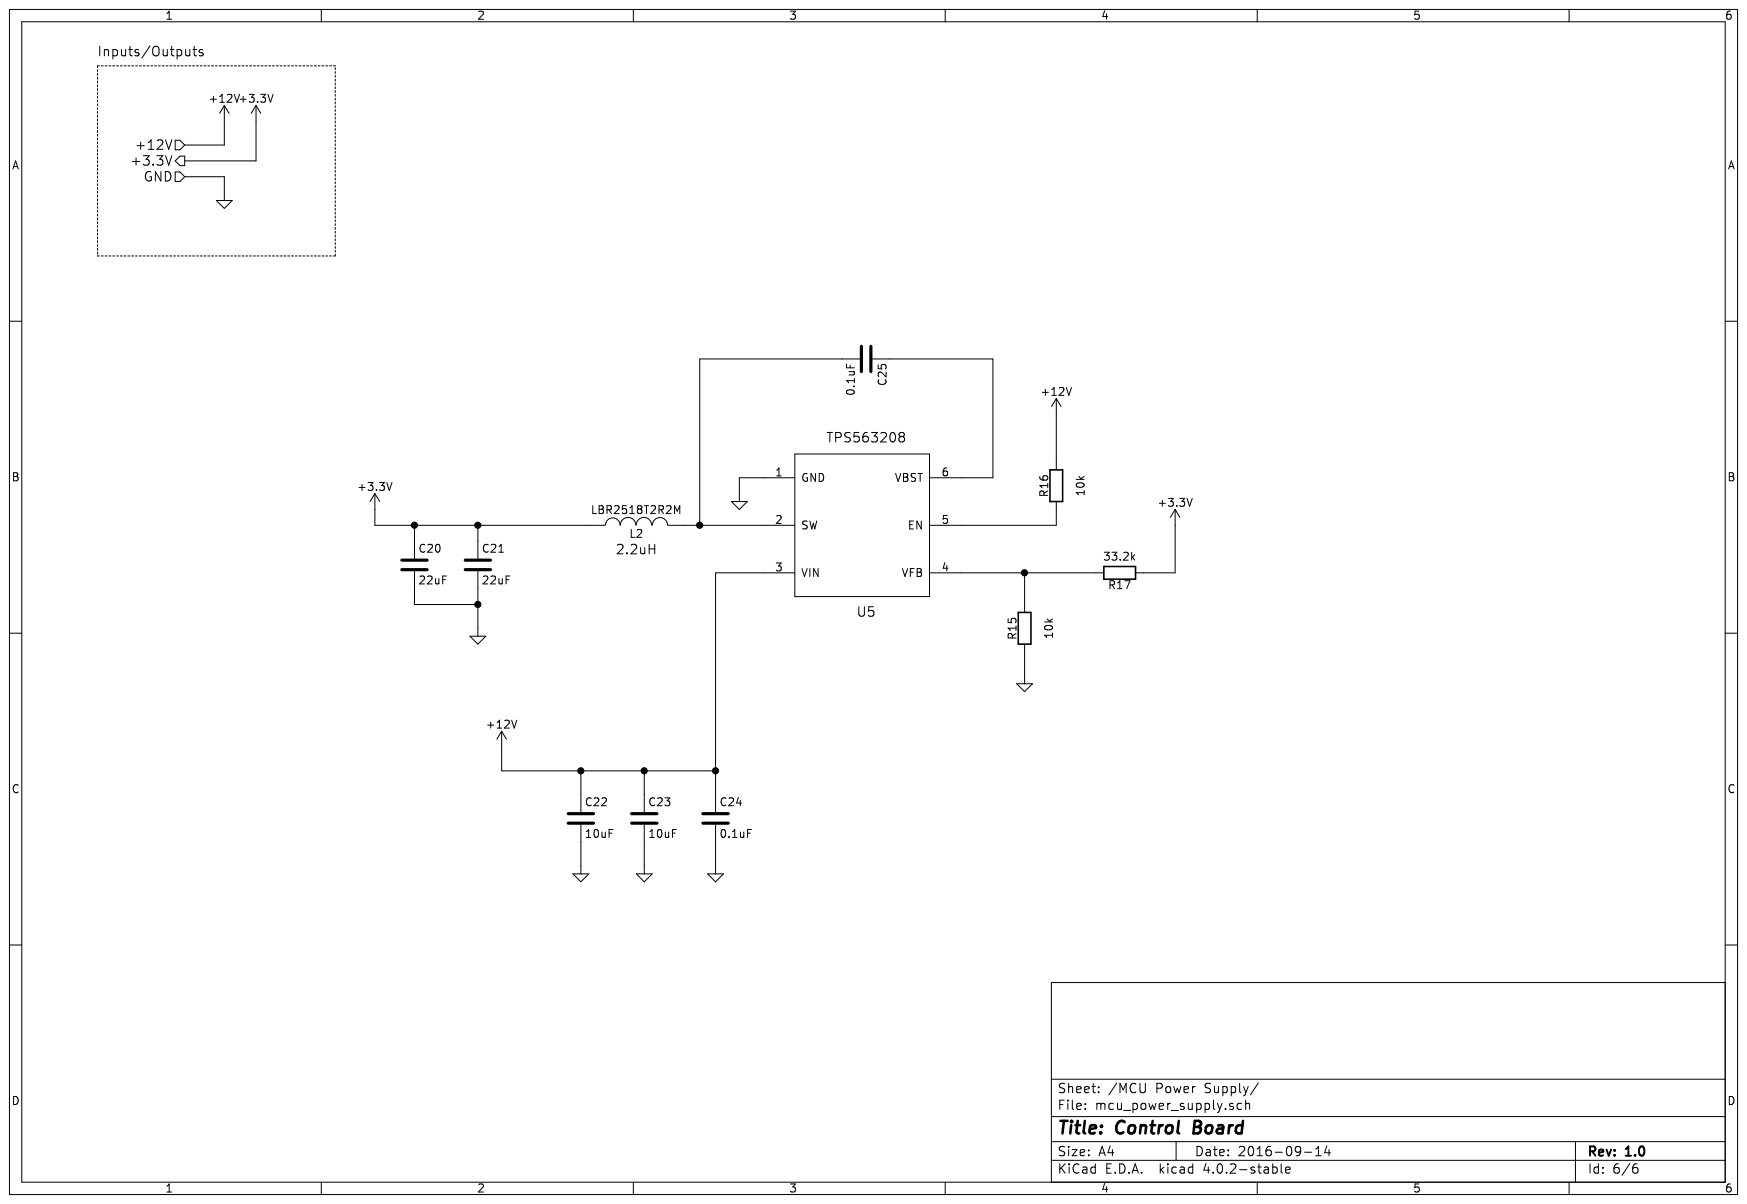
[picture p52: page 6]
