wildwoodashes/nixie_clock/hw/kicad_v1_0/projects/tube_shield/tube_shield_v1_0_gerber/tube_shield.pdf

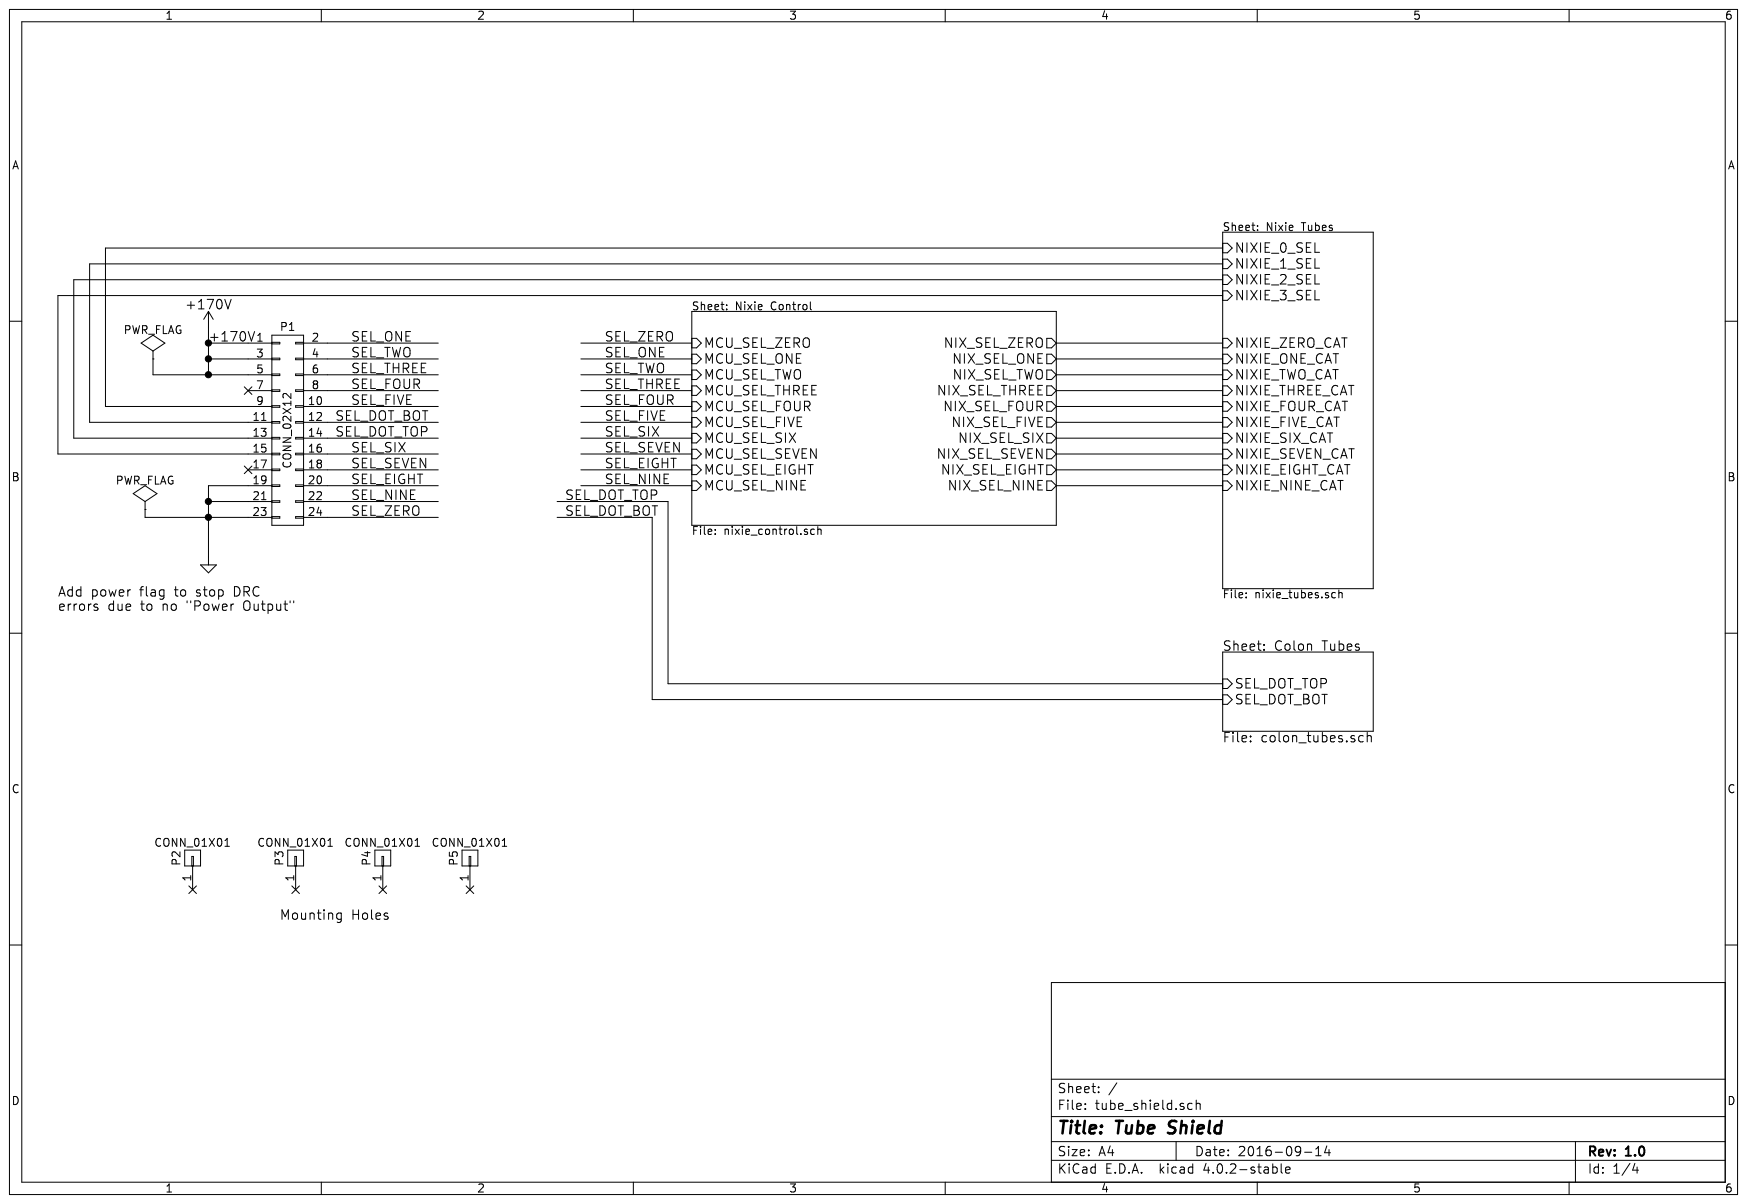
[picture p53: page 1]
