wildwoodashes/nixie_clock/(list of files, drawings)

Other design files:
doc/pcb/nixieclk.LAY
