wildwoodashes/nixie_clock/hw/kicad_v1_1/projects/control_board/control_board.kicad_pcb

## KiCad design hw/kicad_v1_1/projects/control_board/control_board.kicad_pcb (2016-12-23)

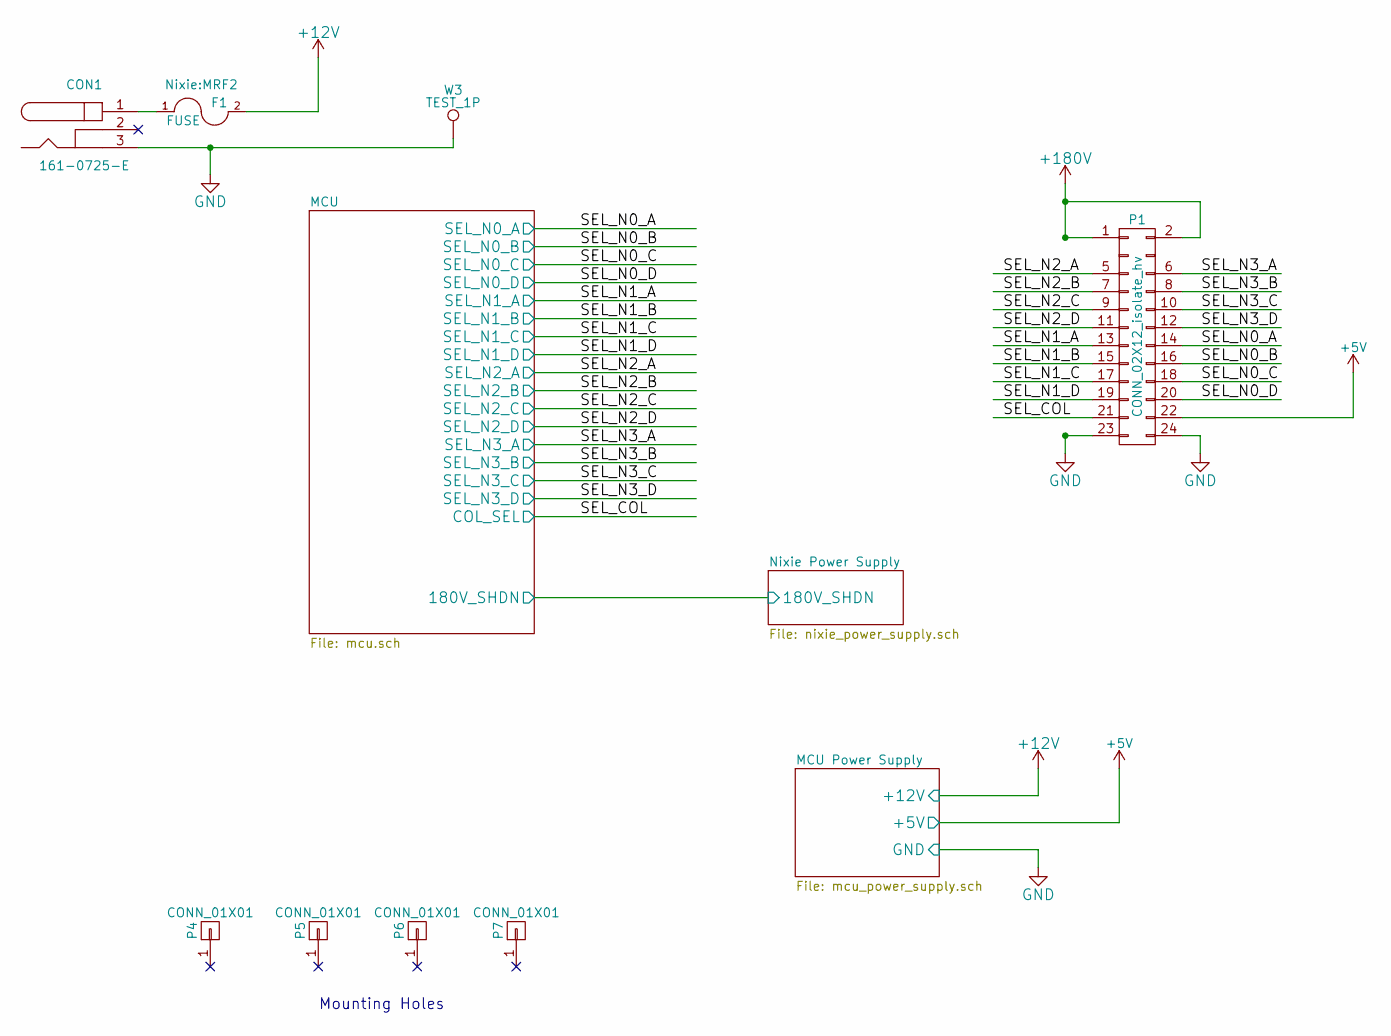
[picture p54: schematic control_board.sch, Control Board]

Parts:
CON1: 161-0725-E
F1: FUSE; MRF2
P1: CONN_02X12_isolate_hv
P4, P5, P6, P7: CONN_01X01; MountingHole_3.2mm_M3_ISO7380_Pad
W3: TEST_1P; Test_Point_Keystone_5019_Minature

Connections:
+5V: P1.22; also elsewhere on the board
+12V: F1.2; also elsewhere on the board
+180V: P1.1, P1.2; also elsewhere on the board
/SEL_COL: P1.21; also elsewhere on the board
/SEL_N0_A: P1.14; also elsewhere on the board
/SEL_N0_B: P1.16; also elsewhere on the board
/SEL_N0_C: P1.18; also elsewhere on the board
/SEL_N0_D: P1.20; also elsewhere on the board
/SEL_N1_A: P1.13; also elsewhere on the board
/SEL_N1_B: P1.15; also elsewhere on the board
/SEL_N1_C: P1.17; also elsewhere on the board
/SEL_N1_D: P1.19; also elsewhere on the board
/SEL_N2_A: P1.5; also elsewhere on the board
/SEL_N2_B: P1.7; also elsewhere on the board
/SEL_N2_C: P1.9; also elsewhere on the board
/SEL_N2_D: P1.11; also elsewhere on the board
/SEL_N3_A: P1.6; also elsewhere on the board
/SEL_N3_B: P1.8; also elsewhere on the board
/SEL_N3_C: P1.10; also elsewhere on the board
/SEL_N3_D: P1.12; also elsewhere on the board
GND: CON1.3, P1.23, P1.24, W3.1; also elsewhere on the board
unnamed: CON1.1, F1.1

Notes on the sheet:
Mounting Holes

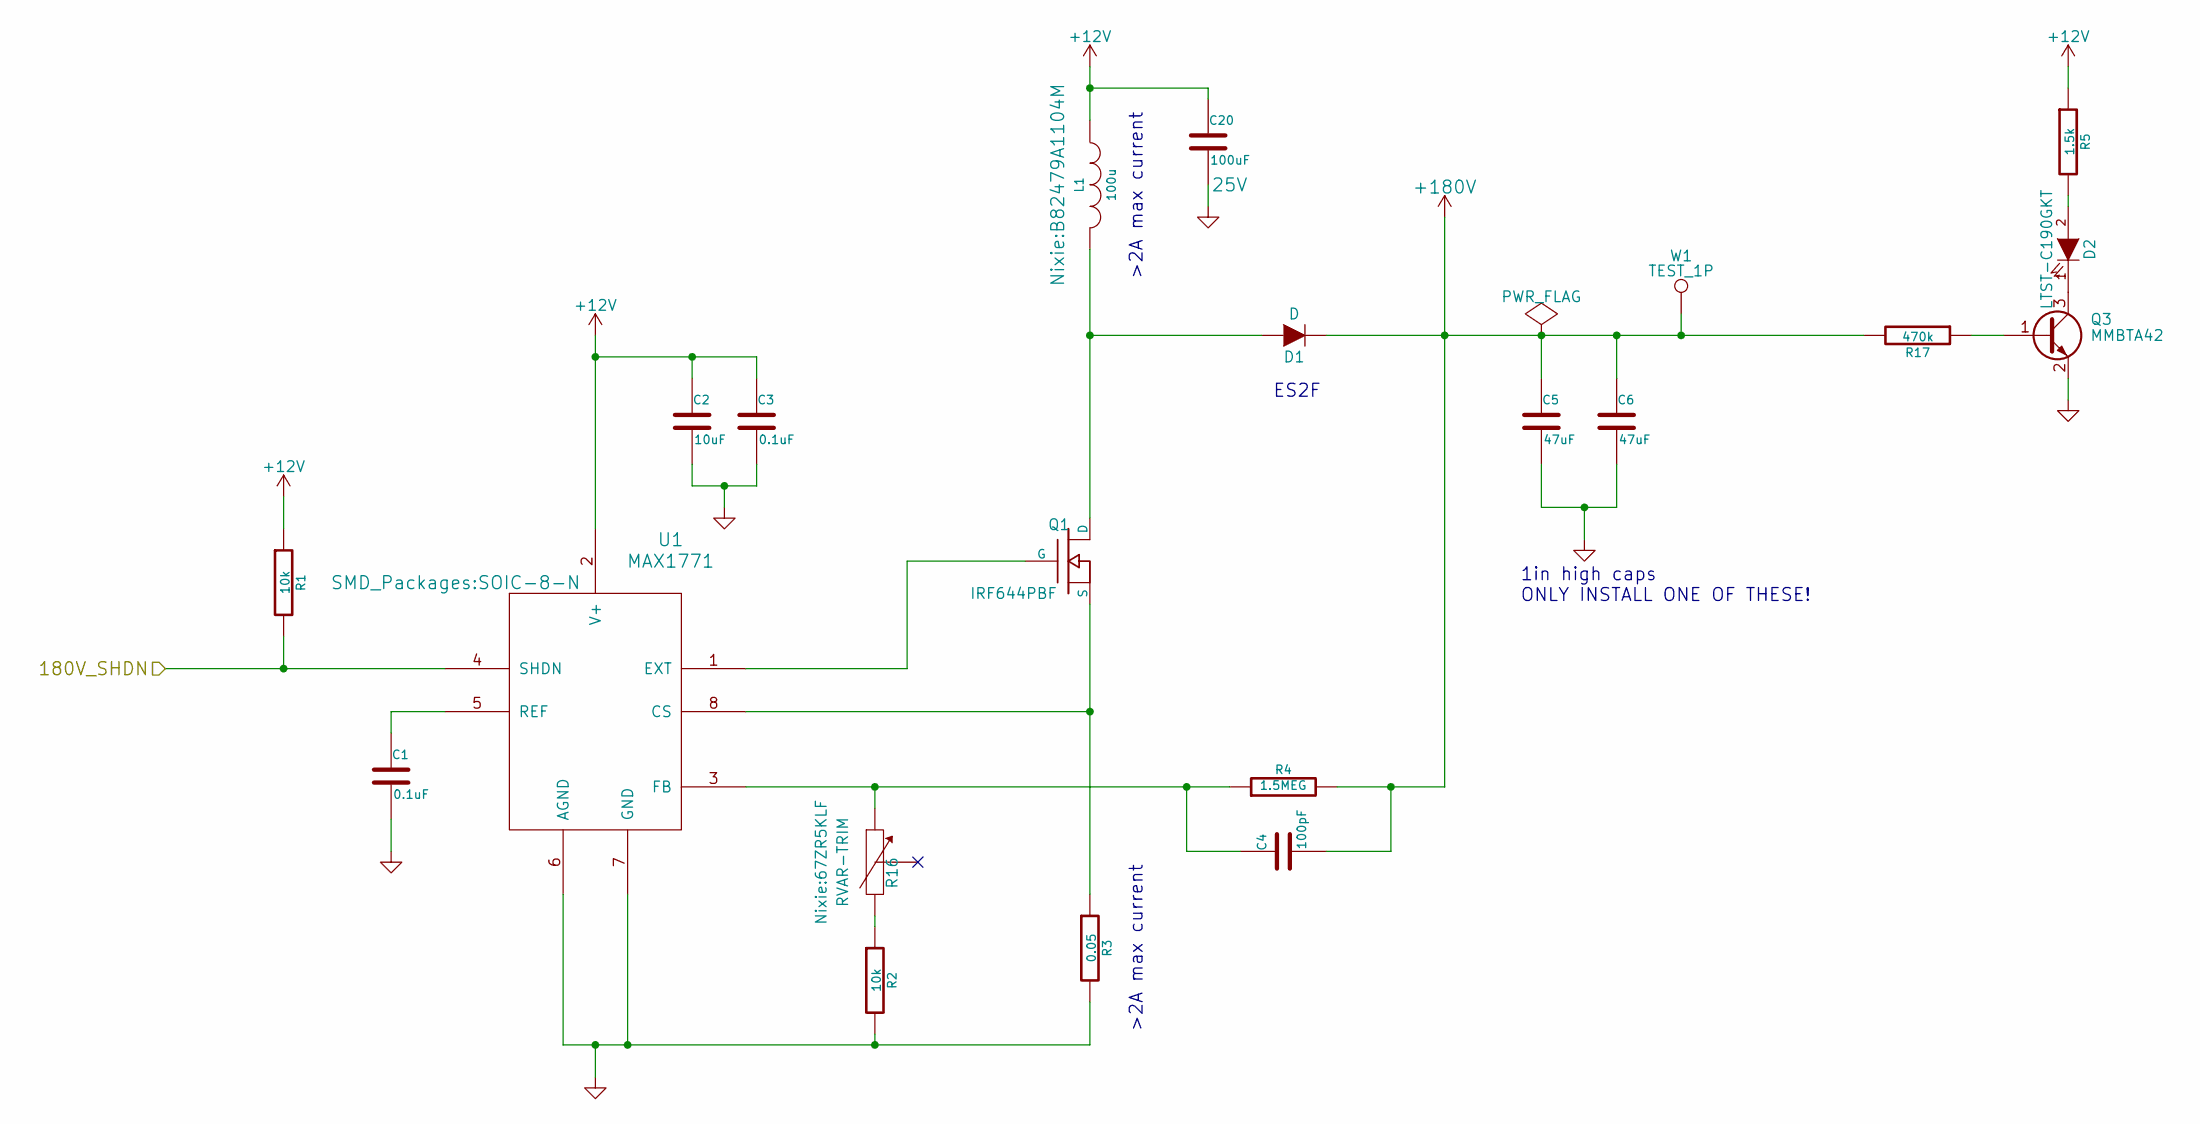
[picture p55: schematic nixie_power_supply.sch, Control Board]

Parts:
C1, C3: 0.1uF; C_0805_HandSoldering
C2: 10uF; C_1210_HandSoldering
C4: 100pF; C_0805_HandSoldering
C5, C6: 47uF; C_Radial_D12.5_L25_P5
C20: 100uF; c_elec_6.3x7.7; Voltage 25V
D1: D; DO-214AA-2
D2: LTST-C190GKT; LED_0603
L1: 100u; B82479A1104M
Q1: IRF644PBF; TO-220_Neutral123_Vertical
Q3: MMBTA42; SOT-23_Handsoldering
R1, R2: 10k; R_0805_HandSoldering
R3: 0.05; R_2512_HandSoldering
R4: 1.5MEG; R_1206_HandSoldering
R5: 1.5k; R_0805_HandSoldering
R16: RVAR-TRIM; 67ZR5KLF
R17: 470k; R_1206_HandSoldering
U1: MAX1771; SOIC-8-N
W1: TEST_1P; Measurement_Point_Round-TH_Big

Connections:
+12V: C2.1, C3.1, C20.1, L1.1, R1.1, R5.1, U1.2 (V+); also elsewhere on the board
+180V: C4.2, C5.1, C6.1, D1.1 (K), R4.2, R17.2, W1.1; also elsewhere on the board
/MCU/180V_SHDN: R1.2, U1.4 (SHDN); also elsewhere on the board
GND: C1.2, C2.2, C3.2, C5.2, C6.2, C20.2, Q3.2 (E), R2.2, R3.2, U1.6 (AGND), U1.7 (GND); also elsewhere on the board
unnamed: C1.1, U1.5 (REF)
unnamed: C4.1, R4.1, R16.1, U1.3 (FB)
unnamed: D1.2 (A), L1.2, Q1.2 (D)
unnamed: D2.1 (K), Q3.3 (C)
unnamed: D2.2 (A), R5.2
unnamed: Q1.1 (G), U1.1 (EXT)
unnamed: Q1.3 (S), R3.1, U1.8 (CS)
unnamed: Q3.1 (B), R17.1
unnamed: R2.1, R16.2

Notes on the sheet:
1in high caps ONLY INSTALL ONE OF THESE!
ES2F
>2A max current

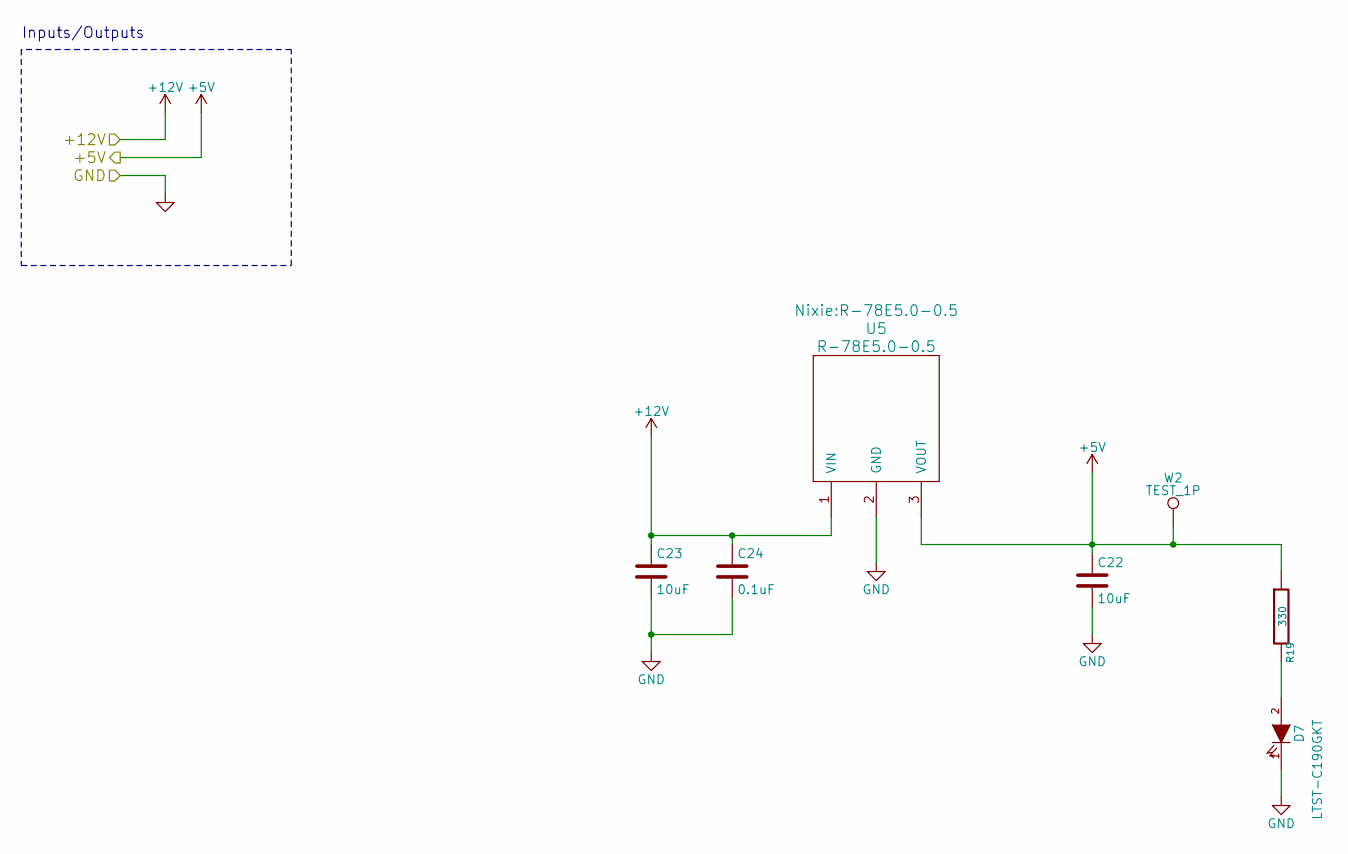
[picture p56: schematic mcu_power_supply.sch, Control Board]

Parts:
C22, C23: 10uF; C_0805_HandSoldering
C24: 0.1uF; C_0805_HandSoldering
D7: LTST-C190GKT; LED_0603
R19: 330; R_0805_HandSoldering
U5: R-78E5.0-0.5
W2: TEST_1P; Measurement_Point_Round-TH_Big

Connections:
+5V: C22.1, R19.1, U5.3 (VOUT), W2.1; also elsewhere on the board
+12V: C23.1, C24.1, U5.1 (VIN); also elsewhere on the board
GND: C22.2, C23.2, C24.2, D7.1 (K), U5.2 (GND); also elsewhere on the board
unnamed: D7.2 (A), R19.2

Notes on the sheet:
Inputs/Outputs

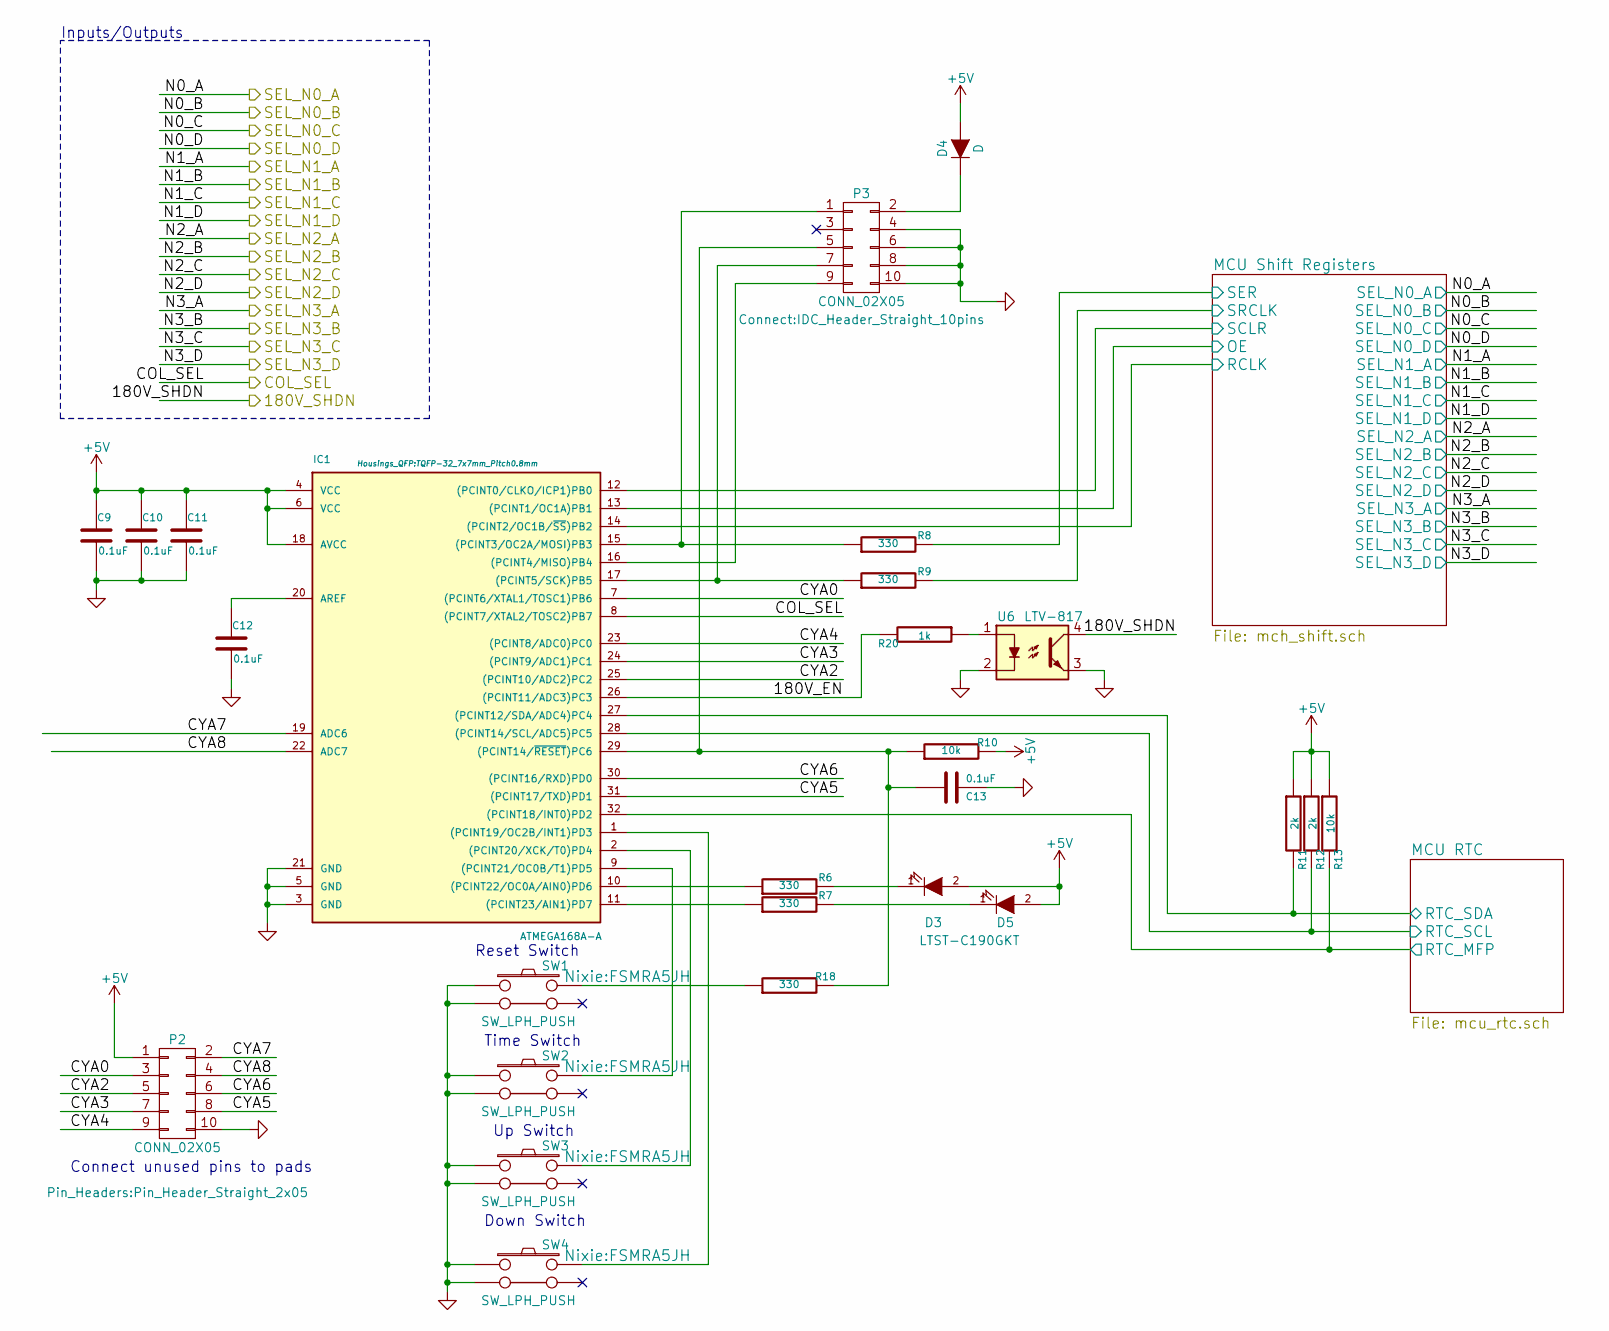
[picture p57: schematic mcu.sch, Control Board]

Parts:
C9, C10, C11, C12, C13: 0.1uF; C_0805_HandSoldering
D3, D5: LTST-C190GKT; LED_0603
D4: D; SOD-523-2
IC1: ATMEGA168A-A; TQFP-32_7x7mm_Pitch0.8mm
P2: CONN_02X05; Pin_Header_Straight_2x05
P3: CONN_02X05; IDC_Header_Straight_10pins
R6, R7, R8, R9, R18: 330; R_0805_HandSoldering
R10, R13: 10k; R_0805_HandSoldering
R11, R12: 2k; R_0805_HandSoldering
R20: 1k; R_0805_HandSoldering
SW1, SW2, SW3, SW4: SW_LPH_PUSH; FSMRA5JH
U6: LTV-817; Optocoupler_SMD_LTV-817S

Connections:
+5V: C9.1, C10.1, C11.1, D3.2 (A), D4.2 (A), D5.2 (A), IC1.4 (VCC), IC1.6 (VCC), IC1.18 (AVCC), P2.1, R10.2, R11.1, R12.1, R13.1; also elsewhere on the board
/MCU/180V_EN: IC1.26 ((PCINT11/ADC3)PC3), R20.2
/MCU/180V_SHDN: U6.4; also elsewhere on the board
/MCU/CYA0: IC1.7 ((PCINT6/XTAL1/TOSC1)PB6), P2.3
/MCU/CYA2: IC1.25 ((PCINT10/ADC2)PC2), P2.5
/MCU/CYA3: IC1.24 ((PCINT9/ADC1)PC1), P2.7
/MCU/CYA4: IC1.23 ((PCINT8/ADC0)PC0), P2.9
/MCU/CYA5: IC1.31 ((PCINT17/TXD)PD1), P2.8
/MCU/CYA6: IC1.30 ((PCINT16/RXD)PD0), P2.6
/MCU/CYA7: IC1.19 (ADC6), P2.2
/MCU/CYA8: IC1.22 (ADC7), P2.4
/MCU/MCU RTC/RTC_MFP: IC1.32 ((PCINT18/INT0)PD2), R13.2; also elsewhere on the board
/MCU/MCU RTC/RTC_SCL: IC1.28 ((PCINT14/SCL/ADC5)PC5), R12.2; also elsewhere on the board
/MCU/MCU RTC/RTC_SDA: IC1.27 ((PCINT12/SDA/ADC4)PC4), R11.2; also elsewhere on the board
/MCU/MCU Shift Registers/OE: IC1.13 ((PCINT1/OC1A)PB1); also elsewhere on the board
/MCU/MCU Shift Registers/RCLK: IC1.14 ((PCINT2/OC1B/~SS~)PB2); also elsewhere on the board
/MCU/MCU Shift Registers/SCLR: IC1.12 ((PCINT0/CLKO/ICP1)PB0); also elsewhere on the board
/MCU/MCU Shift Registers/SER: R8.2; also elsewhere on the board
/MCU/MCU Shift Registers/SRCLK: R9.2; also elsewhere on the board
/SEL_COL: IC1.8 ((PCINT7/XTAL2/TOSC2)PB7); also elsewhere on the board
GND: C9.2, C10.2, C11.2, C12.2, C13.2, IC1.3 (GND), IC1.5 (GND), IC1.21 (GND), P2.10, P3.4, P3.6, P3.8, P3.10, SW1.1, SW1.4, SW2.1, SW2.4, SW3.1, SW3.4, SW4.1, SW4.4, U6.2, U6.3; also elsewhere on the board
unnamed: C12.1, IC1.20 (AREF)
unnamed: C13.1, IC1.29 ((PCINT14/~RESET~)PC6), P3.5, R10.1, R18.2
unnamed: D3.1 (K), R6.2
unnamed: D4.1 (K), P3.2
unnamed: D5.1 (K), R7.2
unnamed: IC1.1 ((PCINT19/OC2B/INT1)PD3), SW4.2
unnamed: IC1.2 ((PCINT20/XCK/T0)PD4), SW3.2
unnamed: IC1.9 ((PCINT21/OC0B/T1)PD5), SW2.2
unnamed: IC1.10 ((PCINT22/OC0A/AIN0)PD6), R6.1
unnamed: IC1.11 ((PCINT23/AIN1)PD7), R7.1
unnamed: IC1.15 ((PCINT3/OC2A/MOSI)PB3), P3.1, R8.1
unnamed: IC1.16 ((PCINT4/MISO)PB4), P3.9
unnamed: IC1.17 ((PCINT5/SCK)PB5), P3.7, R9.1
unnamed: R18.1, SW1.2
unnamed: R20.1, U6.1

Notes on the sheet:
Inputs/Outputs
Reset Switch
Time Switch
Up Switch
Down Switch
Connect unused pins to pads

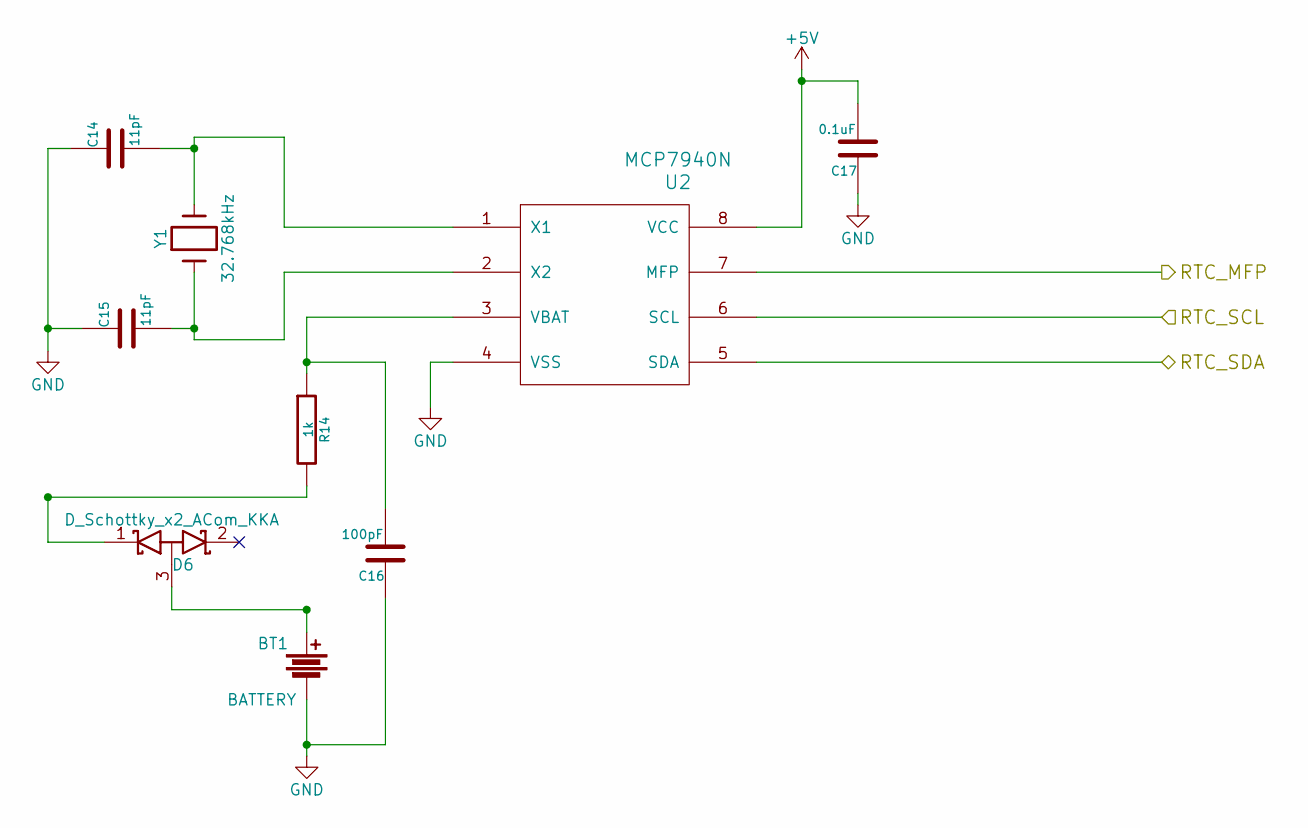
[picture p58: schematic mcu_rtc.sch, Control Board]

Parts:
BT1: BATTERY; smtu2032-c
C14, C15: 11pF; C_0603_HandSoldering
C16: 100pF; C_0805_HandSoldering
C17: 0.1uF; C_0805_HandSoldering
D6: D_Schottky_x2_ACom_KKA; SOT-323
R14: 1k; R_0805_HandSoldering
U2: MCP7940N; SOIC-8_3.9x4.9mm_Pitch1.27mm
Y1: 32.768kHz; ABS25

Connections:
+5V: C17.2, U2.8 (VCC); also elsewhere on the board
/MCU/MCU RTC/RTC_MFP: U2.7 (MFP); also elsewhere on the board
/MCU/MCU RTC/RTC_SCL: U2.6 (SCL); also elsewhere on the board
/MCU/MCU RTC/RTC_SDA: U2.5 (SDA); also elsewhere on the board
GND: BT1.2, C14.1, C15.1, C16.1, C17.1, U2.4 (VSS); also elsewhere on the board
unnamed: BT1.1, D6.3 (A)
unnamed: C14.2, U2.1 (X1), Y1.2
unnamed: C15.2, U2.2 (X2), Y1.1
unnamed: C16.2, R14.1, U2.3 (VBAT)
unnamed: D6.1 (K), R14.2

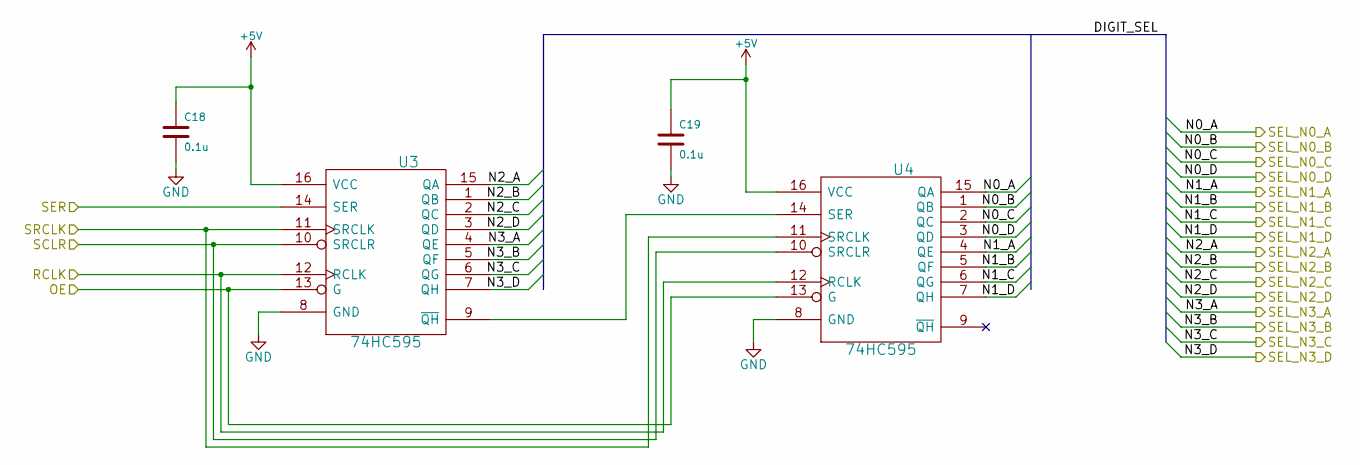
[picture p59: schematic mch_shift.sch, Control Board]

Parts:
C18, C19: 0.1u; C_0805_HandSoldering
U3, U4: 74HC595; SOIC-16_3.9x9.9mm_Pitch1.27mm

Connections:
+5V: C18.1, C19.1, U3.16 (VCC), U4.16 (VCC); also elsewhere on the board
/MCU/MCU Shift Registers/OE: U3.13 (G), U4.13 (G); also elsewhere on the board
/MCU/MCU Shift Registers/RCLK: U3.12 (RCLK), U4.12 (RCLK); also elsewhere on the board
/MCU/MCU Shift Registers/SCLR: U3.10 (SRCLR), U4.10 (SRCLR); also elsewhere on the board
/MCU/MCU Shift Registers/SER: U3.14 (SER); also elsewhere on the board
/MCU/MCU Shift Registers/SRCLK: U3.11 (SRCLK), U4.11 (SRCLK); also elsewhere on the board
/SEL_N0_A: U4.15 (QA); also elsewhere on the board
/SEL_N0_B: U4.1 (QB); also elsewhere on the board
/SEL_N0_C: U4.2 (QC); also elsewhere on the board
/SEL_N0_D: U4.3 (QD); also elsewhere on the board
/SEL_N1_A: U4.4 (QE); also elsewhere on the board
/SEL_N1_B: U4.5 (QF); also elsewhere on the board
/SEL_N1_C: U4.6 (QG); also elsewhere on the board
/SEL_N1_D: U4.7 (QH); also elsewhere on the board
/SEL_N2_A: U3.15 (QA); also elsewhere on the board
/SEL_N2_B: U3.1 (QB); also elsewhere on the board
/SEL_N2_C: U3.2 (QC); also elsewhere on the board
/SEL_N2_D: U3.3 (QD); also elsewhere on the board
/SEL_N3_A: U3.4 (QE); also elsewhere on the board
/SEL_N3_B: U3.5 (QF); also elsewhere on the board
/SEL_N3_C: U3.6 (QG); also elsewhere on the board
/SEL_N3_D: U3.7 (QH); also elsewhere on the board
GND: C18.2, C19.2, U3.8 (GND), U4.8 (GND); also elsewhere on the board
unnamed: U3.9 (~QH), U4.14 (SER)

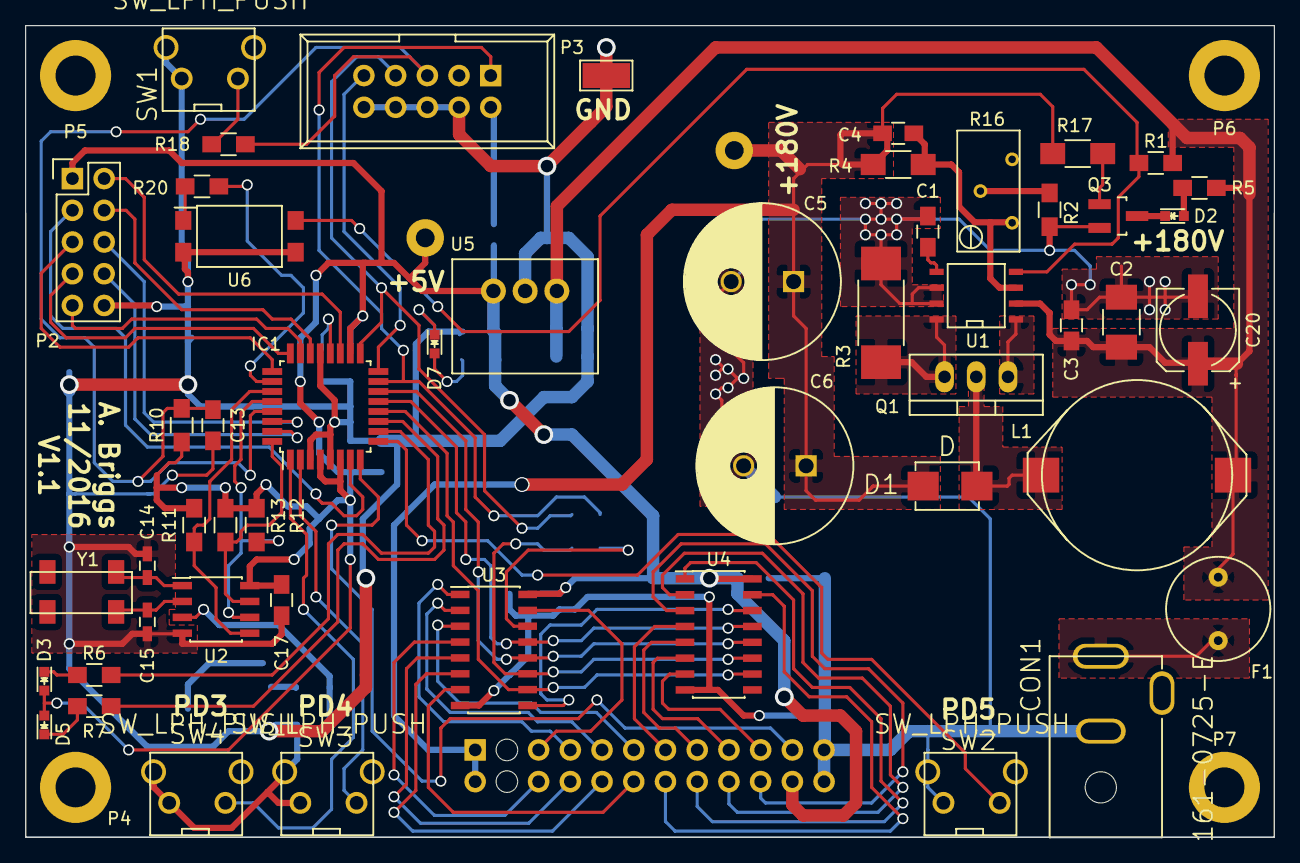
[picture p60: board control_board.kicad_pcb from above]

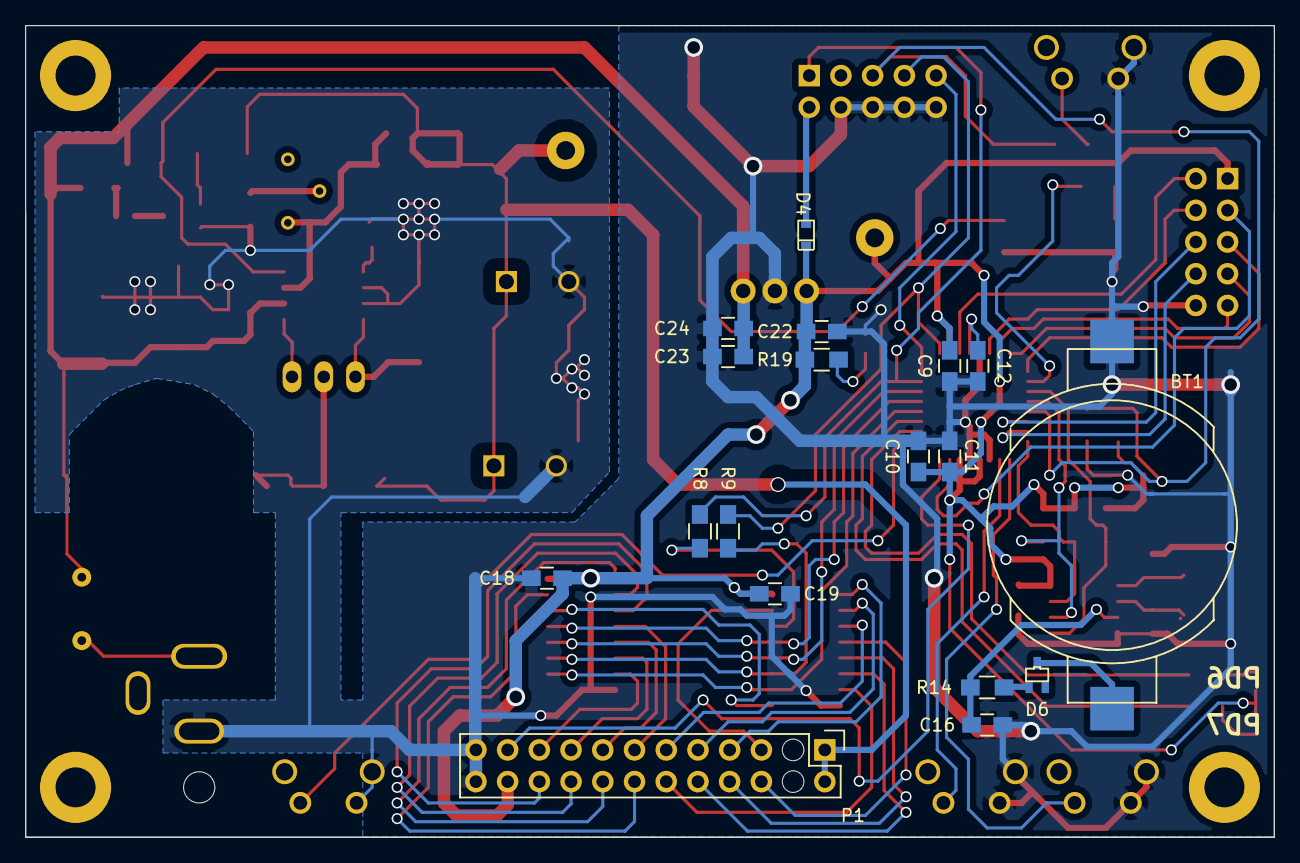
[picture p61: board control_board.kicad_pcb from below]

Board: 2 copper layers, 100.0 x 65.0 mm, 75 parts (19 on the bottom side), 71 nets.
