wildwoodashes/nixie_clock/hw/kicad_v1_1/projects/tube_shield/tube_shield.kicad_pcb

## KiCad design hw/kicad_v1_1/projects/tube_shield/tube_shield.kicad_pcb (2016-12-23)

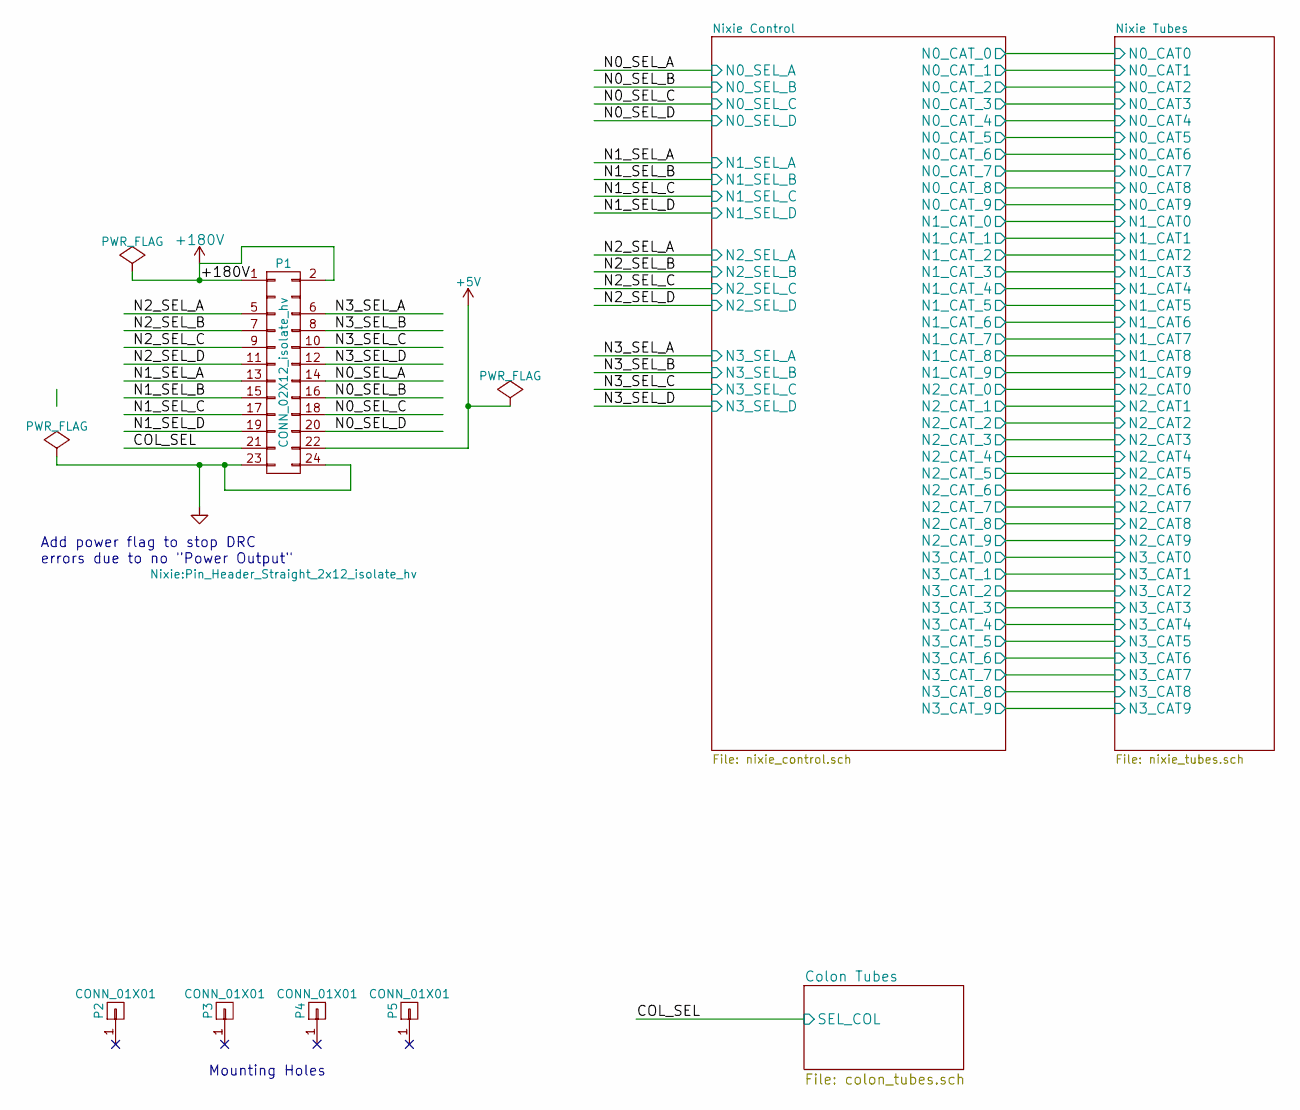
[picture p62: schematic tube_shield.sch, Tube Shield]

Parts:
P1: CONN_02X12_isolate_hv; Pin_Header_Straight_2x12_isolate_hv
P2: CONN_01X01; MountingHole_3.2mm_M3_ISO7380_Pad
P3, P4, P5: CONN_01X01; MountingHole_3.2mm_M3_ISO14580_Pad

Connections:
+5V: P1.22; also elsewhere on the board
+180V: P1.1, P1.2; also elsewhere on the board
/COL_SEL: P1.21; also elsewhere on the board
/N0_SEL_A: P1.14; also elsewhere on the board
/N0_SEL_B: P1.16; also elsewhere on the board
/N0_SEL_C: P1.18; also elsewhere on the board
/N0_SEL_D: P1.20; also elsewhere on the board
/N1_SEL_A: P1.13; also elsewhere on the board
/N1_SEL_B: P1.15; also elsewhere on the board
/N1_SEL_C: P1.17; also elsewhere on the board
/N1_SEL_D: P1.19; also elsewhere on the board
/N2_SEL_A: P1.5; also elsewhere on the board
/N2_SEL_B: P1.7; also elsewhere on the board
/N2_SEL_C: P1.9; also elsewhere on the board
/N2_SEL_D: P1.11; also elsewhere on the board
/N3_SEL_A: P1.6; also elsewhere on the board
/N3_SEL_B: P1.8; also elsewhere on the board
/N3_SEL_C: P1.10; also elsewhere on the board
/N3_SEL_D: P1.12; also elsewhere on the board
GND: P1.23, P1.24; also elsewhere on the board

Notes on the sheet:
Add power flag to stop DRC errors due to no "Power Output"
Mounting Holes

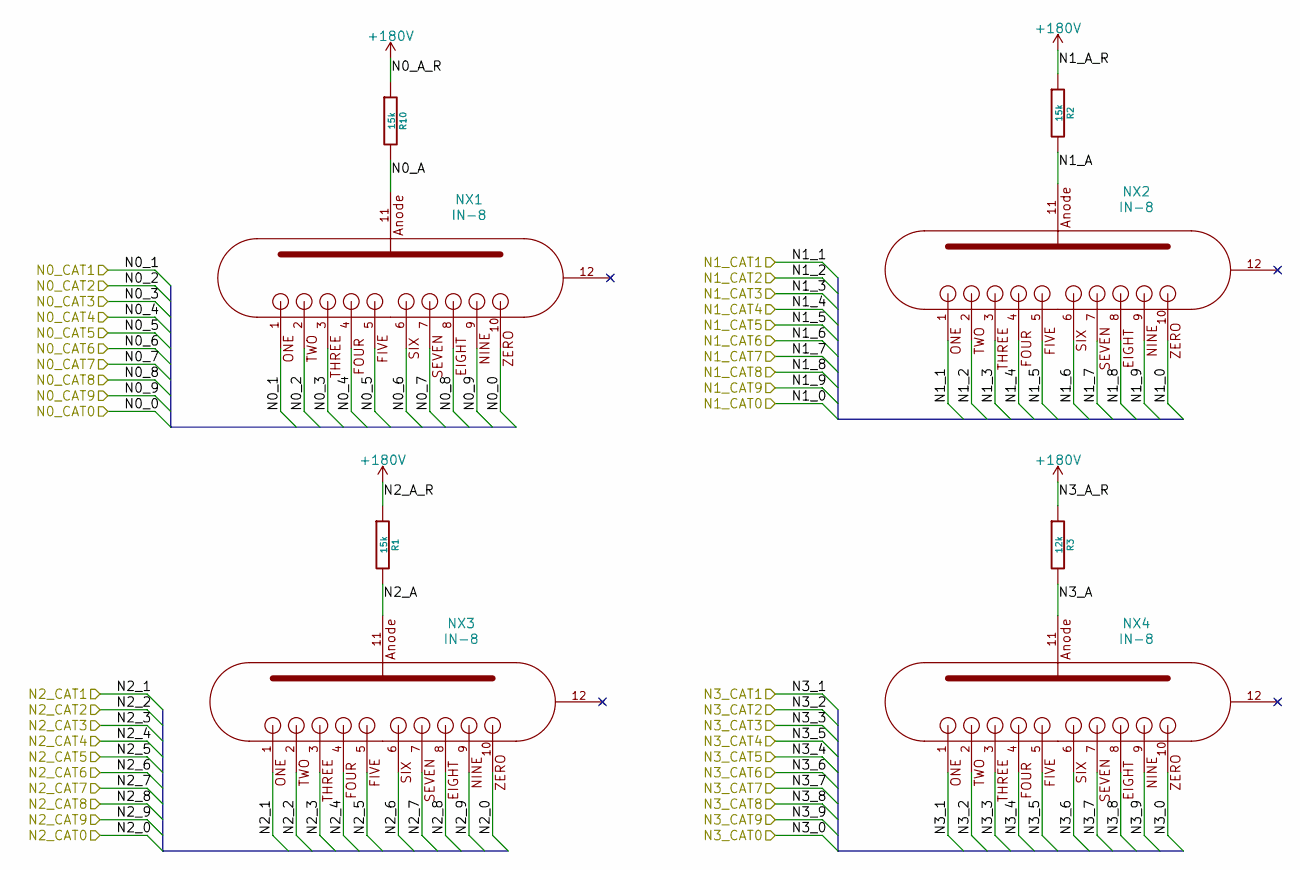
[picture p63: schematic nixie_tubes.sch, Tube Shield]

Parts:
NX1, NX2, NX3, NX4: IN-8; pl27-1pd
R1, R2, R10: 15k; R_1206_HandSoldering
R3: 12k; R_1206_HandSoldering

Connections:
+180V: R1.1, R2.1, R3.1, R10.1; also elsewhere on the board
/Nixie Tubes/N0_A: NX1.11 (Anode), R10.2
/Nixie Tubes/N0_CAT0: NX1.10 (ZERO); also elsewhere on the board
/Nixie Tubes/N0_CAT1: NX1.1 (ONE); also elsewhere on the board
/Nixie Tubes/N0_CAT2: NX1.2 (TWO); also elsewhere on the board
/Nixie Tubes/N0_CAT3: NX1.3 (THREE); also elsewhere on the board
/Nixie Tubes/N0_CAT4: NX1.4 (FOUR); also elsewhere on the board
/Nixie Tubes/N0_CAT5: NX1.5 (FIVE); also elsewhere on the board
/Nixie Tubes/N0_CAT6: NX1.6 (SIX); also elsewhere on the board
/Nixie Tubes/N0_CAT7: NX1.7 (SEVEN); also elsewhere on the board
/Nixie Tubes/N0_CAT8: NX1.8 (EIGHT); also elsewhere on the board
/Nixie Tubes/N0_CAT9: NX1.9 (NINE); also elsewhere on the board
/Nixie Tubes/N1_A: NX2.11 (Anode), R2.2
/Nixie Tubes/N1_CAT0: NX2.10 (ZERO); also elsewhere on the board
/Nixie Tubes/N1_CAT1: NX2.1 (ONE); also elsewhere on the board
/Nixie Tubes/N1_CAT2: NX2.2 (TWO); also elsewhere on the board
/Nixie Tubes/N1_CAT3: NX2.3 (THREE); also elsewhere on the board
/Nixie Tubes/N1_CAT4: NX2.4 (FOUR); also elsewhere on the board
/Nixie Tubes/N1_CAT5: NX2.5 (FIVE); also elsewhere on the board
/Nixie Tubes/N1_CAT6: NX2.6 (SIX); also elsewhere on the board
/Nixie Tubes/N1_CAT7: NX2.7 (SEVEN); also elsewhere on the board
/Nixie Tubes/N1_CAT8: NX2.8 (EIGHT); also elsewhere on the board
/Nixie Tubes/N1_CAT9: NX2.9 (NINE); also elsewhere on the board
/Nixie Tubes/N2_A: NX3.11 (Anode), R1.2
/Nixie Tubes/N2_CAT0: NX3.10 (ZERO); also elsewhere on the board
/Nixie Tubes/N2_CAT1: NX3.1 (ONE); also elsewhere on the board
/Nixie Tubes/N2_CAT2: NX3.2 (TWO); also elsewhere on the board
/Nixie Tubes/N2_CAT3: NX3.3 (THREE); also elsewhere on the board
/Nixie Tubes/N2_CAT4: NX3.4 (FOUR); also elsewhere on the board
/Nixie Tubes/N2_CAT5: NX3.5 (FIVE); also elsewhere on the board
/Nixie Tubes/N2_CAT6: NX3.6 (SIX); also elsewhere on the board
/Nixie Tubes/N2_CAT7: NX3.7 (SEVEN); also elsewhere on the board
/Nixie Tubes/N2_CAT8: NX3.8 (EIGHT); also elsewhere on the board
/Nixie Tubes/N2_CAT9: NX3.9 (NINE); also elsewhere on the board
/Nixie Tubes/N3_A: NX4.11 (Anode), R3.2
/Nixie Tubes/N3_CAT0: NX4.10 (ZERO); also elsewhere on the board
/Nixie Tubes/N3_CAT1: NX4.1 (ONE); also elsewhere on the board
/Nixie Tubes/N3_CAT2: NX4.2 (TWO); also elsewhere on the board
/Nixie Tubes/N3_CAT3: NX4.3 (THREE); also elsewhere on the board
/Nixie Tubes/N3_CAT4: NX4.5 (FIVE); also elsewhere on the board
/Nixie Tubes/N3_CAT5: NX4.4 (FOUR); also elsewhere on the board
/Nixie Tubes/N3_CAT6: NX4.6 (SIX); also elsewhere on the board
/Nixie Tubes/N3_CAT7: NX4.7 (SEVEN); also elsewhere on the board
/Nixie Tubes/N3_CAT8: NX4.8 (EIGHT); also elsewhere on the board
/Nixie Tubes/N3_CAT9: NX4.9 (NINE); also elsewhere on the board

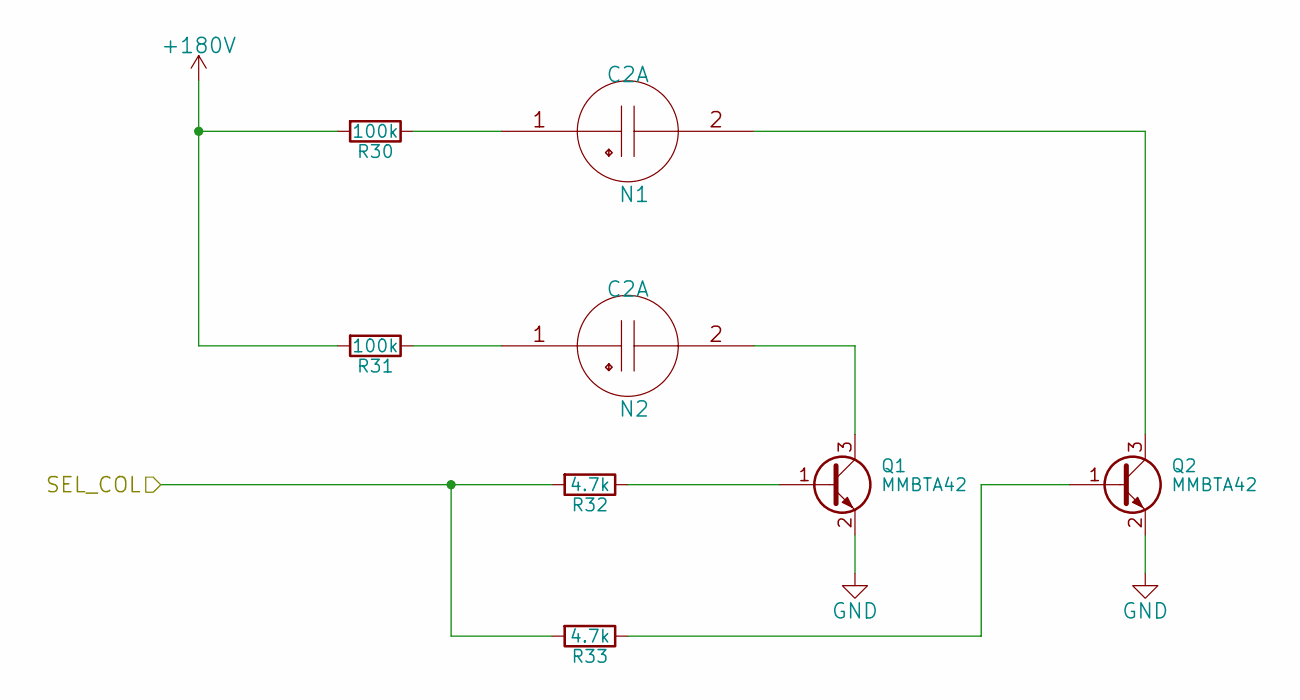
[picture p64: schematic colon_tubes.sch, Tube Shield]

Parts:
N1, N2: C2A; neon_ind
Q1, Q2: MMBTA42; SOT-23_Handsoldering
R30, R31: 100k; R_1206_HandSoldering
R32, R33: 4.7k; R_0805_HandSoldering

Connections:
+180V: R30.2, R31.2; also elsewhere on the board
/COL_SEL: R32.2, R33.2; also elsewhere on the board
GND: Q1.2 (E), Q2.2 (E); also elsewhere on the board
unnamed: N1.1, R30.1
unnamed: N1.2, Q2.3 (C)
unnamed: N2.1, R31.1
unnamed: N2.2, Q1.3 (C)
unnamed: Q1.1 (B), R32.1
unnamed: Q2.1 (B), R33.1
