wildwoodashes/nixie_clock/hw/kicad_v1_1/projects/tube_shield/tube_shield.kicad_pcb

## KiCad design hw/kicad_v1_1/projects/tube_shield/tube_shield.kicad_pcb (continued)

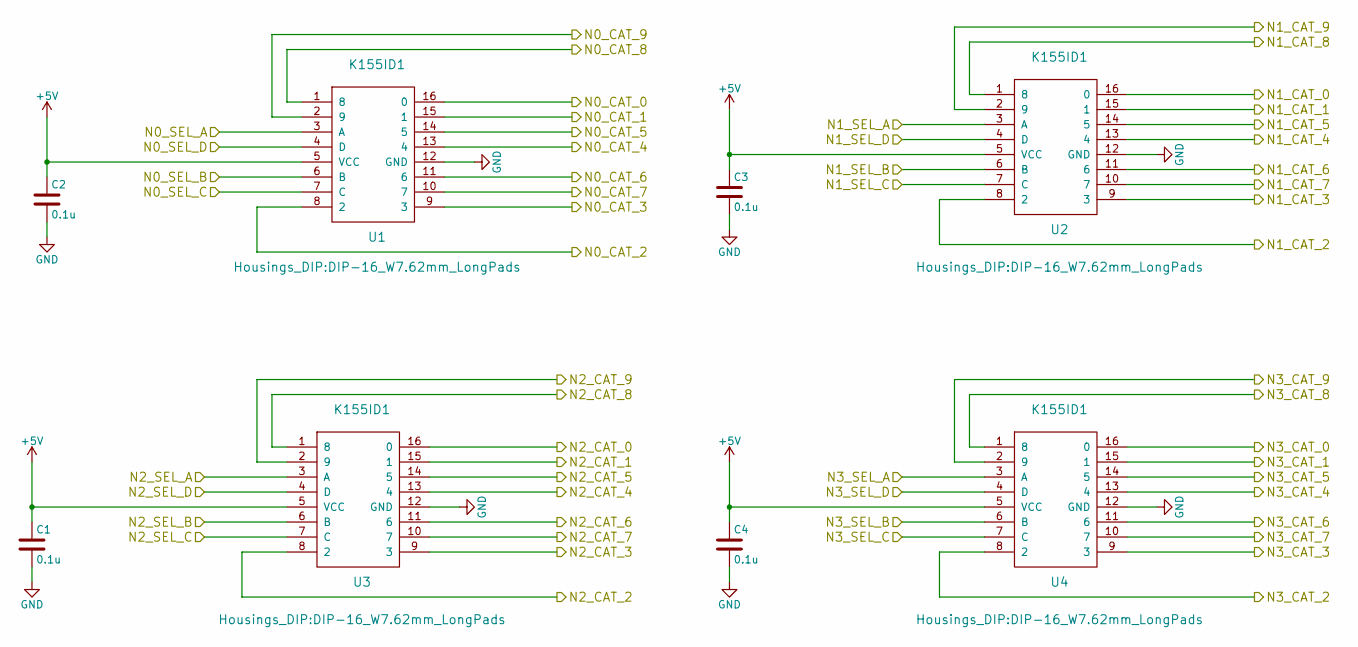
[picture p65: schematic nixie_control.sch, Tube Shield]

Parts:
C1, C2, C3, C4: 0.1u; C_0805_HandSoldering
U1, U2, U3, U4: K155ID1; DIP-16_W7.62mm_LongPads

Connections:
+5V: C1.1, C2.1, C3.1, C4.1, U1.5 (VCC), U2.5 (VCC), U3.5 (VCC), U4.5 (VCC); also elsewhere on the board
/N0_SEL_A: U1.3 (A); also elsewhere on the board
/N0_SEL_B: U1.6 (B); also elsewhere on the board
/N0_SEL_C: U1.7 (C); also elsewhere on the board
/N0_SEL_D: U1.4 (D); also elsewhere on the board
/N1_SEL_A: U2.3 (A); also elsewhere on the board
/N1_SEL_B: U2.6 (B); also elsewhere on the board
/N1_SEL_C: U2.7 (C); also elsewhere on the board
/N1_SEL_D: U2.4 (D); also elsewhere on the board
/N2_SEL_A: U3.3 (A); also elsewhere on the board
/N2_SEL_B: U3.6 (B); also elsewhere on the board
/N2_SEL_C: U3.7 (C); also elsewhere on the board
/N2_SEL_D: U3.4 (D); also elsewhere on the board
/N3_SEL_A: U4.3 (A); also elsewhere on the board
/N3_SEL_B: U4.6 (B); also elsewhere on the board
/N3_SEL_C: U4.7 (C); also elsewhere on the board
/N3_SEL_D: U4.4 (D); also elsewhere on the board
/Nixie Tubes/N0_CAT0: U1.16 (0); also elsewhere on the board
/Nixie Tubes/N0_CAT1: U1.15 (1); also elsewhere on the board
/Nixie Tubes/N0_CAT2: U1.8 (2); also elsewhere on the board
/Nixie Tubes/N0_CAT3: U1.9 (3); also elsewhere on the board
/Nixie Tubes/N0_CAT4: U1.13 (4); also elsewhere on the board
/Nixie Tubes/N0_CAT5: U1.14 (5); also elsewhere on the board
/Nixie Tubes/N0_CAT6: U1.11 (6); also elsewhere on the board
/Nixie Tubes/N0_CAT7: U1.10 (7); also elsewhere on the board
/Nixie Tubes/N0_CAT8: U1.1 (8); also elsewhere on the board
/Nixie Tubes/N0_CAT9: U1.2 (9); also elsewhere on the board
/Nixie Tubes/N1_CAT0: U2.16 (0); also elsewhere on the board
/Nixie Tubes/N1_CAT1: U2.15 (1); also elsewhere on the board
/Nixie Tubes/N1_CAT2: U2.8 (2); also elsewhere on the board
/Nixie Tubes/N1_CAT3: U2.9 (3); also elsewhere on the board
/Nixie Tubes/N1_CAT4: U2.13 (4); also elsewhere on the board
/Nixie Tubes/N1_CAT5: U2.14 (5); also elsewhere on the board
/Nixie Tubes/N1_CAT6: U2.11 (6); also elsewhere on the board
/Nixie Tubes/N1_CAT7: U2.10 (7); also elsewhere on the board
/Nixie Tubes/N1_CAT8: U2.1 (8); also elsewhere on the board
/Nixie Tubes/N1_CAT9: U2.2 (9); also elsewhere on the board
/Nixie Tubes/N2_CAT0: U3.16 (0); also elsewhere on the board
/Nixie Tubes/N2_CAT1: U3.15 (1); also elsewhere on the board
/Nixie Tubes/N2_CAT2: U3.8 (2); also elsewhere on the board
/Nixie Tubes/N2_CAT3: U3.9 (3); also elsewhere on the board
/Nixie Tubes/N2_CAT4: U3.13 (4); also elsewhere on the board
/Nixie Tubes/N2_CAT5: U3.14 (5); also elsewhere on the board
/Nixie Tubes/N2_CAT6: U3.11 (6); also elsewhere on the board
/Nixie Tubes/N2_CAT7: U3.10 (7); also elsewhere on the board
/Nixie Tubes/N2_CAT8: U3.1 (8); also elsewhere on the board
/Nixie Tubes/N2_CAT9: U3.2 (9); also elsewhere on the board
/Nixie Tubes/N3_CAT0: U4.16 (0); also elsewhere on the board
/Nixie Tubes/N3_CAT1: U4.15 (1); also elsewhere on the board
/Nixie Tubes/N3_CAT2: U4.8 (2); also elsewhere on the board
/Nixie Tubes/N3_CAT3: U4.9 (3); also elsewhere on the board
/Nixie Tubes/N3_CAT4: U4.13 (4); also elsewhere on the board
/Nixie Tubes/N3_CAT5: U4.14 (5); also elsewhere on the board
/Nixie Tubes/N3_CAT6: U4.11 (6); also elsewhere on the board
/Nixie Tubes/N3_CAT7: U4.10 (7); also elsewhere on the board
/Nixie Tubes/N3_CAT8: U4.1 (8); also elsewhere on the board
/Nixie Tubes/N3_CAT9: U4.2 (9); also elsewhere on the board
GND: C1.2, C2.2, C3.2, C4.2, U1.12 (GND), U2.12 (GND), U3.12 (GND), U4.12 (GND); also elsewhere on the board

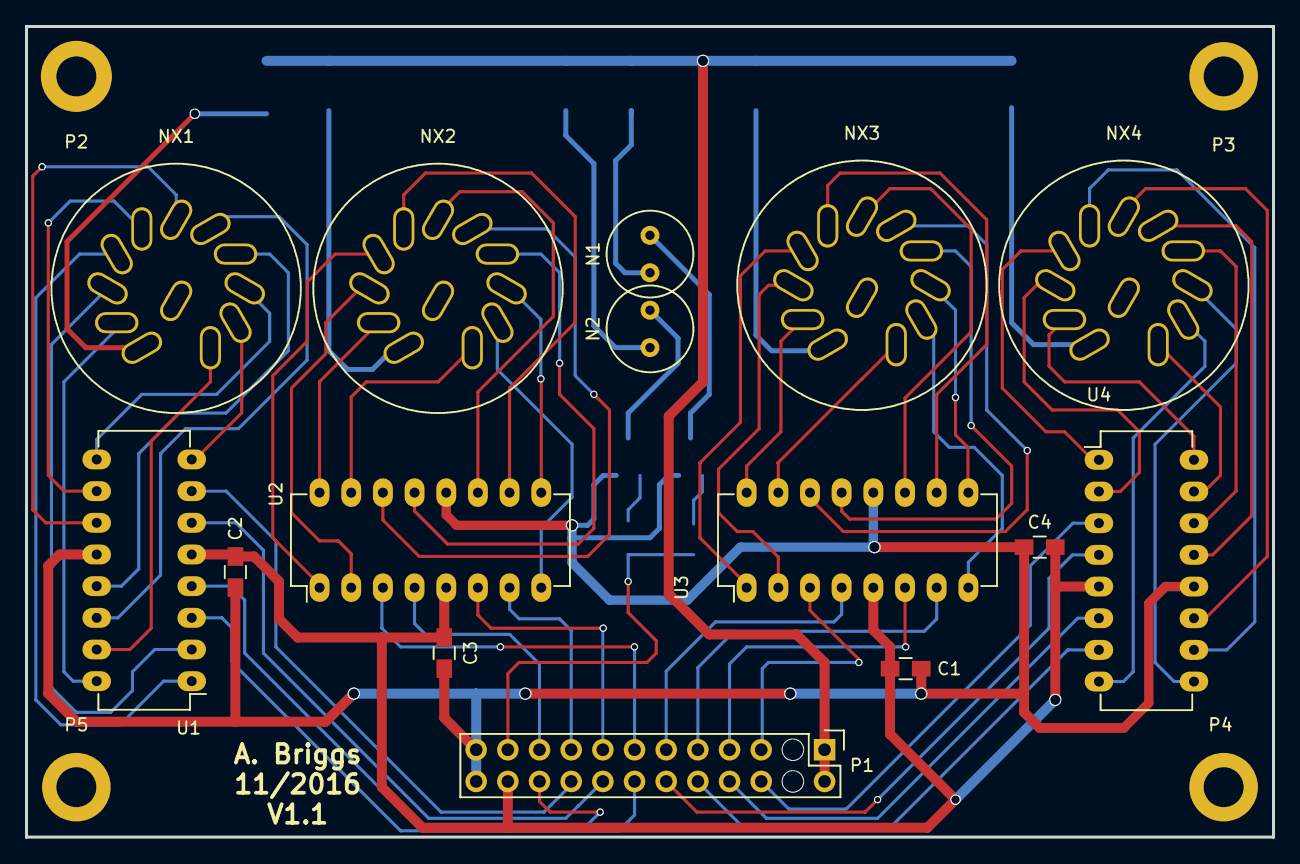
[picture p66: board hw/kicad_v1_1/projects/tube_shield/tube_shield.kicad_pcb from above]

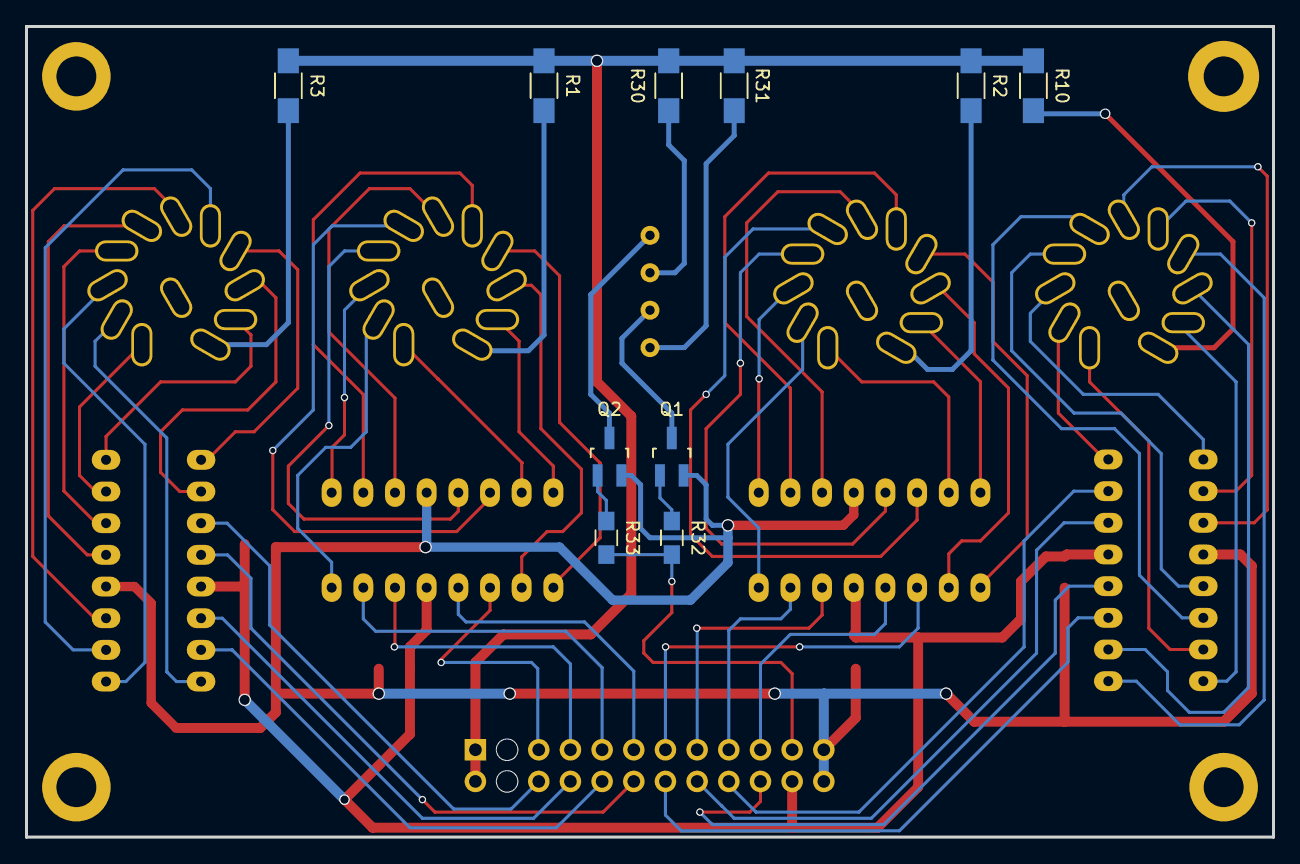
[picture p67: board hw/kicad_v1_1/projects/tube_shield/tube_shield.kicad_pcb from below]

Board: 2 copper layers, 100.0 x 65.0 mm, 29 parts (10 on the bottom side), 70 nets.
