wildwoodashes/nixie_clock/hw/kicad_v1_0/projects/tube_shield/tube_shield.kicad_pcb

## KiCad design hw/kicad_v1_0/projects/tube_shield/tube_shield.kicad_pcb (2016-09-27, an earlier design)

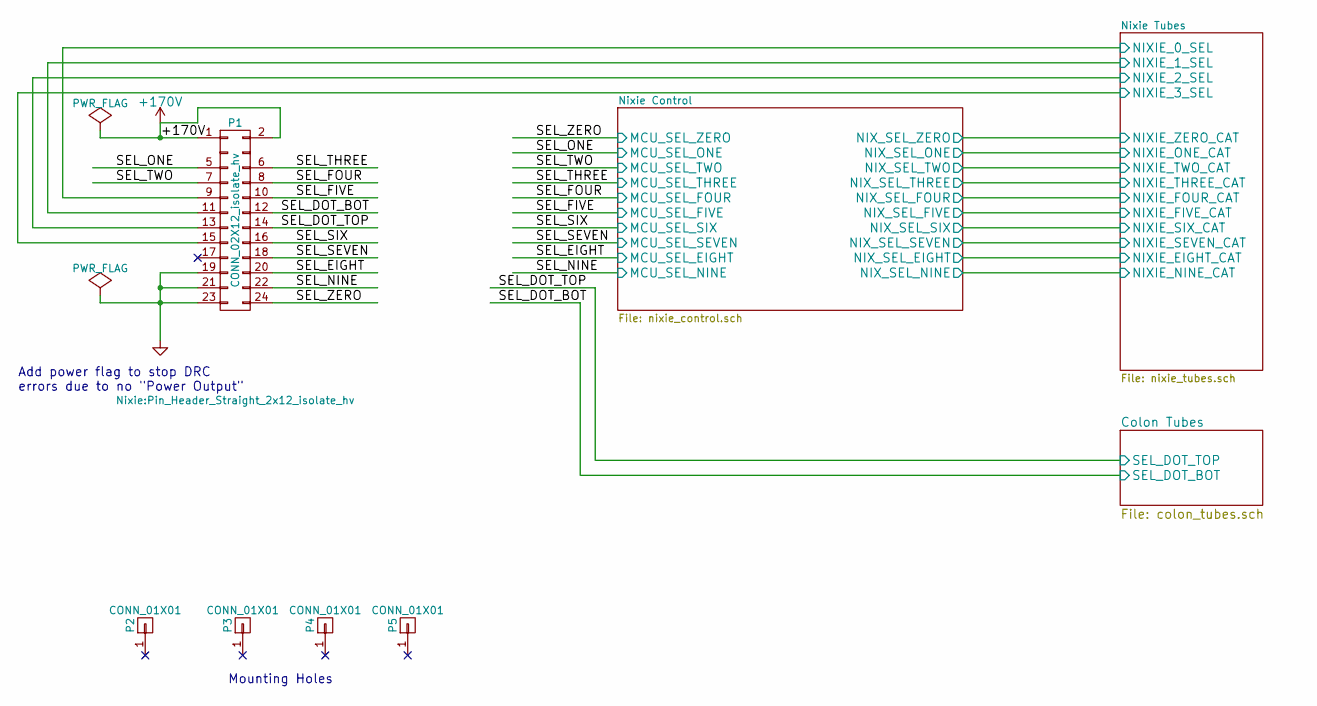
[picture p68: schematic tube_shield.sch, Tube Shield]

Parts:
P1: CONN_02X12_isolate_hv; Pin_Header_Straight_2x12_isolate_hv
P2: CONN_01X01; MountingHole_3.2mm_M3_ISO7380_Pad
P3, P4, P5: CONN_01X01; MountingHole_3.2mm_M3_ISO14580_Pad

Connections:
+170V: P1.1, P1.2; also elsewhere on the board
/Colon Tubes/SEL_DOT_BOT: P1.12; also elsewhere on the board
/Colon Tubes/SEL_DOT_TOP: P1.14; also elsewhere on the board
/Nixie Control/MCU_SEL_EIGHT: P1.20; also elsewhere on the board
/Nixie Control/MCU_SEL_FIVE: P1.10; also elsewhere on the board
/Nixie Control/MCU_SEL_FOUR: P1.8; also elsewhere on the board
/Nixie Control/MCU_SEL_NINE: P1.22; also elsewhere on the board
/Nixie Control/MCU_SEL_ONE: P1.5; also elsewhere on the board
/Nixie Control/MCU_SEL_SEVEN: P1.18; also elsewhere on the board
/Nixie Control/MCU_SEL_SIX: P1.16; also elsewhere on the board
/Nixie Control/MCU_SEL_THREE: P1.6; also elsewhere on the board
/Nixie Control/MCU_SEL_TWO: P1.7; also elsewhere on the board
/Nixie Control/MCU_SEL_ZERO: P1.24; also elsewhere on the board
/Nixie Tubes/NIXIE_0_SEL: P1.9; also elsewhere on the board
/Nixie Tubes/NIXIE_1_SEL: P1.11; also elsewhere on the board
/Nixie Tubes/NIXIE_2_SEL: P1.13; also elsewhere on the board
/Nixie Tubes/NIXIE_3_SEL: P1.15; also elsewhere on the board
GND: P1.19, P1.21, P1.23; also elsewhere on the board

Notes on the sheet:
Add power flag to stop DRC errors due to no "Power Output"
Mounting Holes

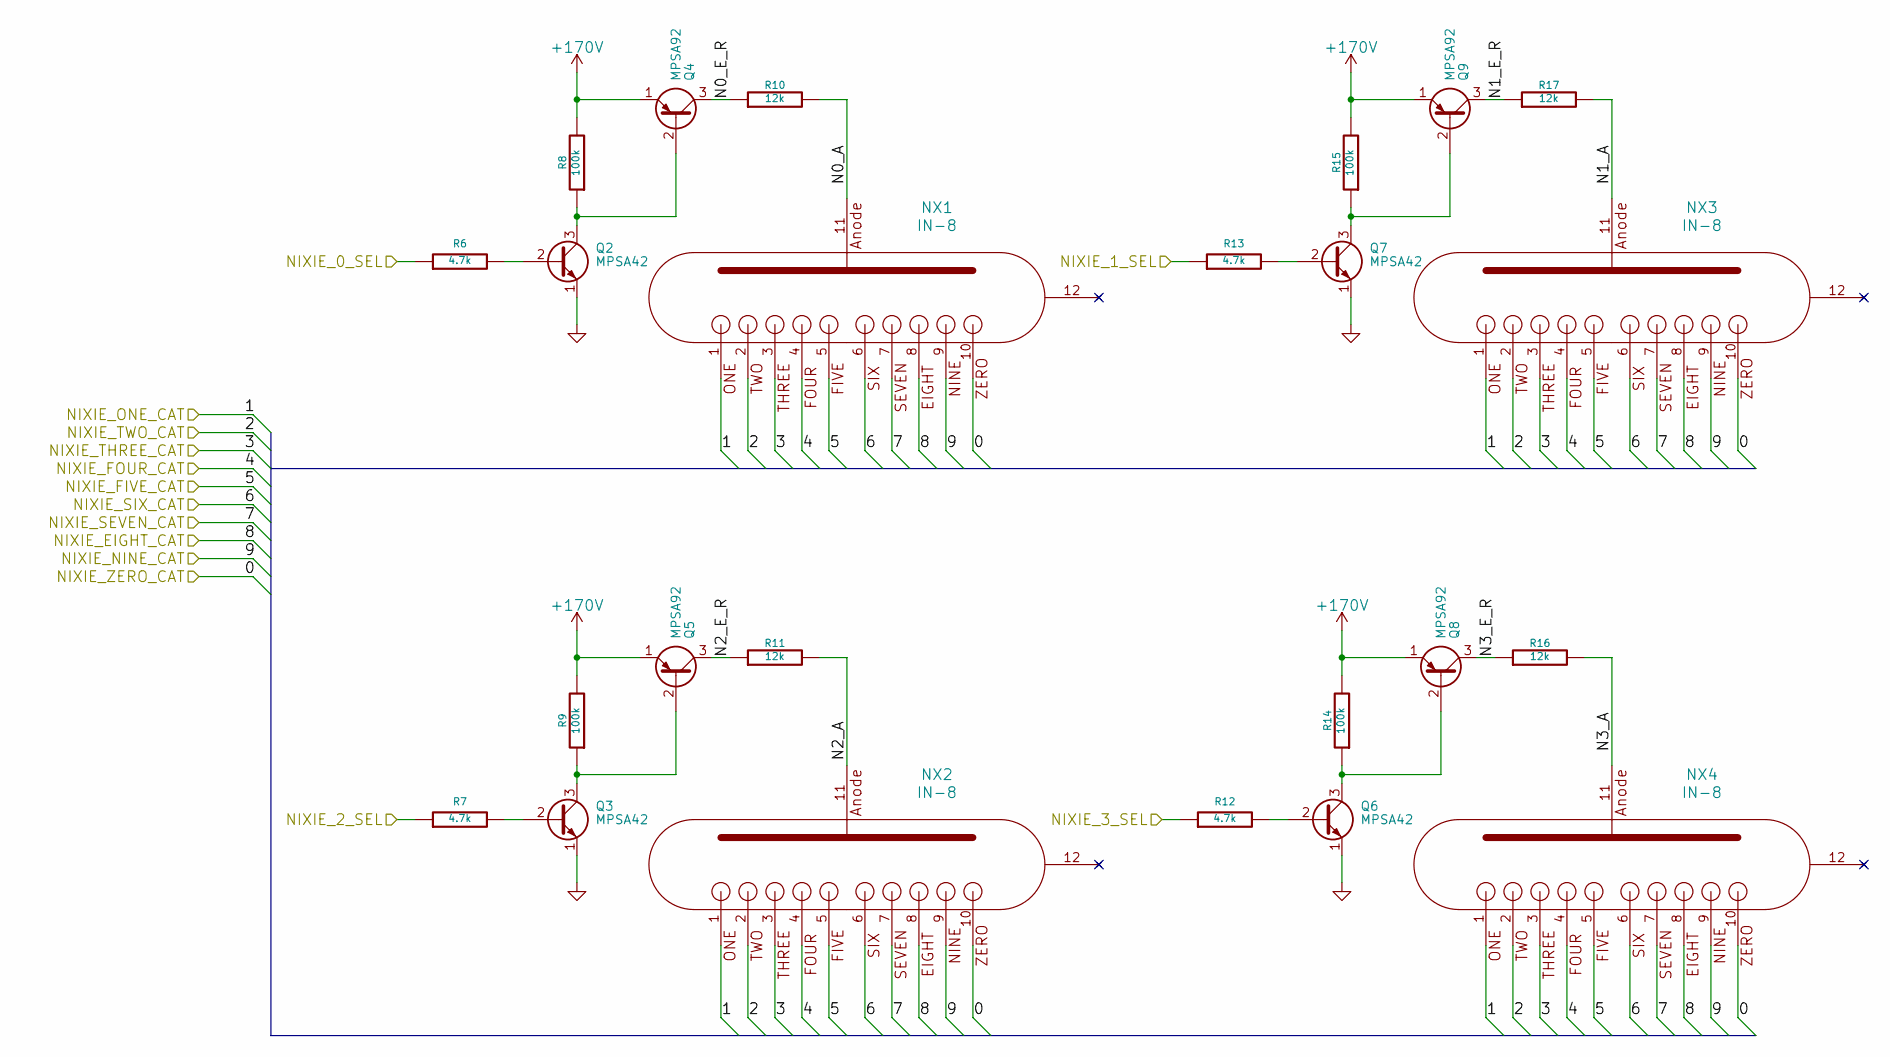
[picture p69: schematic nixie_tubes.sch, Tube Shield]

Parts:
NX1, NX2, NX3, NX4: IN-8; pl27-1pd
Q2, Q3, Q6, Q7: MPSA42; SOT-23_Handsoldering
Q4, Q5, Q8, Q9: MPSA92; SOT-23_Handsoldering
R6, R7, R12, R13: 4.7k; R_0805_HandSoldering
R8, R9, R14, R15: 100k; R_0805_HandSoldering
R10, R11, R16, R17: 12k; R_0805_HandSoldering

Connections:
+170V: Q4.1 (E), Q5.1 (E), Q8.1 (E), Q9.1 (E), R8.2, R9.2, R14.2, R15.2; also elsewhere on the board
/Nixie Tubes/N0_A: NX1.11 (Anode), R10.2
/Nixie Tubes/N0_E_R: Q4.3 (C), R10.1
/Nixie Tubes/N1_A: NX3.11 (Anode), R17.2
/Nixie Tubes/N1_E_R: Q9.3 (C), R17.1
/Nixie Tubes/N2_A: NX2.11 (Anode), R11.2
/Nixie Tubes/N2_E_R: Q5.3 (C), R11.1
/Nixie Tubes/N3_A: NX4.11 (Anode), R16.2
/Nixie Tubes/N3_E_R: Q8.3 (C), R16.1
/Nixie Tubes/NIXIE_0_SEL: R6.1; also elsewhere on the board
/Nixie Tubes/NIXIE_1_SEL: R13.1; also elsewhere on the board
/Nixie Tubes/NIXIE_2_SEL: R7.1; also elsewhere on the board
/Nixie Tubes/NIXIE_3_SEL: R12.1; also elsewhere on the board
/Nixie Tubes/NIXIE_EIGHT_CAT: NX1.8 (EIGHT), NX2.8 (EIGHT), NX3.8 (EIGHT), NX4.8 (EIGHT); also elsewhere on the board
/Nixie Tubes/NIXIE_FIVE_CAT: NX1.5 (FIVE), NX2.5 (FIVE), NX3.5 (FIVE), NX4.5 (FIVE); also elsewhere on the board
/Nixie Tubes/NIXIE_FOUR_CAT: NX1.4 (FOUR), NX2.4 (FOUR), NX3.4 (FOUR), NX4.4 (FOUR); also elsewhere on the board
/Nixie Tubes/NIXIE_NINE_CAT: NX1.9 (NINE), NX2.9 (NINE), NX3.9 (NINE), NX4.9 (NINE); also elsewhere on the board
/Nixie Tubes/NIXIE_ONE_CAT: NX1.1 (ONE), NX2.1 (ONE), NX3.1 (ONE), NX4.1 (ONE); also elsewhere on the board
/Nixie Tubes/NIXIE_SEVEN_CAT: NX1.7 (SEVEN), NX2.7 (SEVEN), NX3.7 (SEVEN), NX4.7 (SEVEN); also elsewhere on the board
/Nixie Tubes/NIXIE_SIX_CAT: NX1.6 (SIX), NX2.6 (SIX), NX3.6 (SIX), NX4.6 (SIX); also elsewhere on the board
/Nixie Tubes/NIXIE_THREE_CAT: NX1.3 (THREE), NX2.3 (THREE), NX3.3 (THREE), NX4.3 (THREE); also elsewhere on the board
/Nixie Tubes/NIXIE_TWO_CAT: NX1.2 (TWO), NX2.2 (TWO), NX3.2 (TWO), NX4.2 (TWO); also elsewhere on the board
/Nixie Tubes/NIXIE_ZERO_CAT: NX1.10 (ZERO), NX2.10 (ZERO), NX3.10 (ZERO), NX4.10 (ZERO); also elsewhere on the board
GND: Q2.1 (E), Q3.1 (E), Q6.1 (E), Q7.1 (E); also elsewhere on the board
unnamed: Q2.2 (B), R6.2
unnamed: Q2.3 (C), Q4.2 (B), R8.1
unnamed: Q3.2 (B), R7.2
unnamed: Q3.3 (C), Q5.2 (B), R9.1
unnamed: Q6.2 (B), R12.2
unnamed: Q6.3 (C), Q8.2 (B), R14.1
unnamed: Q7.2 (B), R13.2
unnamed: Q7.3 (C), Q9.2 (B), R15.1

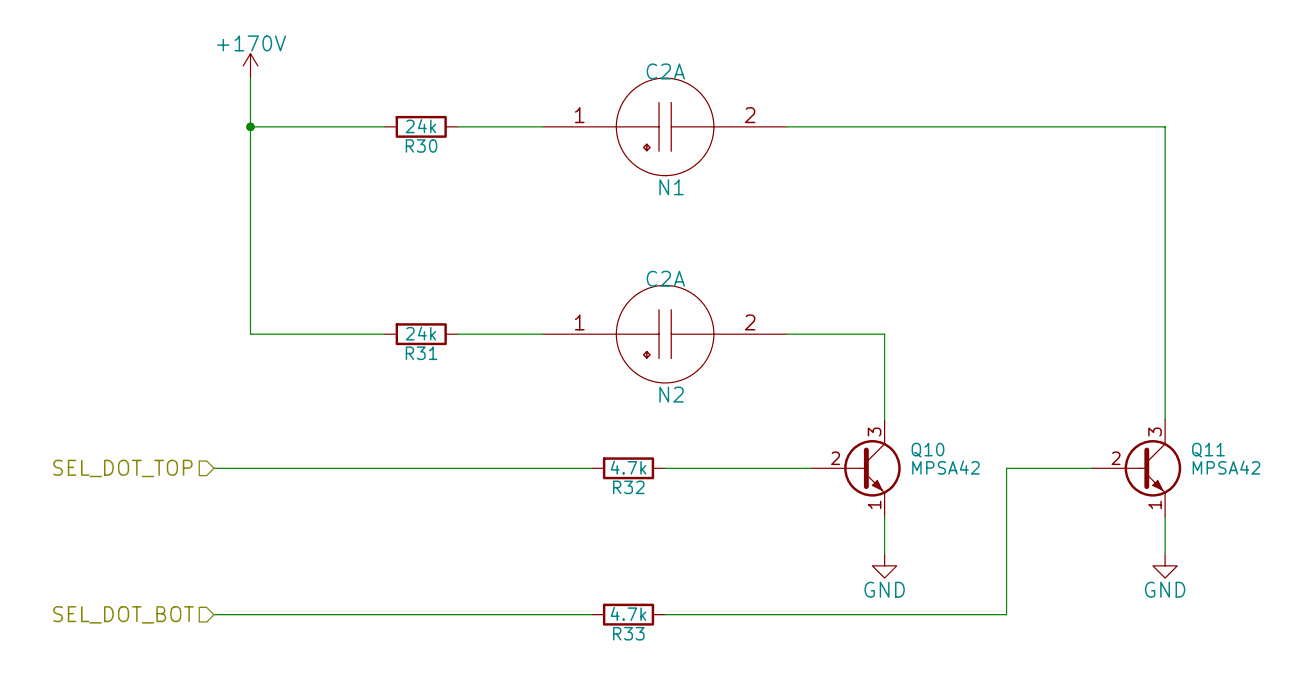
[picture p70: schematic colon_tubes.sch, Tube Shield]

Parts:
N1, N2: C2A; neon_ind
Q10, Q11: MPSA42; SOT-23_Handsoldering
R30, R31: 24k; R_0805_HandSoldering
R32, R33: 4.7k; R_0805_HandSoldering

Connections:
+170V: R30.2, R31.2; also elsewhere on the board
/Colon Tubes/SEL_DOT_BOT: R33.2; also elsewhere on the board
/Colon Tubes/SEL_DOT_TOP: R32.2; also elsewhere on the board
GND: Q10.1 (E), Q11.1 (E); also elsewhere on the board
unnamed: N1.1, R30.1
unnamed: N1.2, Q11.3 (C)
unnamed: N2.1, R31.1
unnamed: N2.2, Q10.3 (C)
unnamed: Q10.2 (B), R32.1
unnamed: Q11.2 (B), R33.1

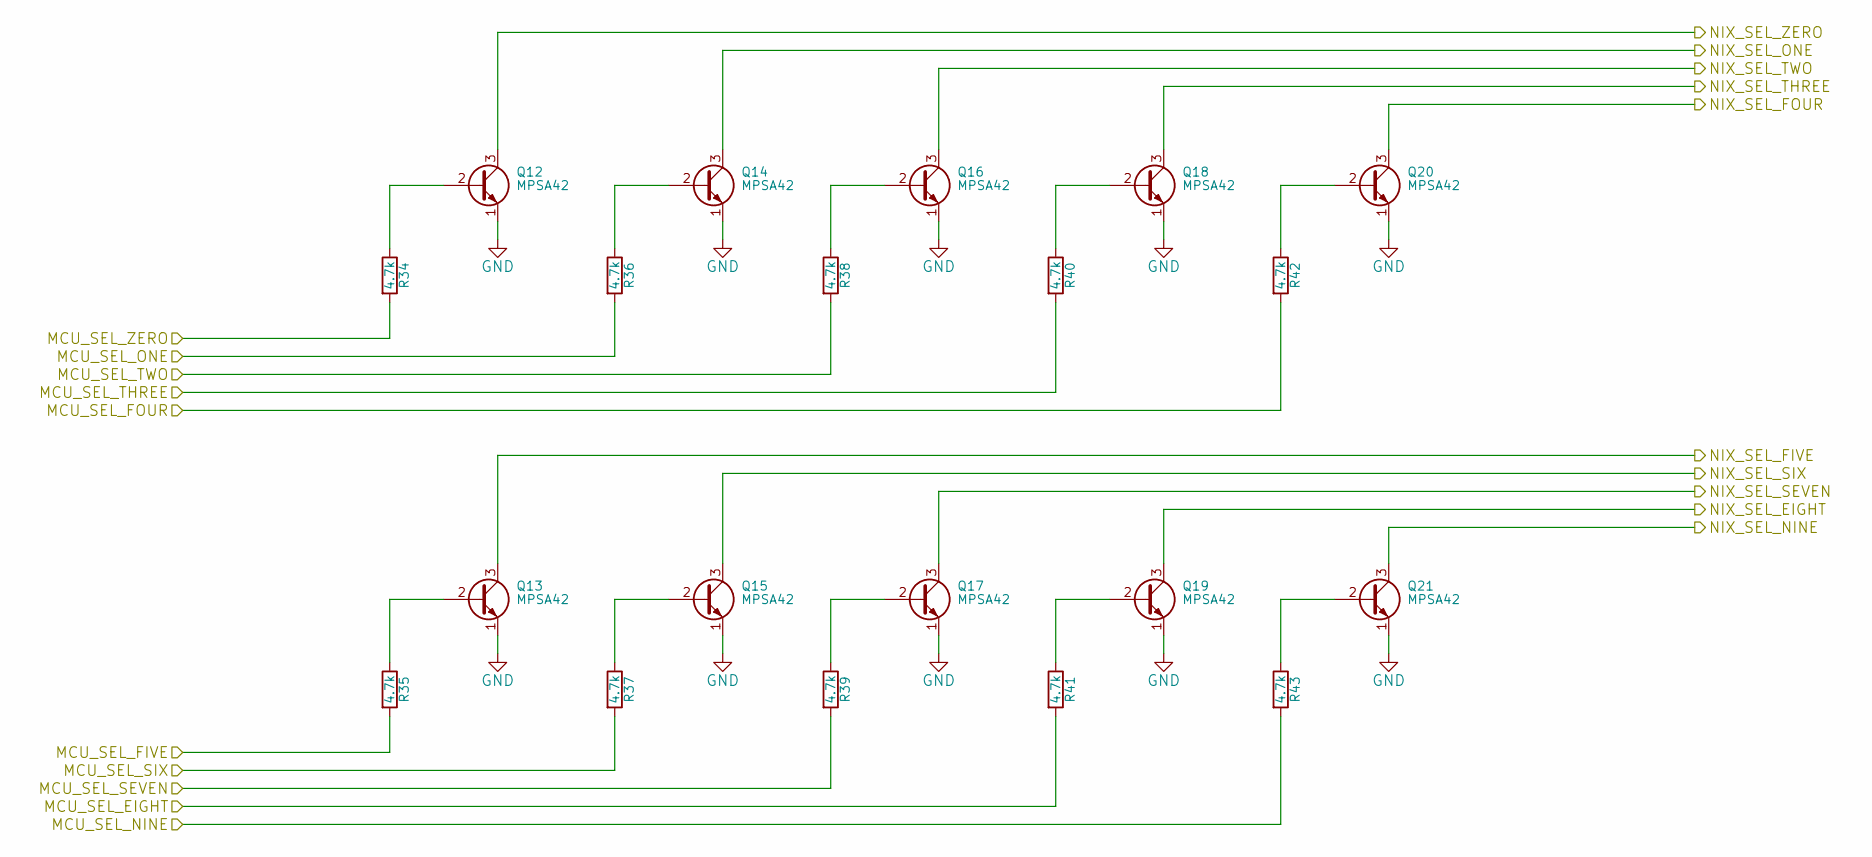
[picture p71: schematic nixie_control.sch, Tube Shield]

Parts:
Q12, Q13, Q14, Q15, Q16, Q17, Q18, Q19, Q20, Q21: MPSA42; SOT-23_Handsoldering
R34, R35, R36, R37, R38, R39, R40, R41, R42, R43: 4.7k; R_0805_HandSoldering

Connections:
/Nixie Control/MCU_SEL_EIGHT: R41.2; also elsewhere on the board
/Nixie Control/MCU_SEL_FIVE: R35.2; also elsewhere on the board
/Nixie Control/MCU_SEL_FOUR: R42.2; also elsewhere on the board
/Nixie Control/MCU_SEL_NINE: R43.2; also elsewhere on the board
/Nixie Control/MCU_SEL_ONE: R36.2; also elsewhere on the board
/Nixie Control/MCU_SEL_SEVEN: R39.2; also elsewhere on the board
/Nixie Control/MCU_SEL_SIX: R37.2; also elsewhere on the board
/Nixie Control/MCU_SEL_THREE: R40.2; also elsewhere on the board
/Nixie Control/MCU_SEL_TWO: R38.2; also elsewhere on the board
/Nixie Control/MCU_SEL_ZERO: R34.2; also elsewhere on the board
/Nixie Tubes/NIXIE_EIGHT_CAT: Q19.3 (C); also elsewhere on the board
/Nixie Tubes/NIXIE_FIVE_CAT: Q13.3 (C); also elsewhere on the board
/Nixie Tubes/NIXIE_FOUR_CAT: Q20.3 (C); also elsewhere on the board
/Nixie Tubes/NIXIE_NINE_CAT: Q21.3 (C); also elsewhere on the board
/Nixie Tubes/NIXIE_ONE_CAT: Q14.3 (C); also elsewhere on the board
/Nixie Tubes/NIXIE_SEVEN_CAT: Q17.3 (C); also elsewhere on the board
/Nixie Tubes/NIXIE_SIX_CAT: Q15.3 (C); also elsewhere on the board
/Nixie Tubes/NIXIE_THREE_CAT: Q18.3 (C); also elsewhere on the board
/Nixie Tubes/NIXIE_TWO_CAT: Q16.3 (C); also elsewhere on the board
/Nixie Tubes/NIXIE_ZERO_CAT: Q12.3 (C); also elsewhere on the board
GND: Q12.1 (E), Q13.1 (E), Q14.1 (E), Q15.1 (E), Q16.1 (E), Q17.1 (E), Q18.1 (E), Q19.1 (E), Q20.1 (E), Q21.1 (E); also elsewhere on the board
unnamed: Q12.2 (B), R34.1
unnamed: Q13.2 (B), R35.1
unnamed: Q14.2 (B), R36.1
unnamed: Q15.2 (B), R37.1
unnamed: Q16.2 (B), R38.1
unnamed: Q17.2 (B), R39.1
unnamed: Q18.2 (B), R40.1
unnamed: Q19.2 (B), R41.1
unnamed: Q20.2 (B), R42.1
unnamed: Q21.2 (B), R43.1

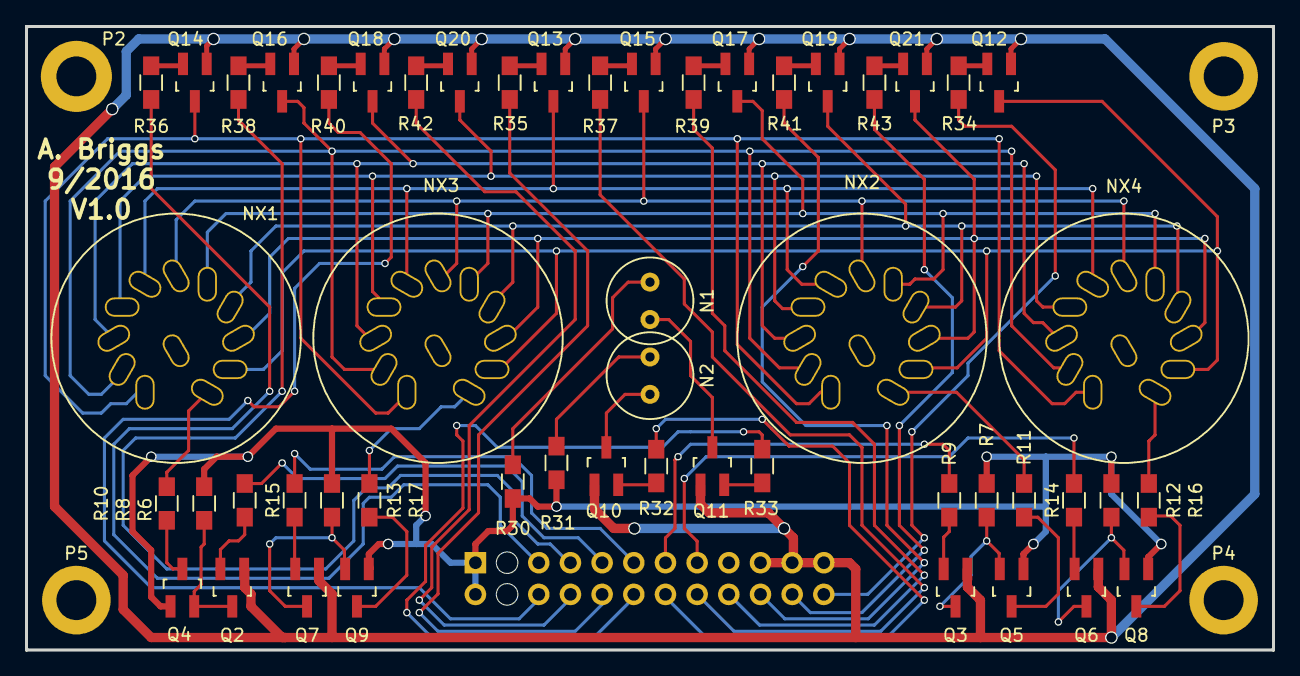
[picture p72: board hw/kicad_v1_0/projects/tube_shield/tube_shield.kicad_pcb from above]

Board: 2 copper layers, 100.0 x 50.0 mm, 57 parts (1 on the bottom side), 60 nets.
