wildwoodashes/nixie_clock/(commit log)

2016-09-29 Update documentation
    Update PDF of schematic and BOM.
    [system_bom.csv]
2016-10-12 Initial code commit
    This is the initial code commit. It is adapted from the previous "power
    supply" project.
    [system_bom.csv]
2016-10-17 Switch tube_board to driver chips
    Convert from Mux'd control to direct drive with 74141 based chips.
    Increase size of board. Should probably reduce this as it looks like the
    board is too large.
    [colon_tubes.sch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]
2016-11-06 Update
    Begin work on updating for rev1.1.
    [colon_tubes.sch, mch_shift.sch, mcu.sch, mcu_power_supply.sch, mcu_rtc.sch, tube_shield.kicad_pcb, tube_shield.sch]
2016-11-07 Schematic Work Complete
    Check in schematic work before touching PCB. This should give me a point
    to go back to if it all goes to hell.
    [control_board.sch, mch_shift.sch, mcu.sch, mcu_power_supply.sch, mcu_rtc.sch, nixie_power_supply.sch]
2016-11-11 Updates to BOM
    Start to update BOM for 180V supply
    [control_board.kicad_pcb, control_board.sch, mch_shift.sch, mcu.sch, mcu_power_supply.sch, mcu_rtc.sch, nixie_power_supply.sch]
2016-11-20 Complete with errors
    Check in before moving header. Currently the headers don't match up. If
    I'm going to connect them with standard header I need to move it
    significantly. Check in as a roll back point.
    [colon_tubes.sch, control_board.kicad_pcb, control_board.sch, mch_shift.sch, mcu.sch, mcu_power_supply.sch, mcu_rtc.sch, nixie_power_supply.sch]
2016-12-23 Final Release
    Update with trimming and bug fixes. This is what is being delivered as a
    V1.1.0 release.
    [complete_bom.csv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]
2016-12-24 Fix issue with interrupt lock up
    Resolved issue caused by interrupt locking up the I2C.
    [atmega48.c, rtc.c]
